shakeyo/MY-VAN/modules/09-shower-module/README.md

# 淋浴模块

帘式湿区 + 快拆防水盘，解决房车淋浴空间与日常活动的矛盾。固定式淋浴房占用面积过大（至少 0.6m²），对 V80 短轴车型不现实。帘式方案淋浴时拉开，平时收起，同一块地面既是过道又是淋浴区。

**核心思路**：用时展开、用完消失。防水帘沿顶部滑轨拉开围成湿区，防水盘快拆设计方便年审恢复。排水重力自流至灰水箱，无需电动排水泵。

## 子文档

| 文件 | 内容 | 状态 |
|---|---|---|
| [design.md](design.md) | 系统设计：帘轨、防水帘、防水盘、排水 | 设计中 |
| [bom.md](bom.md) | 材料清单 | 待补充 |

## 子系统

| 子系统 | 说明 | 状态 |
|---|---|---|
| 帘轨 | 顶部环形滑轨，固定于铝型材顶梁 | 待设计 |
| 防水帘 | 涤纶防水布 + 底部磁吸/配重，防飘水 | 待设计 |
| 防水盘 | 快拆式底盘，带地漏接口，可用折叠式或拼接式 | 待设计 |
| 排水快接 | 防水盘地漏 → 灰水箱，重力自流 | 待设计 |

## 车外淋浴

天气好时车外淋浴是主力场景（管路预留见 [05-water-system](../05-water-system/design.md#未来增项预留-车尾车外淋浴)）。车尾横向淋浴帐的完整设计单独成文：

- [车尾横向淋浴帐](../02-external/design-shower-tent.md) —— 车顶平台挂装、4 杆折叠框、卷袋收纳、接水盘、展开/收纳 SOP、BOM

## 跨模块依赖

- 帘轨锚固于 [01-vehicle-layout](../01-vehicle-layout/) 顶梁
- 排水接入 [05-water-system](../05-water-system/) 灰水箱
- 淋浴区地面与周边柜体（[07-cabinetry](../07-cabinetry/)）衔接

## BOM

统一材料清单见 [bom.md](bom.md)。

## 图片

<script setup>
const loaders = Object.values(import.meta.glob('./assets/*.{png,jpg,jpeg,PNG,JPG,JPEG,webp}', { eager: false }))
</script>

<AutoGallery :loaders="loaders" />
