shakeyo/MY-VAN/modules/06-hvac/README.md

# HVAC 系统

驻车空调、柴油暖风、换气扇的选型与安装。房车 HVAC 的特殊约束：驻车时不能用原车空调（需发动机运转），因此必须独立制冷/制热；车内空间小（~10m³），温度变化极快，设备功率需要匹配而非越大越好。

**核心思路**：制冷走顶、制热走地、换气走中。冷气下沉从顶棚出风，暖气上升从地板出风，换气扇在中部形成对流。能效优先——空调选变频、暖风用柴油（热值高且与车辆共用燃油）。

## 子文档

| 文件 | 内容 | 状态 |
|---|---|---|
| [design.md](design.md) | 系统设计：空调、暖风、换气扇选型与布局 | 设计中 |
| [bom.md](bom.md) | 材料清单 | 待补充 |

## 子系统

| 子系统 | 说明 | 状态 |
|---|---|---|
| 驻车空调 | 48V 变频顶置或分体空调，制冷量匹配车内面积 | 设计中 |
| 柴油暖风 | 驻车加热器，取油自原车油箱，暖风管走地板 | 设计中 |
| 换气扇 | 双向换气扇（排风+进风），中部安装形成对流 | 待设计 |
| 风道 | 出风口位置、管路走线、隔热包扎 | 待设计 |

## 跨模块依赖

- 空调外机安装位由 [01-vehicle-layout](../01-vehicle-layout/) 和 [02-external](../02-external/) 提供
- 供电由 [04-power-system](../04-power-system/) 48V 回路独立保险
- 柴油暖风取油需与底盘油路协同
- 换气扇开孔由 [00-chassis](../00-chassis/) 或侧壁开孔规范约束

## BOM

统一材料清单见 [bom.md](bom.md)。

## 图片

<script setup>
const loaders = Object.values(import.meta.glob('./assets/*.{png,jpg,jpeg,PNG,JPG,JPEG,webp}', { eager: false }))
</script>

<AutoGallery :loaders="loaders" />
