shakeyo/MY-VAN/modules/10-smart-control/media/README.md

# 监控与音响

视觉监控（DVR/Frigate）与全车音响（Alpine DSP）。

| 文件 | 内容 |
|---|---|
| [design.md](design.md) | 监控架构 + 音响架构 + 声场模式 |
| [bom.md](bom.md) | 材料清单 |

## 边界

- 额头柜喇叭物理安装位见 [07-cabinetry](../../07-cabinetry/)
- 娱乐场景（投影/显示器）音频输入切换见 [11-entertainment](../../11-entertainment/)
