shakeyo/MY-VAN/modules/04-power-system/design-distribution-box.md

# 中门智能配电箱

## 一、系统边界与物理布局

| 区域 | 归属 | 说明 |
|---|---|---|
| 额头柜配电箱 | 独立系统 | 48V 降压供点烟口、原车鼓风机、DSP、低音炮、MPPT 等，与本箱无关 |
| 中门配电箱 | 本方案范围 | 48V 进线 → 48V 水泵 + DCDC 降压 → 12V 灯/风扇/冰箱/控制 |
| 踏步 | 功率接原车电瓶 | 本箱仅出干接点控制信号 |
| 车内锁 | 12V 供电 | 由本箱 12V 回路经继电器控制 |

### 1.1 箱内物理布局

箱内布局正视图

```
┌─────────────────────────────────────────────────────┐
│  [降压器]          [48V保险盒]                       │
│  48V→12V           48V总分配+保护                    │
│                                                      │
│  [12V保险盒]        [负极端子排(桥接)]                    │
│  12V分配+保护       全系统负极汇流点                   │
│                                                      │
│  [8路485继电器模块] 右下，切所有负载                   │
│                                                      │
│  [端子排 功率区]    [端子排 控制区]                    │
│  底部               底部                              │
└─────────────────────────────────────────────────────┘
```

| 位置 | 设备 | 功能 |
|---|---|---|
| 左上 | 降压器 | 48V→12V 转换，40A |
| 右上 | 48V 保险盒 | 48V 总分配 + 保护 |
| 中左 | 12V 保险盒 | 12V 分配 + 保护 |
| 中部 | 负极端子排 | 黑端子 + 短接片桥接，暂代铜排；全系统负极汇流点 |
| 右下 | 8 路 485 继电器模块 | 逻辑控制 + 功率切换（详见 switch-assignment.md） |
| 底部 | 端子排 | 红色正极区 + 黑色负极区（桥接）+ 控制区（红/黑） |

### 1.2 架构图

> 本箱上游链路：电池 + → 源头熔断器 150A → 主断路器 125A（均在电池侧）→ 2×8AWG → 本箱总开关/总保险。整车全景见 [power-architecture.svg](./diagrams/power-architecture.svg)。

整车电力架构单线图

```
48V 电池组
    │
    ├──→ 2×8AWG ──→ [中门配电箱]
    │                   │
    │              [总开关 60A] ──→ [总保险 60A]
    │                   │
    │     ┌─────────────┼─────────────┐
    │     │             │             │
    │  48V保险盒      48V保险盒      DCDC 40A
    │  (动力回路)     (控制/备用)    降压模块
    │     │             │             │
    │  上水泵          接触器线圈    12V输出
    │  (经接触器)     48V供电       │
    │     │                         ▼
    │     │                    [12V保险盒]
    │     │                         │
    │     │         ┌───────────────┼───────────────┐
    │     │         │               │               │
    │  48V汇流排  12V控制系统    12V照明/通风    12V冰箱/锁/水阀
    │     │         │               │               │
    │     └─────────┴───────────────┴───────────────┘
    │                   │
    │              [8路485继电器模块]
    │                   │
    │         ┌─────────┴─────────┐
    │         │                   │
    │    中8/中4 DI → DI主管(14P)→中门柜汇总排    485总线
    │         │
    │    [输出端子排/插头]
    │
    └──→ 原车电瓶（踏步功率，独立）
              ▲
              │ 干接点信号
         [本箱继电器触点]
```

---

## 二、核心走线原则

1. **顺序不可改**: 电源 → 保险盒 → 继电器 COM → 继电器 NO → 端子排 → 负载
2. **正负成对出线**: 每负载的正负两根线成对捆扎同行，正 → 端子排正极区对应位，负 → 负极区（全桥接，任一位）；氛围灯/睡眠灯 4 路正极在 5-8 位并联，负极各自独立位（17/18）
3. **功率与信号分离**: 功率线（粗）与 485 通信线、按钮线（细）分槽走线
4. **非隔离系统共负**: 48V 与 12V 负极在电气上相通，统一回中部负极端子排（短接片桥接）
5. **继电器触点不得接在端子排之后**: 端子排 → 继电器 → 负载 会导致继电器到负载段无保险保护

---

## 三、48V 主配电方案

### 3.1 进线与总保护

| 项目 | 规格 | 接法 |
|---|---|---|
| 总进线 | 2×8AWG 硅胶线（并联） | 正极并联后压 OT8-8 铜鼻 → 总开关输入 |
| 总开关 | 48V DC 隔离开关，≥60A | 柜内最左上方，带明显断开点 |
| 总保险 | 60A 直流保险片/断路器 | 紧挨总开关，正极串联 |
| 总负极 | 2×8AWG 并联 → OT8-8 | 直接压 48V 负极汇流排 |

> 2×8AWG 并联载流约 80A，总保护 60A 留有余量。

### 3.2 48V 保险盒分配（建议 6 路）

| 保险位 | 设备 | 电流 | 线径 | 负极回哪 |
|---|---|---|---|---|
| F48-1 | DCDC 降压模块输入 | 20A | 6mm² | DCDC 48V- → 负极端子排（桥接） |
| F48-2 | 上水泵主回路 | 15A | 2.5mm² | 水泵负极 → 48V 汇流排 |
| F48-3 | 备用 48V 输出 | 5A | 1.0mm² | —（原接触器线圈位，已取消接触器） |
| F48-4 | 备用 48V 输出 | 10A | 1.5mm² | — |
| F48-5 | 备用 48V 输出 | 10A | 1.5mm² | — |
| F48-6 | 备用 48V 输出 | 10A | 1.5mm² | — |

**接线方式**：

- 保险盒总正极输入：6mm² 红线，OT6-6 压保险盒总螺丝
- 保险盒总负极：6mm² 黑线，OT6-6 压 48V 汇流排
- 各路输出：对应线径，OT 铜鼻直接压保险盒分路螺丝
- **大功率回路（F48-1/2）不走 UK 端子排**

---

## 四、12V 子系统方案

### 4.1 DCDC 降压模块

| 项目 | 参数 |
|---|---|
| 输入 | 48V（来自 F48-1） |
| 输出 | 12V / 40A |
| 安装位置 | 配电箱内左上角，周围 5cm 无线缆遮挡散热 |
| 接线 | 48V 输入：6mm² 红线 + 黑线，OT 铜鼻直连；12V 输出：≥10mm² 红线 → 12V 保险盒总正极，黑线 → 负极端子排（桥接） |

> **关键**：必须先确认模块是否隔离型（万用表通断档测 48V- 与 12V-）。非隔离型可在柜内单点连通两个汇流排；隔离型严禁连通。绝大多数 DCDC 为非隔离型。

### 4.2 12V 保险盒分配（12 路箱，现用 7 路，余 5 路预留）

| 保险位 | 设备 | 电流 | 线径 | 负极回哪 |
|---|---|---|---|---|
| F12-1 | 控制系统 + 485 + 电控水阀 + 车内锁 + 踏步 + **ESP32 + 16DO/面板LED**（控制组） | 10A | 1.5mm² | 负极端子排（桥接） |
| F12-2 | 主灯 + 氛围灯 + 睡眠灯 | 10A | 1.5mm² | 负极端子排（桥接） |
| F12-3 | 后窗排气扇（4 小风扇） | 5A | 0.75mm² | 负极端子排（桥接） |
| F12-4 | 冰箱 | 10A | 1.5mm² | 负极端子排（桥接） |
| F12-5 | 点烟器 1（二排座椅后） | 15A | 2.5mm² | 负极端子排（桥接） |
| F12-6 | 点烟器 2（中门柜） | 15A | 2.5mm² | 负极端子排（桥接） |
| **F12-7** | **N100 + 路由器（尾门台面 · 12V 直供）** | **5A** | **1.5~2.5mm²** | 负极端子排（桥接） |

> F12-2 出一根 1.5mm² → 到模块处分叉 → R1.COM + R2.COM。保险盒输出到继电器 COM 段极短（几 cm），安全。

> 氛围灯多路灯带合并为一路，共用一个保险丝 + 一个继电器，出线后在负载端用 WAGO 端子分接。

> **供电归属（三块地 · 控制组 vs 算力组）**：
> - **中门柜**：ESP32 网关 + 16DO 模块 + 两面板 LED 均就地取 12V，挂 **F12-1 控制组**（mA 级，可合一路）。16DO **不占用**点烟器 F12-6。
> - **中门配电柜**：中8/中4 模块供电仍在箱内控制区取，挂 F12-1 控制组。
> - **尾门台面**：N100（12V 直供）+ 路由器挂 **F12-7 独立 5A**，正负极对由中门沿「柜→尾门」路径拉线（与倒车灯同路径可共线槽，但电不共用——倒车灯挂中8.Y7 触点、随灯断电，N100/路由为常电，**绝不挂 Y7 触点后**）。

---

## 五、负极汇流方案（暂用端子排桥接，后期换铜排）

### 5.1 铜排选型

| 项目 | 规格 |
|---|---|
| 材质 | 紫铜镀镍 |
| 尺寸 | 2mm 厚 × 15mm 宽，5~7 孔位 |
| 螺丝 | M5 |
| 底座 | 绝缘底座，固定于箱体中部 |
| 载流量 | ≥60A |

> 所有线必须压接 OT/UT 铜鼻子，禁止裸线直接拧螺丝。

### 5.2 负极走线

```
电池总负 → 48V保险盒负极汇流
                │
                └──→ 6mm² 黑线（OT端子）→ 中部负极端子排（桥接）
                                                │
        ┌───────────────────────────────────────┼───────────────────────┐
        ↓                                       ↓                       ↓
  12V保险盒负极                          各负载负极                  485模块/水表负极
  （短跳线）                        （回负极端子排）     （控制电源负极）
```

> 因降压器为非隔离型，输入负极与输出负极内部导通。从 48V 保险盒负极引一根 6mm² 黑线到负极端子排即可，无需从电池总负再单独拉线。

### 5.3 48V 与 12V 汇流排关系

| DCDC 类型 | 处理方式 |
|---|---|
| 非隔离型（绝大多数） | 48V- 与 12V- 内部导通，共用一个负极端子排（桥接）即可 |
| 隔离型 | 严禁连通，需两个独立汇流排 |

---

## 六、控制架构方案

### 6.1 485 继电器模块（分职能架构）

> **架构决策（最终定稿，2026-10-30 更新）**：配电箱 DO 全留给负载（稀缺资源、藏墙不拆）。
> **LED 不再集中**：有负载的键 LED 直接并到该路继电器 NO（负载侧直连），只有场景键用空余 DO 做逻辑 LED
> （中8.Y8 离车驻车 / 中4.Y4 灯光模式）；**16DO 已退役备用**。详见
> [switch-assignment.md §决策更新](switch-assignment.md#决策更新2026-10-28--定稿2026-10-30--与下方旧章节冲突时以本节为准) 的 决1~决4。
> 下方 6.1 的表格是**旧口径历史记录**，冲突处以 switch-assignment.md 的「在役映射总表」为准。

**模块清单（分职能）**：

| 模块 | 来源 | 路数 | 位置 | 职能 |
|---|---|---|---|---|
| **中8** | 现有 | 8 DI + 8 DO（10A） | 配电箱 | 负载 7 路 + **Y8 离车驻车逻辑LED**；DI 只读入口 3 键 |
| **中4** | 现有 | 4 DI + 4 DO（**5A**） | 配电箱 | 3 路低功率负载 + **Y4 灯光模式逻辑LED**；4 路 DI 全空 |
| ~~**16DO**~~ | 已到货 | 16 DO（5A） | 中门柜 | **已退役备用**（决4），不上总线 |
| **驾驶室A/B** | 已有1台+待买1台 | 4DI+4DO ×2（5A） | 额头柜 | 驾驶室 6 键 + 功率负载（原「额头 8 路」**未购买**） |

**关键变化（相对旧方案）**：

1. **车尾不再单独设模块** —— 倒车灯负载并进中8 一路 DO，电源从中门[中8.Y7]拉一对线到车尾（切正极，负极回中门负排）。不再新购"车尾 4 路模块"。
2. **上水泵（48V，几十瓦）直接用中8 一路 Y 切**，不再用接触器 —— 几十瓦小功率，模块触点(10A)绰绰有余；但它是感性负载，必须**并续流二极管 1N5408**（见 §6.3）。
3. **额头柜用 8 路模块**，为后期扩展（更多灯/设备）预留通道。
4. **LED 全走 16DO（5A，一个485地址）**，ESPhome 配一个设备、12 个开关实体，最简洁。配电箱 DO 全留给负载。

**负载（中8，7 路占用 + 1 预留）**：

| Y | 负载 | 电压 | 备注 |
|---|---|---|---|
| Y1 | 主灯 | 12V | |
| Y2 | 氛围灯+睡眠灯 | 12V | 同一路，多灯并 |
| Y3 | 后窗排气扇 | 12V | 4 小风扇 |
| Y4 | 上水泵 | **48V** | 几十瓦感性，续流二极管 |
| Y5 | 电控水阀 | 12V | |
| Y6 | 冰箱 | 12V | |
| Y7 | 倒车灯 | 12V | 车尾并进，拉长线 |
| Y8 | 预留 | — | 未来扩展 |

**LED（全部走 16DO，12 现用 + 4 预留）**：

| LED | 16DO 的 Y | 跟踪 |
|-----|---|---|
| 入口键1 排水 | Y1 | 中8.Y5 |
| 入口键2 户外灯 | Y2 | 额头.R2 |
| 入口键3 上水泵 | Y3 | 中8.Y4 |
| 入口键4 离车/驻车（单色） | Y4 | 场景 |
| ~~主控键1-6~~ | ~~Y5-Y10~~ | **已取消**（决2）：主灯/氛围/排气扇/泵/冰箱 LED 改负载侧直连；灯光模式 LED = 中4.Y4 |
| 车尾扩展1 / 2 | Y11 / Y12 | 未来 |
| 预留 | Y13-16 | 未来按钮 |

**DI（按钮输入，中8 X + 中4 X + 额头）**：

> ⚠ 下表为**旧口径历史记录**。现行 DI 分配（决1/决2/决3，2026-10-30）：
> 中8 **X1 排水 / X2 上水泵 / X4 离车驻车**（X3 空、X5-X8 空）；**中4 四路全空**；
> 额头 **X1 射灯 / X2 倒车灯 / X3 DSP / X4 换气风扇 / X5 户外灯 / X6 灯光模式**。
> 中门主控面板 6 键已取消。

| 模块 | DI 分配（旧） |
|---|---|
| 中8 X1-X4 | 入口面板 4 键（排水/户外灯/上水泵/离车驻车） |
| 中8 X5-X8 | 主控面板键1-4（主灯/氛围/排气扇/上水泵） |
| ~~中4 X1-X2~~ | ~~主控键5-6~~ **已取消**（决2），4 路 DI 全空 |
| 中4 X3-X4 | 预留（未来分散独立按钮） |
| 额头 | 驾驶室面板 + 扩展 |

> **扩展策略**：未来增加的"分散独立按钮"，DI 接 中4 X3-X4、额头空闲 DI；LED 接 16DO.Y13-16（余4）；负载接 中8.Y8 + 中4.Y1-4（余5）。再不够就在 485 总线上再挂一个模块 —— 永远不动现有接线。详细通道分配见 [switch-assignment.md](switch-assignment.md)。DI/LED 已随汇总方案并进中门柜汇总排（中4.X3-4→汇总DI11/12、16DO.Y13-16 就地并），新按钮从中门柜汇总排出线。

### 6.2 继电器接线顺序

```
保险盒输出端（受保险保护）
        │
        ├──→ 负极线 → 直接到负极端子排（不受继电器控制）
        │
        └──→ 正极线 → 继电器 COM（公共端）
                        │
              继电器 NO（常开）──→ 端子排对应负载正极位
                                        │
                                    负载正极
```

- 继电器线圈电源：从控制区端子取 12V，线圈负极接模块输出
- **禁止**：继电器触点接在端子排之后（端子排 → 继电器 → 负载），否则继电器到负载段无保险保护

### 6.3 48V 水泵控制详图（几十瓦 · 直接 Y 切 + 续流二极管）

> **决策变更（2024 定稿）**：上水泵仅几十瓦（电流约 1~2A），**不再用接触器**，直接用中8 一路继电器 Y 切。但它是**感性负载**（线圈/电机），断电瞬间会产生反向尖峰高压，必须**并续流二极管**保护继电器触点。

```
12V/48V 电源回路（以 48V 为例）：
48V 保险盒 F48-2 ——→ 中8.Y4-COM（进电侧）
中8.Y4-NO（常开）——→ 上水泵正极+
上水泵负极- ————→ 48V 负极汇流排
```

**续流二极管（1N5408，耐压 1000V/3A）并联在负载线圈两端**：

```
  线圈+ ──┬──────────────
           │
           │ ← 二极管阴极（有环/白圈那端）接线圈正极 +
         [▷|]  1N5408
           │
           │ ← 二极管阳极接线圈负极 −
  线圈− ──┴──────────────
```

- **方向铁律**：有环的一端永远朝电源正极（阴极朝正），反向并联。
- 平时二极管反偏不导通；断电瞬间反电势让它正向导通，泄放尖峰，保护触点和 485 通讯。

> **✅ 隔离已实测确认（2024）**：万用表量「中8.Y 的 COM」与「模块 VCC+ / GND」**不通（无穷大）**，即继电器触点是隔离干接点。因此 48V 泵可与其他 12V 负载同一块中8（Y4 单独走 48V，其余 Y 走 12V），各自 COM 接各自电源、负极回各自汇流排，互不影响。**唯一铁律：48V+ 绝不搭到模块 12V/GND 上。**

### 6.4 踏步控制详图

> **2026-10-30 更新**：踏步（电动踏板）的**收回**改由「睡眠模式」自动触发，信号走 **中8.Y3**（中门配电箱，就近踏板），
> 三档物理接法（脉冲短接 / 保持短接 / 切门碰信号线）**待实测定档** —— 详见
> [switch-assignment.md §决7](switch-assignment.md#决7电动踏板睡眠模式自动收回2026-10-30-取代原入口键4-物理兜底)。
> 本节描述的是**原车踏步控制线**的接法（仍然有效），R5 的触点按决7 的档位并/串到这些线上。

本箱不供功率，只出干接点：

```
本箱 12V 侧：
F12-1(10A 控制回路，内含踏步) → 小型 12V 继电器线圈+（或用模块 R 通道直接驱动）
线圈- → 负极端子排（桥接）

该继电器触点 COM/NO → 引出到 UK 端子排 TB-STEP-A/B
→ 接原车踏步控制线（需确认原车是"高电平触发"还是"短接触发"）
```

- 若原车踏步是"短接即动作"：用模块干接点 COM/NO 直接短接原车控制线
- 若原车踏步是"12V 高电平触发"：用本箱 12V 继电器触点引出 12V 信号

### 6.5 面板连接（中门柜汇总方案）

按键/LED 分配、芯定义见 [switch-assignment.md](switch-assignment.md) §七。**中门柜（16DO 处）为信号汇接中心**：DI 从配电箱集中拉一根主线进中门柜汇总排，LED 阴就地并汇总排，面板各自一根复合线从中门柜汇总排直连。

- **DI 汇总主干**（14P，仅用 3 芯）：配电箱 **中8.X1/X2/X4** → 中门柜汇总排（原 12 芯已随主控面板/户外灯键取消而缩为 3 芯）
- **入口面板**（4 键）：入口复合线（14P）→ 中门柜汇总排（DI1-4 + Y1-Y4）
- ~~**主控面板**（6 键）：主控复合线（14P）~~ → **已取消（决2），这根线不再做**
- **16DO 阴极限**：Y1-10 就地并进中门柜汇总排
- **驾驶室面板** → 额头模块（另案，不在本箱/本汇总范围）
- **床头面板** → 自带 4DI+4DO 模块（**规划中，暂不实施**），见 [switch-assignment.md §三之二](switch-assignment.md)

> **年审拆装**：汇总排两侧（面板复合线 + DI 主干 + 16DO 阴极限）都在中门柜一侧，统一在中门柜侧拔，配电箱侧不动。
> **LED**（决4）：按键 LED 一律负载侧直连（并到该路 Y 的 NO），场景键用 中8.Y8 / 中4.Y4 逻辑 LED；16DO 已退役。

### 6.6 面板线缆选型（中门柜汇总方案）

信号线统一规格：

| 项 | 规格 |
|----|---|
| 线径 | 0.5mm² 多股软线 |
| DI 主干外皮 | 灰色 |
| 面板复合线外皮 | 蓝色 |
| 接头 | JST SM 或 XH，**全车面板线均为 14P**（主干 / 入口复合 / 主控复合），靠线皮颜色+标签防呆 |
| 屏蔽 | 靠近干扰源（DCDC/逆变器）段改 RVVP 屏蔽线，屏蔽层单端接 GND |

**全车统一色序（14 芯唯一标准）**：位1 黑=GND、位2 红=+12V、位3-8=DI 段（白/黄/灰/淡绿/深绿/棕）、位9-14=LED 段（蓝/黑白/粉/橙/红白/紫）。同一位置永远同一颜色，备线只需一种。芯定义与去向见 switch-assignment.md §七 统一色序表及各线表。

### 6.7 单个按键接线详图（继电器切正极 + 16DO LED 软件同步）

单个带灯按键的 3 个回路

每个带灯按键涉及三个回路：**开关检测**、**LED 指示灯**、**负载驱动**。DI 干接点和 LED 阴都先汇到**中门柜汇总排**，负载继电器仍在配电箱（中8/中4），由 ESPhome 软件同步：

```
按键开关（自复位）：
  COM ──── GND（复合线 #1 黑）
  NO  ──── DIx（复合线 DI 芯）

按键 LED（内置于开关）：
  灯+ ──── +12V（复合线 #2 红，共阳，从汇总排 +12V 取）
  灯- ──── 电阻 1-3.3kΩ ──── 16DO.Yx.COM（经汇总排 LED 区）
  16DO.Yx.NO ──── GND（汇总排 GND）  ← 吸地开关

负载（灯/风扇/锁等）功率回路：
  保险盒输出+ → 继电器 COM → 继电器 NO → 端子排 → 负载+
  负载- → 负极端子排（桥接，常通）
```

```
   面板侧                  复合线（→中门柜汇总排）        汇总排/模块
   ┌──────┐                ┌──────────────┐            ┌──────────┐
   │ 按键 │  NO ──────────→│   DI 芯       │ ──────────→│ DI(中8/中4经主干) │
   │      │  COM ─────────→│   GND(#1)     │ ──────────→│ GND      │
   │ LED+ │  +12V ────────→│   +12V(#2)    │ ←─────────│ +12V(控+)│
   │ LED- │  阴极 ────────→│   LED阴芯     │ ──────────→│ 16DO.Yx  │
   └──────┘                └──────────────┘            └──────────┘
                     (中门柜汇总排：DI + LED + GND + 12V 统一出口)
```

> **同步机制**：ESPhome 监听中8/中4 的 DI 状态（经 DI 主干到中门柜），触发对应 16DO 的 Yx 吸合 → Yx.NO 接 GND → LED 阴被拉低 → 亮。负载继电器由同一 DI 触发同时吸合。LED 只是指示灯（mA 级）。
>
> **上水泵**（决1/决4）：只剩**入口键2（中8.X2）**一个物理入口（主控键4 已取消），切 中4.Y1 线圈；按键 LED 并到 中4.Y1 输出侧。
>
> **两个 COM 不要混**：按键开关 COM 接 GND（DI 内部上拉，按下拉低触发）；继电器干接点 COM 接负载正极（切正极）；16DO Y.COM 接 LED 电阻（阴侧）、Y.NO 接 GND。
>
> **焊并点**：面板侧焊并（GND + 12V，详见 switch-assignment §七）+ 汇总排并线（16DO 阴极限、GND 合并），不在走线途中并线。
>
> **模块供电**：中8/中4 模块供电仍在配电箱内焊并接电源+控制区端子（挂 F12-1 控制组）；16DO 供电与 **ESP32 网关**均在中门柜就地取 12V（也挂 F12-1 控制组），不进配电箱。DI 主干只搬干接点 DI 信号，不搬模块供电。N100 + 路由器在尾门台面，单独挂 **F12-7（5A）**，正负极对随「柜→尾门」路径拉线，见 §4.2。

---

## 七、端子排分组规则

端子排位于箱体底部，分**功率区**和**控制区**，中间用隔板分隔。

### 7.1 功率区

按负载分组，正极各自独立（不桥接），负极全桥接。顺序按线长排列：

端子排布局（功率区 + 控制区）

**正极区（红色，独立）**：

| 位 | 负载 | 来自 | 线径 |
|----|---|---|---|
| 1 | 点烟器1+ | F12-5 直连（不经继电器） | 2.5mm² |
| 2 | 点烟器2+ | F12-6 直连（不经继电器） | 2.5mm² |
| 3 | 冰箱+ | 中8.R8.NO | 1.5mm² |
| 4 | 主灯+ | 中8.R1.NO | 0.75mm² |
| 5-8 | 氛围灯/睡眠灯+ | 中8.R2.NO，4 位并联供电 | 各路 0.75mm² |
| 9 | 后窗排气扇+ | 中8.R4.NO | 1.0mm² |
| 10 | 电控水阀+ | 中8.R7.NO | 0.75mm² |
| 11-12 | 预留 | — | — |

> 倒车灯已并进中门 8 路模块（中8.Y7 切，电源拉线到车尾），驾驶室键2 经 ESPhome 跨模块驱动 —— 本箱端子排不再有倒车灯位，与 [switch-assignment.md](switch-assignment.md) §四/§八 一致。

> 位 5-8 用短接片并联，各路独立出线。无需 WAGO，端子排本身做分配。

**负极区（黑色，短接片全桥接，替代铜排）**：

| 位 | 负载 | 备注 |
|----|---|---|
| 13 | 点烟器1- | |
| 14 | 点烟器2- | |
| 15 | 冰箱- | |
| 16 | 主灯- | |
| 17 | 氛围灯- | 与睡眠灯走线分开 |
| 18 | 睡眠灯- | 床头有独立物理开关 |
| 19 | 后窗排气扇- | |
| 20 | 电控水阀- | |
| 21-22 | 预留 | |

> 位 13-22 用 UK 短接片连成一体 → 引 6mm² 黑线到电池总负。后期买到负极铜排后迁移。

> 上水泵主回路（48V 大电流）不走端子排 —— 保险盒 OT 直连接触器 COM，接触器 NO 直连水泵。

### 7.2 控制区（独立隔板分隔）

| 端子位 | 接法 |
|---|---|
| 控+（蓝） | 12V 保险盒 F12-1 → 2A 保险 → 此处（并接 2-3 位） |
| 控-（灰） | → 负极端子排（桥接） |
| 控A | 中8 模块 12V+ |
| 控B | 中4 模块 12V+（跨接线引出到柜内） |
| 控C | 中8 模块 GND |
| 控D | 中4 模块 GND（跨接线引出） |
| 备用 | — |

### 7.3 信号线（独立走线槽，不过端子排）

| 信号类型 | 走向 | 要求 |
|---|---|---|
| 按钮开关 DI | 中8/中4 DI 口 → DI 主干(14P) → 中门柜汇总排 → 面板 | 干接点，经 DI 主干集中搬，不过配电箱端子排 |
| 水表脉冲 | 直接 → 485 模块输入 | 不过端子排 |
| 485 通信线（A/B/GND） | 485 模块 ↔ 上位机/ESP32 | 单独走线槽，双绞，远离功率线 |

---

## 八、线径与端子规格

| 线路 | 线径 | 端子/处理方式 |
|---|---|---|
| 48V 主进线 | ≥6mm²（8AWG×2 并联） | OT 裸铜鼻子，M5 螺丝 |
| 48V 分支 | 2.5~4mm² | OT/UT 端子 |
| 降压器 12V 输出 → 12V 保险盒 | ≥10mm² | OT 裸铜鼻子 |
| 12V 分支（水泵/灯/风扇） | 0.75~2.5mm² | UT/OT 端子 |
| 氛围灯合并总线 | 2.5mm² | UT/OT 端子 |
| 控制电源（485/水表） | 1.0~1.5mm² | 冷压端子或弹簧端子 |
| 信号线（DI/LED） | 0.5~0.75mm² | 冷压端子或焊锡 |
| 负极汇流干线 | 6mm² | OT 裸铜鼻子 |

---

## 九、线束与插头方案

| 线束 | 插头 | 芯数 | 备注 |
|---|---|---|---|
| DI 汇总主干（配电箱 → 中门柜汇总排） | JST SM 14P（或 XH 14P） | 14 | 灰皮 · 灰标签 |
| 入口复合线（中门柜汇总排 → 入口面板） | JST SM 14P | 14 | 蓝皮 · 蓝标签 |
| ~~主控复合线（中门柜汇总排 → 主控面板）~~ | JST SM 14P | 14 | **已取消（决2）** |
| 16DO 阴极限（16DO → 汇总排） | 就地并 | — | 同柜零长，不进插头 |
| **N100+路由器供电（配电柜 → 尾门台面）** | Deutsch DT04-2P | 2 | 12V 正负对 · 走柜→尾门路径 · 红标签（挂 F12-7） |
| 12V 灯/风扇（每路） | Deutsch DT04-2P | 2 | 黑色壳 + 黄标签 |
| 冰箱 | Deutsch DT04-2P 或 Superseal | 2 | 黑色壳 + 白标签 |
| 48V 水泵 | Anderson SB50 蓝色 | 2 | 蓝色壳 + 红标签 |
| 踏步控制（接原车） | Deutsch DT04-2P | 2 | 橙色壳（警示色） |
| 485 通讯 | Phoenix 3.5mm 端子 或 GX12-3 | 3 | 绿色标签 |

> **防呆铁律**：
> - 面板信号线全用 JST（小电流信号），负载功率线全用 Deutsch DT（大电流），系列不同无法互插；
> - DI 主干(14P) 与 入口复合线(14P) 同尺寸，靠**外皮颜色**（主干灰 / 复合线蓝）+ **线号标签**防呆；
> - 48V 插头与 12V 插头绝不能用同系列同色。48V 用 Anderson SB50 蓝色，12V 用 Deutsch DT，一眼区分。

---

## 十、施工步骤（按顺序执行）

**步骤 1 — 安装负极端子排（桥接）**
- 在配电箱中部空余位置固定绝缘底座，安装桥接端子排
- 从 48V 保险盒负极压接一根 6mm² 黑线（OT 端子）到铜排

**步骤 2 — 接负极回路**
- 12V 保险盒负极 → 短跳线 → 铜排
- 485 模块负极、水表负极 → 控制区端子负极位 → 铜排
- 所有负载负极预留回铜排路径

**步骤 3 — 接 48V 正极主干**
- 电池 48V+ → 总开关 → 总保险 → 48V 保险盒输入+
- 48V 保险盒输出+ → 各 48V 负载支路

**步骤 4 — 接降压器**
- 48V 保险盒 F48-1 → 降压器输入+
- 降压器输入- → 48V 保险盒负极
- 降压器输出+ → 12V 保险盒输入+
- 降压器输出- → 12V 保险盒输入-（经铜排连通）

**步骤 5 — 接 12V 正极分配**
- 12V 保险盒输出+ → 各 12V 支路（大功率负载经继电器）

**步骤 6 — 接继电器功率回路**
- 每路：保险盒输出+ → 继电器 COM → 继电器 NO → 端子排功率区正极位
- 继电器固定于导轨，与保险盒一一对应

**步骤 7 — 接控制电源**
- 12V 保险盒 → 2A 保险 → 控制区端子排 `[控制电源+]`（并接多位）
- 控制区 `[控制电源-]` → 铜排
- 485 模块电源、水表电源从控制区并接

**步骤 8 — 接信号线**
- 按钮线直接进 485 模块 DI 口（不过端子排）
- 水表信号线直接进 485 模块
- 485 A/B 通信线单独捆扎，沿边缘走线，远离功率线

**步骤 9 — 接负载出线**
- 端子排功率区 → 各负载正极
- 各负载负极 → 端子排负极位 → 铜排

**步骤 10 — 整理与标识**
- 功率线用扎带分层捆扎（48V、12V 分开）
- 每根线两端贴标签：`12V-主灯+`、`48V-水泵-` 等
- 保险盒每个位置贴标签
- 端子排每位贴标签
- 检查所有铜鼻子压接是否牢固，无裸露

---

## 十一、箱内走线整理（线束优化）

不改器件、不剪线、不焊线，只重新分束和贴边。目标是中间区域空出来，线都在四边和底板深处，像"框"而不是"网"。

### 1. 负载正极红线 → 分三束

中间出来的红线按去向分成三束，分别捆紧贴边：

| 去向 | 走法 | 贴哪里 |
|---|---|---|
| 去 12V 保险 / DC 降压（左上） | 向左上方走 | 贴箱体左边框竖上去 |
| 去 48V 保险（右上） | 向右上方走 | 贴箱体上边框横过去 |
| 去 485 / 控制区（右侧） | 向右下方走 | 贴底板深处平过去，别浮在表面 |

短线悬空打圈是乱的主要来源，捆成一束贴着边/底，交叉立刻少一半。

### 2. 负极线 → 全部贴底

所有回负极的黑线，从设备端子出来后直接下垂到箱体底部，贴着底板横走回左下角负极区。

- **不要**从设备端子斜飘到负极区
- **走成 ┐└ 形状**：先垂到底 → 再横着贴底走

### 3. 控制区正极 → 485 模块 → 拉直

两排离得近，线短就最短路径直着走：

- 长度刚好够水平 → 贴着底板排一条横线
- 短到只能斜着 → 保持斜直一条，单独捆一束，别和负载红线混

### 4. 粗线 → 走外围

48V 进线、DC 降压线的粗红黑线沿箱体最外圈走，像画框：

- 48V 进线从右上进 → 贴顶边走到 48V 保险
- DC 降压输入线贴左边上去
- DC 降压输出线贴左边下来到 12V 保险

粗线在外圈，细线在内圈，物理分层。

### 5. 信号线 → 走线槽

DI 汇总主干（14P）从配电箱 中8/中4 的 DI 口引出后，走线槽兜一圈，槽内剥皮散开，从不同槽口出线分别到 DI / GND / 控+：

```
DI主管(14P，用3芯) ──→ [走线槽] ──→ 槽口1 → 中8.X1/X2/X4（排水/泵/离车）
                          ──→ 槽口2 → GND
                          ──→ 槽口3 → 控+（+12V 备用）
```

> 主干另一头出配电箱拉到中门柜汇总排。LED 阴极限（16DO）不进配电箱，直接在中门柜侧并进汇总排；面板复合线从中门柜汇总排出，不进配电箱。

走线槽盖一扣，外面只看到进槽的粗线和出槽口到模块的短跳线。

### 操作顺序

1. **先搞负极线**：所有黑线从端子拔出，理顺后重新插，插一根就贴着底板扎一根
2. **再搞负载正极红线**：按三个方向分三拨，拨好一拨捆一拨，贴着边走
3. **最后粗线和信号线**：粗线走外圈，信号线入槽

搞完效果：中间空，线在四边和底板，视觉干净。线太短连贴边都不够的，保证独立一束不缠绕，斜直走也能接受。

---

## 十一A、线缆标签命名规范

> **目的**：接线和理线最简单、方便后续维护。每根线两端贴标签，格式统一 `模块-性质-去向`，一眼能看出线接哪、干什么。配合线色分层，谁接手都能维护。

**命名格式**：`模块-性质-去向`

- **模块**：中8 / 中4 / 16DO / 额头 / 电源 / 保险 / 485
- **性质**：负载+ / 负载- / LED阴 / DI / 供电+ / 供电- / A / B / GND / COM
- **去向**：接到哪个设备或端子

### 负载功率线（束4 · 红正黑负）

| 标签 | 含义 |
|---|---|
| `中8-负载+-主灯` | 中8.Y1.NO → 主灯正极（红） |
| `中8-负载+-氛围` | 中8.Y2.NO → 氛围灯正极（红） |
| `中8-负载+-排气扇` | 中8.Y3.NO → 排气扇正极（红） |
| `中8-负载+-上水泵` | 中8.Y4.NO → 泵正极（红·48V粗） |
| `中8-负载+-水阀` | 中8.Y5.NO → 水阀正极（红） |
| `中8-负载+-冰箱` | 中8.Y6.NO → 冰箱正极（红） |
| `中8-负载+-倒车灯` | 中8.Y7.NO → 倒车灯正极（红·拉线到车尾） |

> 负极黑线统一标 `-负载名`（如 `-主灯`、`-排气扇`），因负极全回同一负排，去向可简写。

### 保险进线（保险盒 → Y.COM）

| 标签 | 含义 |
|---|---|
| `保险F12-2-COM-Y1Y2` | F12-2 → 分叉 Y1/Y2 COM（主灯+氛围共用） |
| `保险F12-3-COM-Y3` | F12-3 → Y3.COM（排气扇） |
| `保险F48-2-COM-Y4` | F48-2 → Y4.COM（48V 泵） |
| `保险F12-1-COM-Y5` | F12-1 → Y5.COM（水阀） |
| `保险F12-4-COM-Y6` | F12-4 → Y6.COM（冰箱） |
| `保险F12-6-COM-Y7` | F12-6 → Y7.COM（倒车灯） |

### LED 指示线（16DO 阴极限就地并进中门柜汇总排）—— ⚠ 16DO 已退役（决4），下表为历史标签

> 现行 LED 走线：按键 LED 阳极 +12V、阴极经 1~3.3kΩ 并到该路负载继电器 Y 的 NO；
> 场景键 LED 接 中8.Y8（离车驻车）/ 中4.Y4（灯光模式）的 COM/NO。

| 标签 | 含义 |
|---|---|
| `16DO-LED阴-入口键1` | 16DO.Y1.COM → 汇总排 Y1 |
| `16DO-LED阴-入口键2` | 16DO.Y2.COM → 汇总排 Y2 |
| `16DO-LED阴-入口键3` | 16DO.Y3.COM → 汇总排 Y3 |
| `16DO-LED阴-入口键4` | 16DO.Y4.COM → 汇总排 Y4 |
| `16DO-LED阴-主控键1` | 16DO.Y5.COM → 汇总排 Y5 |
| `16DO-LED阴-主控键2` | 16DO.Y6.COM → 汇总排 Y6 |
| `16DO-LED阴-主控键3` | 16DO.Y7.COM → 汇总排 Y7 |
| `16DO-LED阴-主控键4` | 16DO.Y8.COM → 汇总排 Y8 |
| `16DO-LED阴-主控键5` | 16DO.Y9.COM → 汇总排 Y9 |
| `16DO-LED阴-主控键6` | 16DO.Y10.COM → 汇总排 Y10 |
| `16DO-LED阴-车尾1` | 16DO.Y11.COM → 汇总排 Y11 |
| `16DO-LED阴-车尾2` | 16DO.Y12.COM → 汇总排 Y12 |

> LED 阳极（共阳）统一标 `LED+共阳`（红），从中门柜汇总排 +12V 端子取（控+ 引出）。16DO 阴极限在中门柜内就地并进汇总排 LED 区，面板 LED 阴从汇总排对应 Y 端子取。

### DI 按钮输入线（DI 主干搬干接点进汇总排）

DI 主干（14P）从配电箱把 12 路 DI + GND + 12V 集中搬到中门柜汇总排，标签按「模块-DI-去向」：

| 标签 | 含义 |
|---|---|
| `中8-DI-入口键1` | 中8.DI1 → (主干位3) → 汇总排 DI1 |
| `中8-DI-入口键2` | 中8.DI2 → (主干位4) → 汇总排 DI2 |
| `中8-DI-入口键3` | 中8.DI3 → (主干位5) → 汇总排 DI3 |
| `中8-DI-入口键4` | 中8.DI4 → (主干位6) → 汇总排 DI4 |
| `中8-DI-主控键1` | 中8.DI5 → (主干位7) → 汇总排 DI5 |
| `中8-DI-主控键2` | 中8.DI6 → (主干位8) → 汇总排 DI6 |
| `中8-DI-主控键3` | 中8.DI7 → (主干位9) → 汇总排 DI7 |
| `中8-DI-主控键4` | 中8.DI8 → (主干位10) → 汇总排 DI8 |
| `中4-DI-主控键5` | 中4.DI1 → (主干位11) → 汇总排 DI9 |
| `中4-DI-主控键6` | 中4.DI2 → (主干位12) → 汇总排 DI10 |
| `中4-DI-预留` | 中4.DI3/DI4 → (主干位13/14) → 汇总排 DI11/DI12 |

### 通讯与供电（束1 + 束2）

| 标签 | 含义 |
|---|---|
| `485-A` | 485 A 线（白·对绞） |
| `485-B` | 485 B 线（黑·对绞） |
| `485-GND` | 485 信号地（独立） |
| `中8-供电+` | 中8 VCC+ 红 12V |
| `中8-供电-` | 中8 GND- 黑 |
| `中4-供电+` | 中4 12V 红（控B跨箱） |
| `中4-供电-` | 中4 GND- 黑（控D跨箱） |
| `16DO-供电+` | 16DO VCC+ 红 |
| `16DO-供电-` | 16DO GND- 黑 |

### 执行要点

1. **每根线两端各贴一张标签**（标签打印机或防水标签）。
2. **贴标签位置**：线端冷压端子之后 3~5cm 处，两头都贴。
3. **标签文字朝外**，便于顺着线读。
4. **同色线靠标签区分**：束4 里 7 根红线，全靠标签区分是哪路负载。
5. **标签与 SVG 图编号一一对应**：图中的 Y1/Y2…、X1/X8…、DI1/DI12、汇总排 Y1/Y12 位号，就是标签里的编号来源。

---

## 十二、安全检查清单

- [ ] 所有接线端子均已压接铜鼻子，无裸铜外露
- [ ] 保险盒 → 继电器 → 端子排顺序正确，无跳接
- [ ] 48V 与 12V 线束未平行捆扎（交叉处垂直）
- [ ] 485 通信线与功率线分槽/分离
- [ ] 降压器周围 5cm 内无线缆遮挡散热
- [ ] 负极端子排（桥接）绝缘底座安装牢固，未触碰金属箱体
- [ ] 每路保险丝额定值 = 负载电流 × 1.25~1.5 倍
- [ ] 控制电源单独 2A 保险，未与大功率负载共保险
- [ ] 所有 OT 铜鼻液压钳压接，包热缩管，螺丝打扭矩
- [ ] 逐路通电验证：48V 总进线 → 测 DCDC 输出 → 12V 控制模块 → 灯 → 风扇 → 水泵（最后）
- [ ] 水泵试车前确认接触器线圈电压、续流二极管方向、主回路相序

---

## 十三、箱体安装支架（铝型材）

| 型材 | 规格 | 数量 | 用途 |
|---|---|---|---|
| 2040 | 135mm | 2 根 | 箱体主支撑横梁 |
| 2040 | 90mm | 1 根 | 底部加强撑 |
| 2020 | 90mm | 1 根 | 辅助固定 |

> 型材下料时长度预留 10mm 余量，用 T 型螺母 + 角码连接后可微调胀紧，避免箱体晃动。
