shakeyo/MY-VAN/modules/07-cabinetry/design-overhead.md

# 额头柜面板

目标尺寸 **1440 × 270 mm**，浅木纹面板 + 黑色网罩。面板包含两侧喇叭开孔和中间上翻柜门。

> 音响系统的功放、布线、音源见 [11-entertainment](../11-entertainment/design-audio.md)。本模块仅负责面板木工及喇叭物理安装位。

## 喇叭开孔（木工）

- **数量**: 2 个
- **开孔直径**：φ146 mm
- **网罩外径**：φ170 mm（黑色亚光）
- **喇叭中心高度（Y）**：120 mm
- **左喇叭中心**：(205, 120)
- **右喇叭中心**：(1235, 120)

## 柜门参数

- **尺寸**：590 × 150 mm
- **左上角**：(425, 45)
- **右下角**：(1015, 195)
- **门缝**：3 mm

## 横向分配（从左到右）

| 区域 | 宽度 |
|---|---|
| 左边距 | 120 mm |
| 左喇叭区 | 170 mm |
| 左过渡区 | 135 mm |
| 中间柜门 | 590 mm |
| 右过渡区 | 135 mm |
| 右喇叭区 | 170 mm |
| 右边距 | 120 mm |

## 高度分配

- 总高：270
- 喇叭中心高：120
- 柜门上边距：45
- 柜门高：150
- 柜门下边距：75

## 边角处理

- 面板外角：**R10~R15**
- 柜门角：**R6~R10**

## 柜门结构

- 上沿铰链
- 下沿暗扣手槽
- 磁吸或房车按压锁

## 外观材质

- 面板：浅橡木/白蜡木纹
- 柜门：同色木纹
- 喇叭罩：黑色亚光

## 柜底下沿：平板支架安装位（2026-09 新增）

**额头柜底下沿挂一块横屏平板**（小米平板4，200.2×120.3mm），3D 打印斜角支架，见
[10-smart-control/n100-ha/tablet-mount.md](../10-smart-control/n100-ha/tablet-mount.md)。

> ⚠ **为什么是"柜底下沿"而不是"装在面板上"**：本面板总高仅 **270mm**，
> 平板高 120.3mm（横屏）看似能放，但横向 200mm 的唯一空间就是**中间 590mm 的上翻柜门**
> ——装了平板**柜门就打不开**。两侧喇叭区（170mm）与过渡区（135mm）都不足 200mm。
> 所以只能挂在**柜底垂直向下**。

**木工需配合**：

| 项 | 要求 |
|----|---|
| 柜底板厚 | **≥15mm**（4 颗 M4 螺丝从下往上固定支架）；薄板需内侧加木条背衬 |
| 柜底板平整 | 支架顶面贴合柜底，不平会晃/异响 |
| 净空 | **柜底到仪表台/挡风玻璃 ≥140mm**（支架外廓高，实测确认） |
| 走线孔 | 柜底开 φ8mm 进线孔（USB 电源），边角倒圆防割线 |
| 结构加强 | 柜底承重仅平板 350g + 支架，**常规板即可**；但螺丝孔位避开喇叭腔体 |

> **视角提示**：额头处是**坐姿**观看，眼位比水槽前更低，**倾角需重新算**，
> 不能照搬水槽前的 20-22°。建议先做纸样比划。
