shakeyo/MY-VAN/modules/02-external/design-rear-storage.md

# 车尾储物箱与自行车架

## 方案概述

通过拖车杠方口（2" receiver）统一接口挂载，年审时可整体取下。拖车杠安装见 [00-chassis](../00-chassis/)。

## 安装接口

- 拖车杠方口规格：2"（约 50×50 mm）标准 receiver
- 方口中心高度：按 V80 大梁预埋孔位，待实测
- 承重上限：方口本身额定约 150 kg 垂向载荷，储物箱 + 自行车架总重控制在此范围内

## 车尾储物箱

- 材质：铝合金 / 钢板喷涂，防水密封
- 安装方式：方口插杆 + 紧固销，底部可加辅助支撑腿分担垂向弯矩
- 尺寸：待按实车后门开度和车牌位确定
- 注意：不影响后门开启（尾门为对开式，需留出门扇摆动空间）

## 自行车架

- 类型：挂式自行车架（方口安装），可载 2 辆
- 安装方式：插杆插入自行车架底座，紧固销锁定
- 与储物箱可共用方口（上下错位），或使用方口扩展 Y 型分叉件
- 折叠机制：空载时可向上翻折贴近尾门，减少车长

## 年审处理

- 方口插销取出，整体卸下，不影响原车外观
- 拖车杠本体留在大梁上（隐蔽，不影响年审）

## 跨模块依赖

- 拖车杠安装见 [00-chassis](../00-chassis/build-rear-mount.md)
- 如需尾灯/牌照灯移位或增补，电力接入 [04-power-system](../04-power-system/)
