shakeyo/MY-VAN/modules/00-chassis/design.md

# 设计决策：底盘

## 方案概述

底盘预处理是房车改装的第一步，所有后续工程的基础。

## 施工内容

详见 [build-chassis.md](build-chassis.md)。

## 关键决策

| 项 | 方案 | 原因 |
|----|---|---|
| 防锈处理 | 全车底盘装甲喷涂 | 预防锈蚀，延长车体寿命 |
| 开孔原则 | 先定位后开孔，即时密封 | 防止进水锈蚀 |
| 挂载加固 | 开孔位加钢板/加强筋 | 水箱、备胎等重载挂点 |

## 跨模块参考

- 底盘开孔位置由 [01-vehicle-layout](../01-vehicle-layout/) 总体布局决定
- 水路/电线底盘穿孔与 [04-power-system](../04-power-system/) [05-water-system](../05-water-system/) 配合
