shakeyo/MY-VAN/modules/02-external/design-platform.md

# 铝型材框架平台

## 方案概述

3060 欧标铝型材相框式平台，采用下沉式设计，兼顾美观与低风阻。

## 结构模型 (3060/3030 Hybrid)

- **外框**: 3060 欧标铝型材（竖立安装，高 60mm，宽 30mm），四周 45 度角切合，形成封闭"相框"。
- **内梁**: 3030 欧标铝型材（高 30mm），安装在 3060 外框底部槽口。
- **承重**: 3060 竖立安装提供高纵向支撑力。

## 优势

- 45 度拼接避免裸露切面，美观
- 下沉式安装减少风噪与高速空气阻力

## 铝型材规格 (黑色氧化)

- **纵梁**: 3060 欧标 (2 根)，2500mm (45 度外长内短)
- **前后横梁**: 3060 欧标 (2 根)，1600mm (45 度外长内短)
- **承重内梁**: 3030 欧标 (4-6 根)，1540mm (直切)

## 连接件与辅料

- **角部连接**: L 型平连接板 (上下双层夹持)
- **内梁固定**: 强力角码 + T 型螺母
- **车身锚固**: L 型固定角码 (固定至原车立筋)
- **降噪密封**: 欧标 30 系列黑色槽盖条 (20 米)
- **结构胶**: 西卡 252 或 221 (黑色)

## 施工流程

### 1. 地面组装
- 拼装 45 度角外框，使用双层平连接板加固
- 安装 3030 内梁，调整间距以适配太阳能板
- 填充槽盖条以消除潜在风噪

### 2. 车顶锚固
- 上车定位，避开天窗位置
- 侧向钻孔固定至原车立筋，钻孔处喷漆 + 铁锈转化剂
- 螺丝孔位与接触面填充西卡结构胶

### 3. 系统集成
- 安装太阳能板压块，锁死至内梁
- 布线接入 MPPT 充电控制器

## 安全规范

- 所有连接件螺栓点上蓝色螺纹胶 (如乐泰 243)
- 定期检查角部连接件是否松动或变形
- 车顶立筋钻孔处定期检查密封胶状态，防雨水渗入夹层
