shakeyo/MY-VAN/modules/02-external/design-solar.md

# 太阳能板（物理安装）

## 安装方式

- 太阳能板放置在 3030 内梁上，安装后与外框上边缘基本齐平
- 使用太阳能板压块锁死至内梁

## 尺寸适配

- 内梁间距按太阳能板实际尺寸调整
- 预留走线孔位接入 MPPT 充电控制器

## 跨模块引用

- 电气接入、MPPT 配置、电池充电策略见 [04-power-system](../04-power-system/)
