shakeyo/MY-VAN/modules/07-cabinetry/design-bed-cabinet.md

# 右侧床段柜

近尾门，白天储物，夜间作为后横床的右半张。

## 基本参数

- **柜顶高度**：= 床基座高度（需与 [08-bed-and-seat](../08-bed-and-seat/) 床基座齐平，待实测确认）
- **深度**：视床宽而定
- **位置**：台面段后方，尾门前方

## 功能

- **白天**：储物柜体
- **夜间**：床垫从基座抽拉至此柜顶，连成整张后横床

## 关键约束

- 柜顶必须与床基座**完全齐平**，否则拼不成整张床
- 柜顶需能承载人体重量（通过床垫分散）
