shakeyo/MY-VAN/modules/08-bed-and-seat/design-dinette.md

# 折叠卡座

## 方案概述

通过铝型材框架实现轻量化、模块化，通过折叠扩展机制平衡日常活动空间与乘坐舒适度。

## 尺寸与人体工程学

- **坐高**: 框架 ~380mm，加 50mm 床垫后总坐高 ~430mm
- **宽度**: 800mm（1 大 1 小或两人并排）
- **深度**:
  - 折叠状态：~350mm，释放过道空间
  - 展开状态：上翻板扩展至 500–550mm

## 靠背设计

- 多级调节：100°–115° 倾斜
- 复用后横床的拼接床垫，通过魔术贴固定

## 铝型材框架

- **主框架**: 2020/2040 欧标铝型材（黑色氧化）
- **连接件**: 强力角码 + 活页合页 + 胶头手拧螺栓
- **折叠扩展**: 外侧钢琴合页连接翻板，下方滑出支架托举
- **深度补偿**: 翻板展开后，靠背垫平铺至翻板上

## 冰箱集成

- 框架下方预留 ~400×550×450mm 空间
- 53 宽重型滑轨适配 35L 抽拉式车载冰箱
- 散热：箱体侧面开百叶窗孔位 + 12V 散热风扇
- 若上翻冰箱，卡座顶板需设计为分段开启式

## 侧边储物

- 框架余量空间侧开门，存放零食、餐具
- 侧边框预留 USB + 220V 插座孔位

## 安全与年审

- **防撞止推**: 框架前端（靠车头方向）横向铝材封顶，防急刹穿刺
- **快拆**: 底部 4 颗手拧螺栓锁在座椅滑轨或预埋木方上
- **年审**: 翻板收回、拿掉床垫 → 视觉上为工具储物箱
