shakeyo/MY-VAN/modules/10-smart-control/gateway/design.md

# ESP32 485 网关

> 全系统位置见 [smart-architecture.svg](../diagrams/smart-architecture.svg)（三级架构总图）；总线物理拓扑见 [04-power-system/485-bus.svg](../../04-power-system/diagrams/485-bus.svg)。

## 架构

ESP32 运行 ESPHome 固件，作为 Home Assistant 的无线节点和 485 总线网关，**不是 HA 主机**。负责将 HA 指令转换为 485 总线信号，并采集总线设备状态回传 HA。

```
HA (N100) ← WiFi → ESP32 (ESPHome) ← UART → MAX3485 ← RS485 → 总线设备
```

## 485 总线规范

- **拓扑**: 手拉手串联，**严禁星型或分支**
- **终端电阻**: 总线首尾 A/B 之间并联 120Ω 0.5W（末端当前在**中4**端——16DO 已退役；接床头模块后移至床头端）
- **屏蔽层**: 单端接地（仅 ESP32/主控端接地，末端悬空）
- **波特率**: **全车终局 9600 8N1（整车统一定稿）** —— MPPT（易科 Fcu）最高只支持 9600，故全车统一降速（规划源 [energy/mppt-protocol.md §二](../energy/mppt-protocol.md)）
  - ⚠ **当前固件仍为 38400**（模块出厂默认，桌面联调阶段）：MPPT 上车前必须改为 9600（FC06 写 0033H=1，操作步骤见 [build-guide.md 阶段 4.7](build-guide.md)），改模块的同时把固件 4 处 `baud_rate` 一起改掉
  - ⚠ 波特率代码各家不同：**MPPT 的 9600 = 代码 4**，**继电器模块的 9600 = 代码 1**，设置时勿混
- **地址（2026-10-30 定稿，只针对继电器模块）**：`0x01 留空（中门预留）` · `0x02~0x03 中门配电箱（中8/中4，沿用原有地址不改）` · `0x04 分界线` · `0x05~0x0F 额头柜（驾驶室A/驾驶室B/8DO + 8 个预留）`。能源设备不参与：0x10(MPPT)、0x20+(传感器)。库仑计 TF03K 不在本总线（19200 独立 UART）
- **总线末端**: 当前最末端为**中4**（中门配电箱内，16DO 退役后）；接入床头模块后末端移到床头端，120Ω 随之移动
- **强弱电分离**: 485 信号线与 12V 负载供电线间距 ≥15cm，禁止同管走线

## 模块清单

> **站号顺序 = 物理布置顺序**（2026-10-30 定稿）：中门配电箱的 中8/中4 沿用出厂地址 **0x02/0x03 不改**，
> 额头柜三台新模块顺延排到 **0x05/0x06/0x07**；**0x04 为分界线，不分配**。

| 地址 | 模块 | 位置 | 通道 | 职责 |
|---|---|---|---|---|
| 0x01 | （留空） | 中门箱 | — | 中门预留位 |
| **0x02** | 中门 8 路 | 配电箱内 | 8DI + 8DO（10A） | 主灯 / 氛围灯带 / **后横床顶灯** / 车尾灯（Y4·Y5·Y6·Y8 预留） |
| **0x03** | 中门 4 路 | 配电箱内 | 4DI + 4DO（5A） | 泵线圈 / 水阀 / 后窗扇（**Y4 = 踏板收回信号**） |
| **0x04** | — | — | — | **分界线（不分配）** |
| **0x05** | 驾驶室 A | 额头柜 | 4DI + 4DO（5A） | 射灯/DSP 大继电器线圈 + 户外灯 + 副驾扇 + 4 键 |
| **0x06** | 驾驶室 B | 额头柜 | 4DI + 4DO（5A） | 场景键 2（灯光模式 / 离车驻车） |
| **0x07** | 8DO | 额头柜 | 8DO（5A） | 场景键双色 LED ×2 + 倒车灯 LED |
| 0x08~0x0F | （预留） | 额头柜 | — | 额头柜扩展 |
| ~~0x05~~ | ~~中门 16DO~~ | 中门柜内 | 16DO（无 DI） | **已退役备用**（决4），不再挂总线 |

> **LED 分工（2026-10-31 终局）**：有负载的键 → **负载侧直连**（LED 并到该路 Y 的 NO，状态=真实得电、不经固件）；
> 无负载可并的两个场景键 → **8DO（0x07）** 驱动 **双色** LED：
> 灯光模式 = Y1/Y2 红/绿（`led_scene_sync`）、离车驻车 = Y3/Y4 红/绿（`led_camp_sync`）、车尾灯 = Y5（跟随 中8.Y7）。
> ⚠ 早期「中8.Y8 = 离车驻车 LED、中4.Y4 = 灯光模式 LED」的逻辑 LED 方案**已作废**：
> 中4.Y4 改作**踏板收回信号**（决7），中8.Y4~Y8 全部回归预留。16DO 退役备用。

## ESP32-S3 ↔ MAX3485 接线

MAX3485 是 3.3V 收发器，与 S3 电平完全匹配，RO/DI 直连无需分压。

| ESP32-S3 | MAX3485 | 说明 |
|---|---|---|
| 3V3 | VCC | 3.3V 供电，严禁接 5V |
| GND | GND | 共地（必须单点共地） |
| GPIO15 (TX) | DI | 发送 |
| GPIO16 (RX) | RO | 接收 |
| GPIO17 | DE + RE（并接） | 高=发送、低=接收（**由固件 rs485.yaml 手动切换**，未用 modbus flow_control_pin） |

## 固件架构

单 ESP32-S3 集中编译，packages 组装（详表见 [esphome/README.md](esphome/README.md)）。

- **写帧公共件 `rs485.yaml`**：`rs485_write` 参数化脚本统一处理
  `DE置1 → 1ms → uart.write → flush → DE置0 → 10ms`；通道动作只写一条帧，不再复制时序代码
- **按键 = 模块主动上传驱动**：上电写 FC06 `0031H=1` 开启，模块输入变化即发
  `<地址> 04 <字节数N> <N字节位图> <CRC>`；固件 100ms 读缓冲解析，**零轮询**
  - 位图字节数按模块自适应（中8=2、中4 可能=1），按帧内 `N` 算帧长 `3+N+2` 后验 CRC
- **LED = 直连为主**：负载侧直连（硬件完成，无固件参与）+ 两个场景键双色 LED 由 **8DO（0x07）** 驱动（`led_scene_sync` / `led_camp_sync`）
- **自动化全在本地**：按键→继电器联动（场景/双控/离车）不依赖网络或 HA

## 供电

- S3 扩展底板：内置 12V（6~24V）→ 5V/3.3V 降压，直接吃车载 12V，S3 插板载母排
- MAX3485 从 S3 的 3V3 取电（3.3V 收发器，与 S3 电平完全匹配，RO/DI 直连无需分压）
- 12V 进线侧并联 1000μF 电解电容，抑制车载电压尖峰（可选）

## 焊接要求

- 焊点饱满，无虚焊、无连锡
- 所有地线统一共地，单点汇聚接地，杜绝多点接地环流
- 信号线套热缩管绝缘
