shakeyo/MY-VAN/modules/10-smart-control/esp32-485/design.md

# ESP32 485 网关

## 架构

ESP32 运行 ESPHome 固件，作为 Home Assistant 的无线节点和 485 总线网关，**不是 HA 主机**。负责将 HA 指令转换为 485 总线信号，并采集总线设备状态回传 HA。

```
HA (N100) ← WiFi → ESP32 (ESPHome) ← UART → MAX485 ← RS485 → 总线设备
```

## 485 总线规范

- **拓扑**: 手拉手串联，**严禁星型或分支**
- **终端电阻**: 总线首尾 A/B 之间并联 120Ω 0.5W
- **屏蔽层**: 单端接地（仅 ESP32/主控端接地，末端悬空）
- **波特率**: 9600（稳定性优先）
- **强弱电分离**: 485 信号线与 12V 负载供电线间距 ≥15cm，禁止同管走线

## ESP32 ↔ MAX485 接线

| ESP32 | MAX485 | 说明 |
|---|---|---|
| 5V | VCC | MAX485 需 5V 供电 |
| GND | GND | 共地（必须单点共地） |
| GPIO16 (RX) | TX | ESP32 接收 ← MAX485 发送 |
| GPIO17 (TX) | RX | ESP32 发送 → MAX485 接收 |
| GPIO18 | DE/RE | 自动收发控制 |

## 供电

- 车载稳压模块：12V/24V 转 5V 3A
- 输入端并联 1000μF 电解电容 + 0.1μF 瓷片电容，抑制车载电压波动

## 焊接要求

- 焊点饱满，无虚焊、无连锡
- 所有地线统一共地，单点汇聚接地，杜绝多点接地环流
- 信号线套热缩管绝缘
