shakeyo/MY-VAN/site/index.md

---
layout: home

hero:
  name: "MY-VAN"
  text: "AI 驱动的全栈开源房车"
  tagline: 模块化 · 智能化 · 轻量化 · AI 驱动 — 一套可拆检、可恢复、可迭代的开源房车改装方案
  actions:
    - theme: brand
      text: 查看全部模块
      link: /modules/
    - theme: alt
      text: 从底盘开始
      link: /modules/00-chassis/
    - theme: alt
      text: GitHub
      link: https://github.com/shakeyo/MY-VAN

features:
  - icon: 🧩
    title: 模块化架构
    details: |
      11 个功能模块，每个独立设计、独立施工、独立拆卸。
      三体块箱体 + 铝型材骨架 + 快接水路 — 年审时恢复空车不费力。
  - icon: 🧠
    title: 三级智能控制
    details: |
      N100 Home Assistant 中枢 → ESP32 485 总线网关 → 分布式继电器终端。
      计算中心化、控制去中心化、冗余机械化。
  - icon: ⚡
    title: 48V 星型配电
    details: |
      48V 磷酸铁锂 + 多源充电（行车/太阳能/市电）。
      星型拓扑、源头熔断、模块化隔离、硬件急停。
  - icon: 🪶
    title: 铝型材轻量化
    details: |
      2020/2040/3060 欧标铝型材框架体系，角码 + T 型螺母连接。
      比传统木方减重 40%+，强度更高，可反复拆装不松脱。
  - icon: 🛡️
    title: 安全冗余设计
    details: |
      所有功率回路独立保险、接触器隔离 48V 动力回路。
      续流二极管保护、碰撞拦阻结构、强弱电物理隔板。
  - icon: 🔓
    title: AI 驱动 · 开源
    details: |
      全部设计、施工、BOM 由 AI 驱动完成，GitHub 完全开源。
      不藏私、可复现、可 Fork 适配你自己的车型。

---
## 12 个模块 · 按施工顺序

| 阶段 | 编号 | 模块 |
|---|---|---|
| 基础 | **00** | 底盘 — 装甲喷涂、防锈、开孔加固 |
| 总纲 | **01** | 整车布局 — 三体块方案、保温、框架、遮阳帘 |
| 外观 | **02** | 车顶系统 — 铝型材平台、太阳能、灯光、储物 |
| | **03** | 外观装饰 — 三段式拉花、贴纸、轮毂黑化 |
| 管线 | **04** | 电力系统 — 48V 电池、配电箱、充电、布线 |
| | **05** | 用水系统 — 水箱、水泵、快接管路、排水 |
| | **06** | HVAC — 驻车空调、柴油暖风、换气扇 |
| 内饰 | **07** | 柜体与台面 — 额头柜、台面段、床段柜 |
| | **08** | 床铺与座椅 — 后横床抽拉、折叠卡座 |
| | **09** | 淋浴模块 — 帘式湿区、快拆防水盘 |
| 集成 | **10** | 智能控制 — N100/HA、ESP32/485、传感器、监控 |
| | **11** | 影音娱乐 — 投影、显示器、全车音响 |

## 核心理念

### 可拆检 · 年审友好

全部体块通过角码 + 螺栓压紧地台预埋点。进出水快接、电路插头化、模块独立拆卸。年审时松螺栓、断快接，恢复空车。

### 先外后内 · 先结构后装饰

施工严格按序：底盘 → 车顶 → 外观 → 管线预埋 → 木工 → 软装 → 淋浴 → 智控 → 影音。每阶段不反复、不返工。

### 文档即施工标准

每个模块含设计决策 (design.md)、施工指南 (build-guide.md)、材料清单 (bom.md)。图文对照、参数明确、可直接按文档施工。
