shakeyo/MY-VAN/site/modules/index.md

# 模块索引

本项目按功能域组织，编号反映施工顺序。

## 基础

| 编号 | 模块 | 内容 |
|---|---|---|
| 00 | [底盘](00-chassis/) | 底盘装甲、防锈、开孔加固、底盘挂载 |

## 总纲

| 编号 | 模块 | 内容 |
|---|---|---|
| 01 | [整车布局与结构](01-vehicle-layout/) | 总体设计、地板、保温、框架、遮阳帘 |

## 外观 / 外部

| 编号 | 模块 | 内容 |
|---|---|---|
| 02 | [外部扩展](02-external/) | 车顶平台、太阳能、灯光、储物箱、扰流板、车尾储物箱、自行车架 |
| 03 | [外观装饰](03-exterior-appearance/) | 车身拉花、贴纸、装饰件 |

## 管线系统

| 编号 | 模块 | 内容 |
|---|---|---|
| 04 | [电力系统](04-power-system/) | 电池、逆变器、充放电、全车布线 |
| 05 | [用水系统](05-water-system/) | 水箱、水泵、管路、排水 |
| 06 | [HVAC 系统](06-hvac/) | 空调、暖风、换气 |

## 内饰

| 编号 | 模块 | 内容 |
|---|---|---|
| 07 | [柜体与台面](07-cabinetry/) | 额头柜 + 右侧柜排（台面段 & 床段） |
| 08 | [床铺与座椅](08-bed-and-seat/) | 后横床 + 折叠卡座 |
| 09 | [淋浴模块](09-shower-module/) | 帘式湿区、防水盘、排水快接 |

## 集成

| 编号 | 模块 | 内容 |
|---|---|---|
| 10 | [智能控制](10-smart-control/) | N100/HA、ESP32/485、继电器、传感器、监控 |
| 11 | [影音娱乐](11-entertainment/) | 投影幕布、投影仪、显示器、键鼠收纳、全车音响 |

## 施工顺序

```
底盘 → 车顶 → 外观 → 管线预埋 → 木工柜体 → 软装家具 → 淋浴 → 智控 → 影音
 00     02     03     04-05-06      07         08        09      10      11
```
