shakeyo/MY-VAN/modules/10-smart-control/n100-ha/tablet-mount.md

# 平板支架（水槽前 + 额头柜下 + 吊顶，3D 打印）

> 状态：**方案定稿**（脚本 + STL + STEP 已生成并校验，待现场确认安装高度与净空）。
> **三处安装**：
> ① 水槽下方柜体正面（主位，壁挂，固定倾角）
> ② 额头柜下沿（副位，壁挂，固定倾角）
> ③ **吊顶悬吊（副位，坐姿仰视，必须可调角，可旋下收纳）**
>
> **不做抽拉**，用 **3D 打印支架**；**参数化脚本见 [tablet-mount.scad](tablet-mount.scad)**
> （改数值即出 STL，两处用途共用一个脚本）。

## 一、平板实测尺寸（小米平板4 8"）

| 项 | 值 |
|----|-----|
| 外形 | **200.2 × 120.3 × 7.9 mm** |
| 横屏 | 200.2 宽 × 120.3 高 |
| 竖屏 | 120.3 宽 × 200.2 高 |
| 重量 | ≈ 350 g |

> **三处都用横屏**（200 宽 × 120 高）——仪表 Dashboard 横屏更自然，
> 且横屏"顶部撑出"只有竖屏的一半（见 §三）。

## 二、为什么选这两块位置

**① 水槽下方柜体正面**：水槽盆体占深，这块面板后面放不了东西——天然"废位"。
在操作动线上，走线近，不占储物。

**② 额头柜下沿**：额头柜面板（1440×270mm）本身是喇叭箱体 + 上翻柜门，
**柜门区域不能占**（要能翻开）。**挂在柜底下沿**（贴柜底垂直向下），
不干涉柜门与喇叭。

> ⚠ **额头柜面板本身放不下平板**：面板高仅 270mm，平板 200mm 高，
> 且中间 590mm 是上翻柜门、两侧是 φ170mm 喇叭。
> 横向唯一 ≥200mm 的空间就是柜门本身——**占了就打不开柜门**。
> 所以只能是"**柜底下沿**"，不是"装在面板上"。

## 三、几何计算（横屏）

支架内腔 = 平板 + 每侧 1mm 取放间隙：

| 项 | 值 |
|----|-----|
| 内腔 | **202.2 × 122.3 mm** |
| 外廓（含托边、压边悬垂、壁厚） | **208.2 × 136.3 × 15.9 mm** |
| 腔深 | 7.9（平板）+ 5（托边）+ 3（背板）= **15.9 mm** |

**顶部撑出 D = 支架外廓高 × sin(θ)**：

| 倾角 θ | 顶部撑出 D |
|---|---|
| 15° | 35.3 mm |
| **20°** | **46.6 mm** |
| **22°** | **51.1 mm** |
| 25° | 57.6 mm |

> **水槽前推荐 θ = 20-22°，撑出约 47-51mm。**
> 横屏比竖屏撑出小得多（竖屏要 69-85mm），凸出感明显更好——**这也是选横屏的原因之一**。

## 四、倾角方向：⚠ 别装反

面板位置低（底部 40-50cm）、眼睛高（站立 155cm）→ **眼睛是俯视它的**。
要让**屏幕面朝上后方**（顶沿向人倾出）：

| 面板姿态 | 屏幕法线偏离视线 |
|---|---|
| 垂直（0°） | 20.2° |
| **顶沿倾出 20°** | **2.7°** ✅ |
| 顶沿倾出 30° | 6.3° |
| 顶沿**收进** 20° | 37.3° ❌ |

> **顶沿向人倾出，不是向内收。** 装反了偏离 37°，比不倾斜还差。

## 四之二、⚠ 吊顶位置：方向反转，且**必须可调角**

吊顶（顶棚）是**上下颠倒**的场景，倾角逻辑完全不同：

| | 水槽前（壁挂） | **吊顶（悬吊）** |
|---|---|---|
| 面板位置 | 低（40-70cm） | **高（顶棚 ~200cm）** |
| 眼睛位置 | 高（站立 155cm） | **低（坐姿 ~120cm）** |
| 视线方向 | 俯视 ↓ | **仰视 ↑** |
| 屏幕面朝 | 上后方 | **下前方**（像飞机座椅屏） |
| 倾角方向 | 顶沿**向人倾出** | **底沿向人倾出**（顶沿贴顶） |
| 倾角需求 | **固定 20-22°** 够用 | **14-48°，跨度 35° → 必须可调** |

**为什么吊顶必须可调**（坐姿眼高 120cm、吊顶 200cm，落差 80cm）：

| 人距屏幕下方 | 视线仰角 | 屏幕需向下倾 |
|---|---|---|
| 20 cm | 76.0° | 14.0° |
| 30 cm | 69.4° | 20.6° |
| 50 cm | 58.0° | 32.0° |
| 70 cm | 48.8° | 41.2° |
| 90 cm | 41.6° | 48.4° |

> **坐得越远，屏幕要越水平**。从 20cm 到 90cm，所需倾角从 14° 变到 48°
> ——**固定角度做不到**。这正是你说的 **1/4 螺纹 + 球头**的用武之地 ✅

### 吊顶受力（比壁挂严峻）

| 项 | 值 |
|----|-----|
| 平板 + 支架 | ≈ 350 g → **拉力 3.4 N（350 gf）** |
| 重心偏心 8cm → **弯矩 0.27 N·m（2.8 kgf·cm）** |
| 颠簸 2-3g → 等效拉力 **700-1050 gf** | 

> ⚠ **球头是摩擦锁紧**：水平悬吊 + 恒定力矩 → **会缓慢下垂**，比壁挂更明显。
> **必须选带锁紧旋钮的球头**，或用**齿盘式俯仰关节**（咬合自锁，不怕颠簸）。

### 你的 1/4 螺纹预埋：强度要点

| 预埋基体 | 做法 |
|---|---|
| **木板（顶棚）** | **必须用金属 T 型螺母 / 预埋螺母**；直接对木板攻丝会滑牙，350g 悬吊 + 颠簸会拔脱 |
| **打印件** | 用**热熔铜螺母**（烙铁压入），座体加厚 ≥9mm + 加强筋；不要靠打印螺纹受力 |

> 1/4" = **6.35mm**。相机螺孔标准件便宜好买，球头/云台/延长杆全兼容。

## 五、旋转结构：两种方案对比

> **结论先行**：**水槽前 + 额头柜下用固定楔形（不旋转）**；
> **吊顶必须可调**（1/4 球头带锁紧，或齿盘关节）。

### 方案 A：单轴铰链 + 齿盘锁（**推荐**）

```
        ┌────────────┐
        │   平板壳    │
        └─────┬──────┘
              │ ← 水平轴
        ╔═════╧═════╗
        ║  齿盘咬合   ║  ← 齿盘自锁，调档位
        ╚═════╤═════╝
              │
        ┌─────┴──────┐
        │  墙面底座   │
        └────────────┘
```

| 优点 | 缺点 |
|---|---|
| **齿盘咬合自锁**，颠簸不下垂 | 角度是**档位式**（如每 10°），非无级 |
| 结构简单、强度高、全靠打印件 | 需自己设计齿盘（但很成熟） |
| 绕水平轴 = 调**俯仰**，正对视线 | 换位置要整套一起搬 |
| 无金属件依赖（可用打印销轴） | — |

### 方案 B：壳内置 1/4 螺母 + 球头（你的提议）

| 优点 | 缺点 |
|---|---|
| **任意角度**、无级调节 | 球头靠摩擦锁紧，**颠簸会缓慢下垂** |
| **可整体取下**（拧下球头即拿走） | 1/4 螺母预埋需**加强结构**（否则连根拔出） |
| 球头是成熟商品，几元~几十元 | 多了金属件与装配公差 |
| 两处位置可共用同一个壳 | 球头云台进深较大 |

**承重校核**：平板 350g，力臂按 100mm → 静态力矩约 **0.34 N·m（3.5 kgf·cm）**。
常见 1/4 球头云台额定 1-3kg，**静态足够**；但**颠簸冲击可达 3-5 倍**，
所以必须选**带锁紧旋钮**的球头，或加辅助支撑。

### 方案 C：双轴（俯仰 + 水平旋转）

- 俯仰调角度 + 水平转方向，可竖横屏切换
- 结构复杂、零件多、强度下降
- **只在"两处都用、且要转方向"时才值得**

### 推荐

**水槽前用方案 A**（固定安装、齿盘调角、最稳）；**若你想两个位置共享一个壳、能取下来**，
则用方案 B（1/4 螺母 + 带锁紧球头），代价是颠簸需复查下垂。

> 建议先做**方案 A 的固定楔形版**（连齿盘都不要，直接 20° 一体成型）试用——
> 结构最简单、最稳。**实测确认角度合适后**，再决定要不要上可调结构。
> 换句话说：**先不要旋转，先验证角度与位置**；旋转是"锦上添花"，不是第一版必需。

## 六、平板固定：托边 + 压边（不用磁吸）

磁吸在这个场景不成立：面板倾 20° → **重力沿斜面下滑**，磁吸只有法向力，
抗滑靠摩擦；加上车在跑，会滑落。改纯机械：

```
        压边（顶部，L 形：前唇压住上沿 2mm + 横梁防脱出）
      ┌──────────────────────────┐
      │                          │
      │         平板              │  200.2 × 120.3
      │                          │
      └──────────────────────────┘
       ↑ 托边（底部，承重 + 定位，深 5mm / 高 8mm）
```

| 部位 | 做法 |
|---|---|
| **底部托边** | 深 5mm、高 8mm，承全部重量 + 定位 |
| **顶部压边** | **L 形**：前唇压住上沿 2mm + 横梁防脱出；取放 = 底部先斜插托边、上沿压入前唇下方 |
| **左右限位** | 侧壁 3mm 厚（内腔两侧各留 1mm 取放间隙） |
| **散热** | 背板 φ4 阵列孔（4×8）+ **两侧通风槽**（壁挂时背板被底座挡住，靠侧槽对流） |

> ⚠ **材料必须 PETG**（或 ASA/ABS）。车内暴晒 60-70°C，**纯 PLA 会软化**，支架塌了砸平板。

## 七、两处安装要点

### 7.1 水槽下方柜体正面

| 项 | 做法 |
|----|---|
| 位置 | 柜体正面中下部，支架宽 208mm（柜面宽 600-700mm，**占不到 1/3** ✅） |
| 固定 | 4× M4 木螺丝 → 面板厚 **≥15mm**；薄板**内侧加木条背衬** |
| 找平 | 支架底部贴泡棉条（面板不平会晃/异响） |
| 走线 | USB 从支架底部 φ8 圆角孔进，**固定在支架上**（不动，无疲劳） |
| 供电 | 12V→5V 3A 降压模块放柜内，**高于盆底排水口**、防溅 |
| 按钮 | 支架**下方留 2-4 颗物理按钮**（排水/水泵/主灯/排气扇） |

> ⚠ **安装高度待确认**：你说面板底沿离地 **40-50cm**，但支架外廓高 136mm
> （若上沿贴台面下沿 850mm，底沿应约 710mm）。**两个数字对不上**，
> 需现场确认支架装在柜面什么高度——这直接决定倾角与视角。

### 7.2 额头柜下沿

| 项 | 做法 |
|----|---|
| 位置 | **贴额头柜底下沿，垂直向下延伸**（支架高 136mm） |
| 净空 | 需确认**柜底到仪表台/挡风玻璃的净空 ≥136mm**，否则平板顶到仪表台 |
| 固定 | 支架顶面用 4× M4 螺丝**从下往上**固定在柜底 |
| 走线 | 沿柜内走线到 N100/12V，柜底开 φ8 进线孔 |
| 视角 | 此处**眼位更低**（坐姿），倾角需**重新算**，不能照搬水槽前的 20° |

> ⚠ 额头顶的安装高度与坐姿视角有关，**建议做一个纸样先比划**再打印。

### 7.3 吊顶（顶棚）悬吊

| 项 | 做法 |
|----|---|
| 位置 | 吊顶（顶棚）板下方，平板**向下悬吊**，坐姿仰视 |
| 接口 | **利用已预埋的 1/4" 螺纹**（相机螺孔）——直接拧球头/关节 |
| 角度 | **必须可调**（14-48°，见 §四之二）→ 球头带锁紧，或齿盘关节 |
| 支架壳 | [tablet-mount.scad](tablet-mount.scad)：托盘 `stow="hook"`（含 1/4" 热熔螺母座 + 收纳挂槽）+ 球头底座 `mod="ceiling"` |
| 螺纹座 | ⚠ 若预埋的是**木板直接攻丝**，悬吊 350g + 颠簸会**滑牙拔脱**——**须换金属 T 型螺母/预埋螺母** |
| 走线 | 顶棚内走线到 N100/12V；电源线**从支架上方进**（悬吊时自然下垂） |
| 净空 | 平板底沿离地需 **高于坐姿头顶**（约 125cm + 余量），避免起身撞头 |
| 收放 | 建议**可上翻收纳贴顶**或**可整体拧下**，不用时收起 |

> ⚠ **两个关键风险**：① 球头摩擦锁紧 → 颠簸下垂，必须带锁紧或齿盘；
> ② 1/4 螺母若只是木板攻丝 → 悬吊受力与壁挂不同（拉力+恒定弯矩），**必须金属预埋件**。

### 7.4 吊顶收纳（定稿：**可整体取下 + 挂墙钩**）

**决定**：做成**可整体旋下**，不用时挂到顶棚旁的钩上。

```
工作态                                收纳态
   顶棚 ────────┐                    顶棚 ────┬──────┬────┐
                │ 底座(1/4母)                │底座   │钩  │钩  │
              ╔═╧═╗                        (球头留)  └┬───┘
              ║球头║                                  │
              ╚═╤═╝                              ┌───┴───┐
            ┌───┴───┐                            │ 平板壳 │ ← 挂起贴顶
            │ 平板壳 │                             └───────┘
            └───────┘
            屏幕朝下前（可调 14-48°）
```

**为什么选"旋下 + 挂"而不是"上翻铰链"**：

| 方案 | 角度自由度 | 结构 | 适合 |
|---|---|---|---|
| 上翻铰链 + 卡扣 | 铰链本身不给倾角，**还要再加第二个关节** | 承重铰链 + 抗颠簸卡扣，复杂 | 每天翻来翻去的高频场景 |
| **旋下 + 挂墙钩** ✅ | **保留 1/4 球头全部自由度（14-48°）** | **一个挂槽 + 两个 L 型钩** | **驻车才用、平时收着**（本场景） |

> 关键洞察：**既然已经有球头可调角，"收纳"就不必再做一个铰链**——
> 直接整体取下挂旁边即可。结构更简单，且**不牺牲角度自由度**。

**收纳态几何**：平板上翻贴顶后从顶棚凸出约 **26mm（2.6cm）**（支架厚 16 + 底座/钩 10），
几乎齐平，不影响头部空间。

**两种挂法（推荐 A）**：

| | A. 挂槽 + L 型钩（**推荐**） | B. 磁吸位 |
|---|---|---|
| 做法 | 壳背面上方做燕尾挂槽（脚本 `stow="hook"`），顶棚打 2 个 L 型钩 | 顶棚贴铁片座，壳背面贴磁铁 |
| 优点 | **机械咬合，颠簸不脱** | 一贴就好，最简 |
| 缺点 | 要对准钩子 | 车内颠簸可能移位 |
| 备注 | 脚本 `stow="hook"` 已生成挂槽凸台 + 1/4 螺母座（`tray_hook_slot()` / `quarter_seat()`）；L 型钩买成品不锈钢钩 | — |

> ⚠ **挂槽位置**：中心偏上 **38mm**（避开 1/4 螺母座，实测不干涉）。
> **注意**：磁吸在**工作态**不可靠（前面论证过），但**收纳态是静态贴顶，磁吸反而合适**
> ——两种状态的可靠性要求不同。

**额外好处**：平板壳能单独取下，**契合"夏天带走"的想法**（整台拧下即可）。

## 八、STL 文件（已生成，可直接打印）

目录 [`stl/`](stl/)，已用 OpenSCAD 渲染验证（均为 manifold / NoError）。

| 文件 | 尺寸 (X×Y×Z) | 面数 | 用途 |
|---|---|---|---|
| `tray-tablet-8in.stl` | 208.2 × 136.3 × 15.9 | 8564 | **托盘**（壁挂款：无挂槽、无 1/4 座）——① ② 两处用 |
| `tray-tablet-8in-hook.stl` | 208.2 × 136.3 × 25.9 | 9336 | **托盘**（吊顶款：含收纳挂槽 + 1/4" 热熔螺母座） |
| `base-wedge-22deg.stl` | 208.2 × 55.1 × 132.3 | 3140 | **楔形底座 22°**（水槽前推荐；顶部截平 4mm） |
| `base-wedge-20deg.stl` | 208.2 × 49.6 × 132.3 | 2520 | 楔形底座 20°（角度偏保守可选） |
| `base-ball-quarter.stl` | 70 × 70 × 15 | 1376 | **球头底座**（吊顶用，含 1/4" 热熔嵌件座） |
| `dummy-tablet-hollow.stl` | 200.2 × 120.3 × 7.9 | 1204 | **平板假体（空心，推荐）**——试装用，省料 43% |
| `dummy-tablet-solid.stl` | 200.2 × 120.3 × 7.9 | 536 | 平板假体（实心）——想模拟真机重量时用 |
| `dummy-gauge-thickness.stl` | 128 × 30 × 8.9 | 96 | **厚度卡规**：7.9 / 8.4 / 8.9 三档，插托盘试松紧 |

**楔形底座结构**：等距掏空（5mm 均匀壁厚）+ 3 道竖向筋 + 顶部截平 4mm（去刀口）；
所有孔都沿**斜面法向**钻（托盘导孔 φ2.6×8，墙面沉头孔钻穿贴墙面）。

**装配**：
- 托盘 ↔ 底座：托盘背面 4×M3 沉头孔（φ3.2，沉头与内腔面齐平）↔ 底座斜面 φ2.6 导孔，
  **4×M3×10 沉头自攻螺丝**（从托盘内腔侧拧入，装平板前上紧）
- 底座上墙：4×M4 沉头木螺丝，**上排 M4×25 / 下排 M4×50**（楔形上薄下厚：11.6mm / 35.2mm 穿透厚），
  沉头埋入斜面，与托盘背面齐平不干涉

> ### 🖨 建议打印顺序（省时省料）
>
> **先打假体试装，再打真件**——避免打完发现尺寸不对：
>
> 1. **`dummy-gauge-thickness.stl`**（5KB，几分钟）→ 插进托盘试松紧，确认取放不卡不晃
> 2. **`dummy-tablet-hollow.stl`**（59KB，约 1 小时）→ 装进托盘 + 比划安装位置/角度/视角
> 3. 角度位置都满意了 → **再打托盘和底座**
>
> 假体也用于**试收纳挂槽**好不好挂。
> 尺寸与真机完全一致（200.2×120.3×7.9，已校验）。
**打印方向**：托盘与底座都是**背面朝下平放**（层纹⊥受力，免支撑）。

**重新生成/改参数**：改 [tablet-mount.scad](tablet-mount.scad) /
[tablet-dummy.scad](tablet-dummy.scad) 顶部 PARAMS，然后

```bash
# 托盘：壁挂款（stow="none"）与吊顶款（stow="hook"）
openscad -o stl/tray-tablet-8in.stl       -D 'PART="tray"' -D 'stow="none"' tablet-mount.scad
openscad -o stl/tray-tablet-8in-hook.stl  -D 'PART="tray"' -D 'stow="hook"' tablet-mount.scad
openscad -o stl/base-wedge-22deg.stl      -D 'PART="base"' -D 'mod="wall"' -D 'tilt=22' tablet-mount.scad
openscad -o stl/base-wedge-20deg.stl      -D 'PART="base"' -D 'mod="wall"' -D 'tilt=20' tablet-mount.scad
openscad -o stl/base-ball-quarter.stl     -D 'PART="base"' -D 'mod="ceiling"' tablet-mount.scad

# 平板假体（试装用）
openscad -o stl/dummy.stl -D 'PART="tablet"' -D 'hollow=true' tablet-dummy.scad
openscad -o stl/gauge.stl -D 'PART="gauge"' tablet-dummy.scad

# 装配预览（两者拼一起看，不打印）：PART="both"
```

> 想要其他倾角：改 `-D 'tilt=25'` 即可，底座进深会自动 = 136.3×tan(θ)。

## 八之二、STEP 文件（**Shapr3D 可编辑**）

目录 [`step/`](step/)。**STL 是三角网格，Shapr3D 里改不动尺寸**（只能整体缩放，
会同时改变内腔和壁厚）；STEP 是 BREP 实体，每个面/边都可编辑。

| 文件 | 尺寸 X×Y×Z (mm) | 用途 | 配哪个底座 |
|---|---|---|---|
| `dummy-tablet-solid.step` | 200.2 × 120.3 × 7.9 | 平板假体（实心） | —（试装用） |
| `dummy-tablet-hollow.step` | 200.2 × 120.3 × 7.9 | 平板假体（空心，省料） | —（试装用） |
| `tray-tablet-8in.step` | 208.2 × 136.3 × 15.9 | **托盘（壁挂款：无挂槽）** | 楔形底座 |
| `tray-tablet-8in-hook.step` | 208.2 × 136.3 × 25.9 | **托盘（吊顶款：挂槽 + 1/4" 座）** | 球头底座（吊顶） |
| `base-wedge-22deg.step` | 208.2 × 55.1 × 132.3 | 楔形底座 22°（顶部截平 4mm） | 托盘 |
| `base-wedge-20deg.step` | 208.2 × 49.6 × 132.3 | 楔形底座 20° | 托盘 |
| `base-ball-quarter.step` | 70 × 70 × 15 | 球头底座（含 1/4" 座） | 带挂槽托盘 |

### 怎么组装（三种用法）

| 用在哪 | 打哪几个件 | 怎么连 |
|---|---|---|
| **① 水槽前**（壁挂，22°） | `tray-tablet-8in` + `base-wedge-22deg` | 底座 4×M4 沉头木螺丝上柜板（上排 M4×25/下排 M4×50）；托盘背面 4×M3×10 沉头自攻 ↔ 斜面导孔 |
| **② 额头柜下**（壁挂，角度待定） | `tray-tablet-8in` + `base-wedge-20deg`（或另算角度） | 同上，底座贴额头柜底 |
| **③ 吊顶**（悬吊，可调角） | `tray-tablet-8in-hook` + `base-ball-quarter` | 底座拧顶棚（**1/4" 金属 T 型螺母**）；1/4" 热熔嵌件压入托盘背面座体与球头底座座体；球头调角；收纳时旋下托盘、挂到顶棚旁 L 型钩 |
| 试装（打印前） | `dummy-tablet-*` | 塞进托盘试松紧 + 比划角度 |

> **托盘的 4 个孔**：M3 沉头从**内腔侧**钻，沉头与背板内面齐平——平板放进去后看不到孔、也不硌屏幕。
> **楔形底座的斜面**就是托盘的贴合面；**贴墙面是平面**（Y=0），所以能平贴柜板。

**坐标约定**（便于在 Shapr3D 里对齐）：
- **X = 宽，Y = 进深，Z = 高**（楔形底座：贴墙面是 X-Z 平面 Y=0，斜面朝 +Y）
- 托盘：Z=0 是背板外表面，开口朝 +Z

**R 角**（已建进模型，可直接改）：

| 部位 | R | 说明 |
|---|---|---|
| 平板假体四角 | **8** | 真机估值（实际 R6-R10） |
| **托盘内腔四角** | **3** | ⚠ **上限 ≈4**：真机 R8 + 1mm 间隙 → 内腔 R >4 会与平板四角干涉装不进（旧版 R10 实测干涉约 6mm，已修正） |
| 托盘外角 | 10 | |
| 托边根部 | 2 | 减应力集中 |
| 球头底座外角 | 4 | |

**重新生成**：

```bash
python3 gen_step.py     # 需 CadQuery；输出到 ./step/
```

> CadQuery 已装在 `/tmp/cqvenv`（Python 3.12）。若环境重建：
> `python3.12 -m venv /tmp/cqvenv && /tmp/cqvenv/bin/pip install cadquery`

## 九、打印参数

| 项 | 值 |
|----|-----|
| 材料 | **PETG**（耐温优先）；ASA 更好但难打 |
| 层高 | 0.2mm |
| 壳/壁厚 | 3mm（8 圈 @0.4 喷嘴） |
| 填充 | **30-40%**（承力件） |
| 加强筋 | 2-3 道，厚 2.5mm |
| 打印方向 | **贴墙面/贴顶面朝下**（层纹⊥受力，强度最高） |
| 支撑 | 斜面朝上打印可免支撑 |
| 螺母座 | 吊顶款加 1/4" 座时：座体 **≥9mm 厚** + 热熔铜螺母，**不要靠打印螺纹** |

## 十、待实测确认

- [ ] **水槽前支架的实际安装高度**（§7.1 的矛盾数据）
- [ ] 该处视角实测（站着操作时，倾角是否合适）
- [ ] 柜体正面板厚度（决定螺丝长度 / 是否需背衬）
- [ ] **额头柜底下沿净空 ≥136mm ？**
- [ ] 额头处**坐姿**视角（倾角可能不同）
- [ ] **吊顶 1/4 螺纹的预埋形式**（木板攻丝 → 必须换金属 T 型螺母）
- [ ] **吊顶处坐姿实测**：人常坐的位置距屏幕下方多远（决定倾角范围）
- [ ] 吊顶平板底沿离地高度（坐姿起身是否撞头）
- [ ] **收纳位选哪边**（顶棚旁哪块区域挂，不碰头/不碰其他设备）
- [ ] 平板**是否带保护壳**（改变内腔尺寸——含壳要重算）
- [ ] 夏季车内温度（决定是否强制做直供电）

## 十一、采购清单（草案）

| 名称 | 规格 | 数量 | 备注 |
|---|---|---|---|
| PETG 耗材 | 1.75mm | 1 卷 | **别用纯 PLA** |
| 5V 降压模块 | 12V→5V，3A+ | 1-2 | 水槽柜内 + 额头顶 |
| USB 线 | **直角弯头**（省空间） | 2 | 固定在支架上 |
| **M3×10 沉头自攻螺丝** | 托盘 ↔ 楔形底座 | 4 | 拧入斜面 φ2.6 导孔 |
| M4 沉头木螺丝 | **上排 M4×25 / 下排 M4×50** | 8 | 两处壁挂各 4（楔形上薄下厚，穿透 11.6/35.2mm） |
| **1/4" 热熔铜螺母嵌件** | 外径 8.4mm（孔 φ8.2×8） | 2 | 托盘背面座 + 球头底座座各 1，烙铁压入 |
| 薄泡棉条 | 3mm | 1 | 防异响 |
| **1/4 球头 + 带锁紧云台** | 吊顶用 | 1 | **必须带锁紧**（防颠簸下垂），或齿盘式 |
| **1/4 金属 T 型螺母/预埋螺母** | 吊顶顶棚预埋 | 1 | ⚠ 木板直接攻丝会滑牙拔脱 |
| **L 型挂钩** | 收纳用，买成品不锈钢钩 | 2 | 挂槽在托盘背面（`stow="hook"`） |
| （可选）磁吸收纳座 | 替代挂钩 | 1 | 收纳态静态贴顶，磁吸可用 |

## 十二、与现有方案的关系

| 位置 | 角色 | 倾角 | 状态 |
|---|---|---|---|
| **水槽前壁挂** | **主位**：日常控制 + Dashboard 常驻 | **固定 20-22°** | 本文 |
| **额头柜下沿** | 副位：驾驶区查看/操作 | 固定，待实测 | 本文 |
| **吊顶悬吊** | 副位：坐姿仰视（后床/卡座） | **可调 14-48°**（1/4 球头） | 本文；**收纳=旋下挂墙钩**（§7.4） |
| 副驾驶位（[tablet.md](tablet.md)） | 移动位 / 监控 | 保留，优先级降低 |

> **固定方式因场景而异**：两处都是**常驻固定**（车在跑 + 面板倾斜）→ 机械托边；
> 副驾移动位是**"取下来"**场景 → **磁吸在那里反而合适**。

## 十三、关于现成的 .f3d 模型

**结论：能用，但要走中转格式。**

| 格式 | Shapr3D 能直接打开？ | 说明 |
|---|---|---|
| `.f3d`（Fusion 360 原生） | ❌ **不能** | Autodesk 私有格式，只有 Fusion 360 能原生读写 |
| `.step` / `.stp` | ✅ **能** | **首选中转格式**，带完整实体几何（可编辑） |
| `.iges` / `.igs` | ✅ 能 | 老格式，曲面易碎，次选 |
| `.stl` / `.3mf` | ✅ 能 | 只有网格，**不能参数化编辑**，只能整体缩放/布尔 |
| `.x_t` (Parasolid) | ✅ 能 | 也可 |

### 推荐做法

1. 找原作者要 **`.step` 版本**（很多模型站同时提供 STEP；Shapr3D 官方也建议用 STEP 互通）
2. 若只有 `.f3d`：
   - 装免费版 **Fusion 360 for Personal Use** → 打开 `.f3d` → **导出 STEP** → Shapr3D 导入
   - 或让分享者导出一次
3. 拿到 STEP 后在 Shapr3D 里**直接改尺寸**（STEP 是实体，可编辑）

> ⚠ **不建议用 STL 导入改**：STL 是三角网格，Shapr3D 里改不动尺寸，
> 只能整体缩放——而缩放会同时改变**平板内腔**和**壁厚/托边**，尺寸就全错了。

### 与本文方案的关系

**本仓库已按你平板的实测尺寸（200.2×120.3×7.9）生成两种格式**：
[`step/`](step/) 里的 STEP（**Shapr3D 可编辑**）、[`stl/`](stl/) 里的 STL（直接打印）。 那个 f3d 模型适合当**参考/灵感**（比如看别人的卡扣怎么做的），
但要改尺寸还是自己的参数化脚本更快——改 `tab_w`/`tab_h`/`tilt` 一行就出新的。

下方示意图：Shapr3D 官方明确支持与 Fusion 360 通过 **STEP** 互通
（见 [Working with Fusion 360 and Shapr3D](https://support.shapr3d.com/hc/en-us/articles/15441903753116-Working-with-Fusion-360-and-Shapr3D)、
[Supported file types](https://support.shapr3d.com/hc/en-us/articles/7874523890076-Supported-file-types)）。
