shakeyo/MY-VAN/modules/10-smart-control/sensors/ble-sensors.md

# BLE 温湿度传感器接入（纽扣电池类）

> **结论**：温湿度这类"看个数、画曲线、联动风扇"的环境传感器，**不挤 485 总线**，
> 走 **BLE + ESP32 蓝牙代理**。安全关键的温度（低温禁充）用 MPPT 自带的
> `SolarBatTemp`（走 485、硬线供电），**两者职责分离**。

## 一、为什么不走 485

市面便宜的纽扣电池温湿度计（小米/青萍等）**只有 BLE 广播，没有 485 口**。
硬要接 485 就得换工业 Modbus 温湿度——代价是**要走线、要 12V 供电、体积大、不好看**，
正好抵消了选纽扣电池的初衷。

而 485 总线的价值在**安全关键 + 执行器**（继电器、MPPT），**没必要为了"统一"把传感器都塞进去**。
本模块架构本来就分了多条接入路径（485 / DI 干接点 / MQTT），**BLE 是第 4 条**，完全自洽
（[n100-ha/design.md](../n100-ha/design.md) 已把 HA 职责写明"多源汇聚（BLE 传感器、Frigate、车机）"）。

## 二、架构

```
纽扣电池温湿度计 ──BLE 广播──→ ESP32（蓝牙代理，常电）──WiFi──→ HA（N100）
```

- **ESP32 网关加 `bluetooth_proxy`**：ESP32 已在车上且常电，把 BLE 广播转给 HA
- 好处：**不依赖 N100 常开就能收数据**（ESP32 是常电的）；覆盖跟着 ESP32 走
- HA 侧用 **Xiaomi BLE** 或 **Passive BLE monitor** 集成解析广播

> **实测结论（2026-09）**：BLE 协议栈本身约需 **1.2MB Flash**。
> 主网关加 BLE 后 Flash 从 53% → **75%**（偏紧）；**独立一台 ESP32 专跑代理**（Flash 68%）
> 可让主网关保持 53% 的干净状态。**推荐独立方案，理由是故障隔离**——
> BLE 崩了不牵连承担安全关键自动化的主网关。完整对比见 §七。

## 三、哪些传感器走哪条路（定稿）

| 传感器 | 走哪条 | 理由 |
|---|---|---|
| 车内/储物仓温湿度 ×2 | **BLE + ESP32 代理** | 现成好看便宜，不占 DI、不占 485 |
| **低温禁充的温度** | **MPPT `SolarBatTemp`（已有）** | **安全关键，走 485，硬线供电** |
| 水位 ×2 | 485 或 DI | 要可靠，且装在水箱旁本来就该有线 |
| 门磁 ×2 / 漏水 ×2 | **DI 干接点** | 本来就是干接点，零成本（中4 还有 DI3-4 空着） |

> ⚠ **安全关键自动化绝不放 BLE**：纽扣电池没电是**静默失效**，不像 485 断线会立刻报错。
> 低温禁充、待机断电这类逻辑一律走 485 硬线设备。

## 四、ESP32 侧配置

```yaml
# 加到 prod.yaml（或单独 ble.yaml 作 package）
esp32_ble_tracker:
  scan_parameters:
    interval: 1100ms      # 与 window 配合控制占空比，降低功耗/CPU
    window: 1100ms
    active: false         # 被动扫描即可，省电

bluetooth_proxy:
  active: true            # 允许 HA 主动连接（active）与被动收广播
```

> `active: true` 时 HA 可以主动连 BLE 设备；只收广播的话被动模式更省。
> 若资源紧张，先只开 `bluetooth_proxy: active: false` 试。

## 五、HA 侧配置

1. 装集成：**Xiaomi BLE**（小米系）或 **Passive BLE monitor**（通用、支持品牌多）
2. 传感器上电 → HA 自动发现 → 添加实体（温度/湿度/电量）
3. **重命名实体**，加区域（车内/储物仓），便于 Dashboard 与自动化引用

## 六、失联检测（⚠ 必须做，否则是静默失效）

纽扣电池耗尽后，**实体停留最后一个数值不动，看起来一切正常**。
必须自己检测：

```yaml
# HA 自动化：任一 BLE 温湿度超过 N 小时无更新 → 告警
automation:
  - alias: "BLE 温湿度失联告警"
    trigger:
      - platform: template
        value_template: >-
          {{ (now() - states.sensor.car_temp.last_changed).total_seconds() > 6 * 3600 }}
        for: "00:10:00"
    action:
      - service: notify.mobile_app_phone
        data:
          title: "温湿度传感器失联"
          message: "车内温湿度已 6 小时无更新，可能电池耗尽"
```

> 阈值按传感器上报间隔定：多数 BLE 温湿度 5-10 分钟一报，
> 取"正常间隔 × 20 倍"左右（如 6 小时）较稳妥，避免误报。

## 七、待实测确认

### 7.1 已实测：三种方案的资源占用（2026-09）

| 方案 | RAM | Flash | 说明 |
|---|-----|---|---|
| A. 主网关，**不加** BLE | 33.1%（113KB） | 53.3%（978KB） | 现状 |
| B. 主网关，**加** BLE 代理 | 42.9%（146KB） | **75.0%（1376KB）** | 一体化，但 Flash 偏紧 |
| C. **独立 ESP32 专跑代理** | 39.0%（133KB） | 68.4%（1256KB） | 主网关保持 A 的干净状态 |

**关键发现（与直觉相反）**：**BLE 协议栈本身就要约 1.2MB Flash**（C 方案 1256KB 几乎全是 BLE），
所以"拆两台"并不是为了省主网关的空间——主网关确实干净了（回到 53%），
但**总量上多花了一颗芯片**。

**因此真正的取舍是**：

| 选 | 好处 | 代价 |
|----|---|---|
| **B. 一体化** | 省一颗芯片、省一路供电、少一个 WiFi 节点 | 主网关 Flash 75%（OTA 余量紧）；BLE 故障牵连主网关重启 |
| **C. 独立**（推荐） | **故障隔离**——BLE 崩了不影响全车控制；主网关 Flash 保持 53% 有扩展余量 | 多一颗几十元的 ESP32 + 一路 12V |

**推荐 C 的理由**是**故障隔离**，不是省空间：主网关承担安全关键自动化
（按键联动/离车模式），不该因为一个环境传感器的蓝牙栈出问题而被牵连。
这与项目"安全关键放边缘、非关键放中枢"的分层原则一致。

### 7.2 拆机方案（推荐）

| 项 | 做法 |
|----|---|
| 硬件 | 任意 ESP32（几十元，S3/C3 均可），12V→5V 供电（车内常电） |
| 固件 | 只含 `esp32_ble_tracker` + `bluetooth_proxy`，无 485、无 MPPT |
| 位置 | 车体**居中**位置（BLE 金属衰减大），可试点后再定 |
| 接入 | WiFi 连车内路由，HA 自动发现 |
| 好处 | 主网关保持干净；BLE 崩了不影响全车控制（安全边界清晰） |

### 7.3 其余待实测

| 项 | 为什么 | 怎么做 |
|----|---|---|
| BLE 在金属车体内的覆盖 | 房车金属壳衰减比室内严重 | 装好后在储物仓/车尾实测 RSSI，不足则加第二个代理 |
| 传感器电池寿命 | 广播频率与寿命强相关 | 选可调广播间隔的型号；记录换电池日期 |
| 传感器是否加密/需密钥 | 部分小米设备需要 bind key | 选**无需密钥**的型号，或用 Xiaomi BLE 集成取 key |

## 八、采购要点

- 优先选**广播间隔可调**、**无需绑定密钥**的型号
- 显示款 vs 无屏款：无屏更省电、更便宜；有屏方便现场看
- 确认 HA 集成支持该型号（Passive BLE monitor 支持列表最广）
