shakeyo/MY-VAN/modules/03-exterior-appearance/README.md

# 外观装饰

车身外观是房车成品的"第一眼"。V80 原厂素车外观偏商用，通过三段式拉花、轮毂黑化和装饰件，让整车呈现统一风格，同时兼顾年审时部分装饰可快速复原。

**核心思路**：低成本、可逆。拉花用户外级车贴，不喷漆（保留原厂漆面），轮毂用可撕喷膜而非烤漆。年审时关键件可移除。

## 子文档

| 文件 | 内容 | 状态 |
|---|---|---|
| [design.md](design.md) | 拉花方案、配色、装饰件选型 | 设计中 |

## 子系统

| 子系统 | 说明 | 状态 |
|---|---|---|
| 三段式拉花 | 车身侧面三色拉花贴纸 | 待设计 |
| 轮毂黑化 | 可撕喷膜或替换轮毂罩 | 待设计 |
| 装饰件 | 晴雨挡、轮眉、前脸装饰等 | 待设计 |

## 跨模块依赖

- 拉花配色与 [02-external](../02-external/) 车顶件颜色协调
- 施工顺序在车顶、底盘之后，内饰之前

## 图片

<script setup>
const loaders = Object.values(import.meta.glob('./assets/*.{png,jpg,jpeg,PNG,JPG,JPEG,webp}', { eager: false }))
</script>

<AutoGallery :loaders="loaders" />
