shakeyo/MY-VAN/docs/overview.md

房车改造计划

**🧭 1. 阶段一：规划与准备 (Blueprint Phase)**

- 布局设计
  - 需求定义
    - 旅居模式 (长/短期)
    - 使用人数 (单人/双人/家庭)
    - 功能优先级 (床/厨/卫)
  - 草图绘制 (手绘或软件)
  - 关键尺寸测量 (长/宽/高/轮包)
- 预算规划
  - 设定改装总预算
  - 各模块分配 (水电/板材/家电)
  - 预留应急备用金 (10-15%)
- 车辆基础处理
  - 拆除：清空车厢内饰、非必需座椅
  - 清洁：彻底打扫车厢
  - 防锈：检查并处理所有锈点 ( **!!至关重要!!** )

**🛠️ 2. 阶段二：基础设施建设 (Foundation Phase)**

- 开孔与通风 (!!高风险操作!!)
  - 规划位置：空调、换气扇、窗户、水电口、柴暖口
  - 施工要点：**必须做好防锈与防水密封！**
- 保温与隔音
  - 材料选择：XPS挤塑板 / 橡塑海绵板 / 止震板
  - 施工范围：车顶、墙壁、地板，减少冷热桥效应
- 水电预埋 (血管与神经)
  - 电路系统 (12V)
    - 规划位置：副电瓶、逆变器、保险盒、开关面板
    - 布线施工：务必穿管，按功率选线径 ( **!!安全第一!!** )
  - 水路系统
    - 规划位置：净水箱、灰水箱、水泵
    - 布管施工：使用食品级水管，做好接口密封与冬季防冻

**🛋️ 3. 阶段三：内部结构与家具 (Structure & Furniture Phase)**

- 地板铺设
  - 铺设防水底板
  - 铺设地板革或复合地板
- 墙板与顶板安装
  - 覆盖保温层，形成内部墙面
  - 材料选择：轻质板材 (OSB/生态板/桑拿板)
- 家具制作
  - 核心原则： **模块化、可拆卸、轻量化、固定牢固**
  - 关键项目：床架 (横床/纵床)、沙发卡座、橱柜、吊柜

**🔌 4. 阶段四：设备安装与收尾 (Finishing Phase)**

- 家电安装
  - 安装冰箱、驻车空调、柴油暖风、水泵等
  - 接入预留的水电接口
- 卫浴系统 (如规划)
  - 安装便携式马桶、淋浴系统
  - **重点：卫浴间必须做整体防水处理**
- 软装与测试
  - 安装窗帘、床垫、灯光等
  - **最终测试**：全面检查水电安全，路试检查异响

🎓 **5. 必备技能储备 (Skills Phase)**

- **电工知识 (DC 12V)** ：★★★★★ (最重要)
- **木工技能**：★★★★☆ (工作量最大)
- **密封防水技能**：★★★★☆ (杜绝后患)
- **规划设计能力**：★★★★☆ (决定成败)
- **基础动手能力**：★★★☆☆ (耐心与细心)
