shakeyo/MY-VAN/modules/05-water-system/design-tank-portability.md

# 设计决策：车尾可移动副水箱 + 双加水口 + 自由切换

> 本文是 [design.md](design.md) 的**增补方案**，**不替换**任何已装内容。
>
> **现状前提（已装/已定，一律不动）**：
> ① **车底主箱**（固定，60~100 L）——**已装**；
> ② **车身左侧外置注水口**——主箱的原生加水口，保留不动；
> ③ 泵组（48V 隔膜泵 + 粗滤 + 止回阀）、冷暖母管、热水子系统、各用水点——**全部不动**。
>
> **本文只做两件事（不新增泵、不做箱间补给）**：
> ① **车尾右侧柜下**加一个 **20~25 L 可移动副箱**（能整箱拉出去到水龙头装水），**快拆**接入；
> ② **中门 + 尾门两个加水口**——都能灌，且可切换灌**主箱**还是**副箱**。
>
> **两箱之间不互相输送水。**加水和用水各有一把切换，两把各自独立、互不影响。
>
> **🆕 全局总图见 [diagrams/water-overview-2.svg](diagrams/water-overview-2.svg)**——本文的 W1/W2/A/B 切换 + 双加水口，已画进全车总图（含冷水主干、热水支路、尾门洗澡恒温阀、尾门/中门洗车口）。本文的拓扑只聚焦"加水/取水切换"这一段。
>
> ⚠️ **本期不设"车内备用水桶"**——原 [design.md §车内取水桶](design.md#车内取水桶（备用水源的实现）) 作为历史记录保留，**不实施**。原双水源阀组的 **B 路**改接副箱（见 §5）。

---

## 1. 需求翻译成设计约束

| # | 需求原话 | 隐含约束 |
|---|---|---|
| R1 | 车尾柜下**额外加**一个可移动水箱 | 车底主箱照旧；不能因为加它去改已装好的管 |
| R2 | 水箱**能动能拉** | 水 + 箱 + 轮子全在单人可拉范围内（≤15 kg） |
| R3 | 拉出去**直接加水** | 箱体本身有**给水口**，不靠车上管路灌 |
| R4 | 装在**车尾右侧柜下面** | 柜下是存放位；取放不拆柜、不上工具 |
| R5 | 要**快拆** | 单手 / 免工具 / ≤5 秒，**断开不漏** |
| R6 | **直接装个加水口加到水箱** | 车外软管能一路灌进车内箱，**不经过泵、不依赖电** |
| R7 | 中门也有加水口 | 两处加水口都得能用 |
| R8 | **加水和用水可以自由切换** | **加水**：选灌主箱还是副箱；**用水**：选从主箱抽还是从副箱抽。**两套切换相互独立** |
| R9 | ~~主箱→副箱补给~~ | **明确不做**（已确认）：两箱之间不互相输水 |

> **本方案的全部内容就是 R8 的"两把切换"**：一把在加水侧、一把在吸水侧，中间共用一个泵。

---

## 2. 配件盘点与缺口

> 照片里的件为 4 分（1/4" 管，管外径 6.35 mm）DM / 净水器快接件。
> **沿用全车 DM 4 分体系，不引入第二种管径。**

| 件 | 照片位置 | 本方案用途 | 结论 |
|----|---|---|---|
| **4 分快接球阀**（白底、灰柄） | 左中 | **W1/W2**（加水切换）+ **A/B**（取水切换） | ✅ 直接可用（共 4 个） |
| **4 分快接三通**（T 型） | 正中 | 加水汇流 **J**、取水汇流 **Y** | ✅ 直接可用（共 2 个） |
| **4 分快接公头**（黑塑料，带 O 圈） | 中部靠右 | **快拆 K1**（固定在可移副箱上） | ✅ 直接可用 |
| **4 分穿板直通 + 锁紧螺母**（下端带白管） | 下部 | **快拆 K2 母头**穿板固定在柜板，正是这个形态 | ✅ 直接可用 |
| **黑色螺旋花洒 + 手柄花洒头** | 右上 | 尾门花洒 | ✅ 直接可用 |
| **绿色螺纹端盖** | 左上 | 注水口防尘盖（需核实螺纹） | ⚠️ 待核 |
| 白色快接母头 ×N | 公头旁 | — | ⚠️ 需补件 |

**结论：已有件正好够这套拓扑，只缺三样**（清单见 [bom.md §十](bom.md#十、车尾可移副箱与双加水口（本方案新增）)）：

1. 🔴 **快拆自封（dry-break / 止水）连接器**——普通 4 分快接**拔开不止水**；副箱要能拔走，必须自封型。
2. 🔴 **RV 自动回吸切断阀的加水口 ×2**（中门、尾门各一）。
3. 🔴 **可移动副箱本体**（带轮、给水口、溢流、通气）。

---

## 3. 两个箱体的职责

| 容器 | 位置 | 职责 | 本期动作 |
|---|---|---|---|
| **车底主箱** | 车底（已装） | 主水源。可单独供全车，也可被灌 | **不动**。只多接：① 加水口可灌它；② 吸水 B 路可抽它 |
| **车尾副箱** | 车尾右侧柜下（新增） | 第二水源 / 移动箱。可单独供全车，也能拉出去装水 | **新增** |

> **两箱平权**：谁在供、谁在被灌，全靠两把阀决定。**它们之间没有连接管**——不做补给、不做均衡、不做串联。
>
> **代价要认**：车底主箱的水用不出去到副箱，副箱的水也不会自己流进主箱。需要换箱时**手动切 A/B 阀**即可，这正是 R8 要的自由切换。

---

## 4. 系统拓扑（两把切换，共用一个泵）

```
═══ 加水侧：两个口都能灌，W1/W2 选灌哪个箱 ═════════════════════════

 [中门加水口 RV+回吸阀] ─┐
                          ├─ [三通 J] ─┬─[W1 加主箱]─→ 车底主箱
 [尾门加水口 RV+回吸阀] ─┘             └─[W2 加副箱]─→ 副箱给水口

   ★ W1/W2 择一开，就是"加水自由切换"
   ★ 两个口都带回吸切断阀：不插软管自动封闭，满水行车不倒挂、不互溢

═══ 用水侧：泵前汇流，A/B 选抽哪个箱 ═════════════════════════════

 车底主箱 ─[A 取主箱]─┐
                       ├─ [三通 Y] ─→ 粗滤 ─→ 48V泵 ─→ 止回阀 ─→ 冷/热母管 → 各用水点
 车尾副箱 ─[快拆K1/K2]─[B 取副箱]─┘

   ★ A/B 择一开，就是"用水自由切换"
   ★ 两路在泵前汇流，泵之后的管路、用水点、热水全部共用（design.md 原逻辑不变）

═══ 两套切换互不相干 ═══════════════════════════════════════════

   W1/W2 只管"水从哪里进来"；A/B 只管"水从哪里被抽走"。
   灌主箱的同时抽副箱，完全合法。
```

**一句话**：**加水两阀选箱，取水两阀选箱，中间一台泵。**

> **与 design.md 的关系**：design.md 原设「球阀 A = 车底箱 / 球阀 B = 车内水桶」，**拓扑完全一样**，只是把"车内水桶"换成"车尾副箱"。**泵组与下游一个字都不用改。**

### 阀门与编号

| 编号 | 件 | 位置 | 作用 |
|---|----|---|---|
| **W1** | 4 分球阀 | 加水侧 | **灌主箱**：开它、关 W2 |
| **W2** | 4 分球阀 | 加水侧 | **灌副箱**：开它、关 W1 |
| **J** | 4 分三通 | 加水侧 | 两注水口汇流 |
| **A** | 4 分球阀 | 泵前 | **抽主箱**：开它、关 B（design.md 原有） |
| **B** | 4 分球阀 | 泵前 | **抽副箱**：开它、关 A（design.md 原有 B 路） |
| **Y** | 4 分三通 | 泵前 | 两路汇流（design.md 原有三通①） |
| **K1/K2** | 快拆自封 公/母头 | 柜下 | 副箱快拆 |
| **底阀** | 3/4" 螺纹底阀 0.8~1.2 bar | 副箱底部内壁 | 常闭，拔 K1 时把水锁在箱里 |

**新增件只有 W1、W2、J 三个**；A、B、Y 都是 design.md 已经定好的。**这意味着本方案对泵组零改动。**

---

## 5. 副箱怎么接进吸水侧（接管要点）

```
副箱 ─ 底阀(常闭) ─ 箱内粗滤 ─ 柔性管 → [K1 快拆自封公头]
                                          │ ⇕ 一按一拔
 [K2 快拆自封母头·穿板固定在柜板] ◄────────┘
        │
 [B 阀] ─→ 三通 Y ─→ 粗滤 ─→ 泵
```

| 要点 | 做法 | 为什么 |
|---|---|---|
| **B 路原用途** | design.md 的 B 路本接"车内水桶"，**改接副箱快拆母头 K2** | 拓扑不变，只换末端 |
| **吸水口径** | 与主箱同一路 → 同一个粗滤 → 同一个泵 | 不必为副箱加第二套 |
| **倒灌** | **不需要额外单向阀** | 泵前是负压侧，A/B 两路都是"被吸"而非"被压"；止回阀仍在泵出口（design.md 原样） |
| **副箱被吸扁** | 给水盖开 **φ3~5 通气孔 + 防尘滤芯** | 密封箱被泵抽会变形 |
| **吸不到底** | 箱内楔形垫 + U 形低位管，吸口离底 5~10 mm | 减少残留 |
| **拔箱时的水** | 先关 **B** → 拔 K1 → 关底阀 | 三道保险，断开不漏 |

> **A/B 与 W1/W2 是两组完全独立的阀，别混**：A/B 在**泵前**（吸），W1/W2 在**加水路**（灌）。**混接 = 水从加水口直接进泵，就是原方案明令禁止的那条红线。**

---

## 6. 快拆：两种实现 + 本期选哪个

| | **甲·碰接式（目标态）** | **乙·软管跨接（本期）** |
|---|---|---|
| 形态 | 副箱底快拆公头**垂直朝下**，柜下底板母头**朝上**，放下即对接 | 副箱快拆公头经 30 cm 波纹软管接柜内母头，手动插拔 |
| 操作 | 免手操作 | 每次弯腰插拔 |
| 漏水风险 | 低（自封 + 底阀） | 中（忘关 B 会湿） |
| 门槛 | ±2 mm 对位要求高 | 无 |
| 结论 | 用可微调浮动板（4 mm 腰孔 + 橡胶垫）验证成功再上 | ✅ **直接施工** |

**本期承诺（不依赖甲成败）**：

1. **免工具**——不拧任何螺纹；
2. **单手可脱**——关 B → 按释放环 → 拔出 → 关底阀，< 5 s；
3. **断开不漏**——拔出后两端均不滴。

### 6.1 车尾右侧柜下的格位改造（不切钣金）

| 步骤 | 做法 | 验收点 |
|---|---|---|
| 1 | 柜下净空实测：高/宽/深，**箱体推进去还留出提手空间** | 箱子进出自如 |
| 2 | 底座：铝型材槽 + 3 mm EPDM，**只固定在柜板上** | 手推不晃 |
| 3 | **限位：只能向外取出**，行车不可滑动 | 猛推三次位移 <5 mm |
| 4 | 箱下留 ≥20 mm 通风 + 浅接水盘 | 漏一点也不积在柜底 |
| 5 | **K2 母头穿板固定在柜板**（用照片里那个穿板件），走管沿柜背 | 锁母拧紧、无死弯 |
| 6 | K2 → B 阀 → 三通 Y（并入原吸水三通） | 与 A 路汇流点一致 |
| 7 | 标签：「A = 抽主箱」「B = 抽副箱」「拔箱前先关 B」+ 拔箱 SOP 卡 | 暗处可辨 |

### 6.2 快拆件选型（干断/自封）

| 指标 | 要求 | 为什么 |
|---|---|---|
| **自封** | 插/拔两端均止回，拔开不滴 | "带阀普通快接"靠手动关阀，不是自封 |
| 口径 | **4 分（管外径 6.35 mm）** | 与全车同体系 |
| 形态 | **bulkhead 穿板型**（两侧锁母） | 才能固定，不吊在管上 |
| 材质 | 食品级 PP / POM | 涉水管路 |

---

## 7. 加水口：为什么必须装「自动回吸切断阀」

普通"进水口 + 单向阀"不够，这是本方案唯一必须花钱买对的部件：

| 不装的后果 | 机理 |
|---|---|
| **满水行车时水从注口倒挂溢出** | 颠簸/急刹的压力脉动把水沿"高箱→低注口"顶出去 |
| **一个箱灌满，水从另一个注口冒出来** | 两个注口经三通 J 汇流，只装一个切断阀时另一口插着软管就互串。**必须两个都装** |
| **外部脏水倒灌** | 营地水管停水时的虹吸回流 |

**决策：中门、尾门两个注口，各装一个自动回吸切断阀（RV 静水注口）。**

- 选 3/4" 或 1-1/4" 螺纹口，后接 3/4" 外牙或 4 分快接；
- 带防尘盖（照片里的绿色端盖用在这里，**须核实螺纹**）；
- **注口必须高于它所服务的箱体最高水面**。

> **与 design.md"只保留一个止回阀"原则的关系**：那条针对**带压母管**（冷热同压、无倒灌驱动）。本方案的**两个回吸切断阀**属于**重力/加水路**——没有泵提供压力，只有水位差，倒灌真实存在。**不冲突，是另一种工况。**
>
> 注意：**"用水自由切换"不需要新增单向阀**——A/B 都在泵的负压侧。

---

## 8. 场景表（打印贴柜内）

| 场景 | 中门注口 | 尾门注口 | W1 灌主箱 | W2 灌副箱 | A 抽主箱 | B 抽副箱 | 泵 |
|---|---|---|---|---|---|---|-----|
| **① 水龙头在车侧 → 灌主箱** | **接** | 关盖 | **开** | 关 | 开 | 关 | 可开 |
| **② 水龙头在车尾 → 灌主箱** | 关盖 | **接** | **开** | 关 | 开 | 关 | 可开 |
| **③ 灌副箱** | 接 | 关盖 | 关 | **开** | 开 | 关 | 可开 |
| **④ 副箱拉出去装水** | — | — | — | — | **关** | **关** | 关 |
| **⑤ 用主箱的水** | 关盖 | 关盖 | 关 | 关 | **开** | **关** | 开 |
| **⑥ 用副箱的水** | 关盖 | 关盖 | 关 | 关 | **关** | **开** | 开 |
| **⑦ 边灌主箱边用副箱** ★ | 接 | 关盖 | **开** | 关 | **关** | **开** | 开 |
| **⑧ 两箱都要灌（换着灌）** | 接 | 关盖 | 开→关 | 关→开 | 保持 | 保持 | 可开 |

> ★ **场景⑦ 是这套设计的价值所在**：一边从营地龙头补主箱，一边用副箱的水，互不干扰——因为**加水侧和吸水侧是两条完全独立的路**。

### 铁律

1. **W1 与 W2 不同时开**——同时开会把主箱和副箱连通，水位互相拉平，且容易溢；
2. **A 与 B 不同时开**——design.md 原规则：两路同开会引入空气、压力紊乱；
3. **拔副箱前先关 B**——自封与底阀是备份，不是替代品；
4. **加满立即关注口**；
5. **注口高于箱体水面**——否则回吸切断阀失效。

> **可以同时开的一组**：W 系列（加水）与 A/B 系列（取水）互不相干，任意组合都合法。**唯一不许的是同一组里两个都开。**

---

## 9. 高差与残留

| 项 | 关注什么 | 对策 |
|----|---|---|
| **副箱吸水高度** | 柜下箱面到泵（中门柜）的高差 | 自吸泵能拉上来；**实际高度按实车量**，写进 §12 |
| **副箱抽不干净** | 箱底残留 3~5 cm ≈ 1~1.5 L | 箱内楔形垫 + U 形低位管；箱底做漏斗倾向吸口 |
| **两箱水位谁高** | **不需要管**——本方案不做连通，两箱水位互不影响 | 各看各的液位 |

**量化验收**：副箱灌 10 L，用副箱供水（场景⑥）抽到空转停机，下箱量残水，**目标 ≤0.5 L**。

---

## 10. 防溢与通气

| 坑 | 现象 | 解法 |
|----|---|---|
| 副箱无溢流口 | 灌满从给水盖边缘溢出，柜底积水 | 箱侧上部开 φ8 溢流口 → φ6 软管 + 防水透气帽，引到接水盘 |
| 密封盖被吸扁 | 泵抽水时箱内负压 | 给水盖开 φ3~5 **通气孔 + 防尘滤芯**；盖子只当加水盖，不作承压密封 |
| 主箱满溢 | 看不见，靠猜 | 主箱原有液位传感器（[10-smart-control](../10-smart-control/sensors/)）或溢流口出水 |

---

## 11. 冬季与保养

- 副箱是最抗冻的部件：入冬整箱提进屋；
- **箱外那段柔性管**要能排空：关底阀 → 从 K2 处脱开倒空；
- **两个注水口内的回吸切断阀**低温先结晶，入冬前开盖检查阀芯回弹；
- 快拆 O 圈每 6 个月涂硅脂、检查压扁/发白——本方案唯一的"活动密封"故障面。

---

## 12. 红线（新增，追加到 build-guide）

1. **加水路并进取水路** — 水从注口直接进泵，泵被迫吸外部水压；出门忘关即虹吸
2. **加水口只装普通单向阀、不装回吸切断阀** — 满水行车 / 两注口互串必溢
3. **两个注口中只装一个切断阀** — 一箱灌满，水从另一个口冒出来
4. **W1 与 W2 同时开** — 主副箱连通，水位互拉、易溢
5. **A 与 B 同时开** — 两路同吸，引空气、压力紊乱
6. **拔副箱前不关 B** — 自封与底阀是备份，不是替代品
7. **副箱限位全靠摩擦力** — 不做"只能向外取出"的限位，行车会滑出
8. **注口低于箱体水面** — 回吸切断阀失效、重力倒灌
9. **把 W 系列（加水）与 A/B 系列（取水）当同一组阀操作** — 两组用途完全不同，混用即接错
10. **中门注口与车外洗车口共用同一管口** — 两个方向互相污染

---

## 13. 待确定（量完再定稿）

- [ ] **车尾右侧柜下净空**（高/宽/深）+ 柜板结构与可固定位置
- [ ] **副箱箱底 ↔ 泵（中门柜）的高差** → 确认自吸能拉上来
- [ ] **快拆自封连接器具体型号**（4 分、bulkhead、干断）——需实物验证"拔开不滴"
- [ ] **RV 自动回吸切断阀螺纹规格**（3/4" / 1-1/4"）→ 决定中门、尾门开孔
- [ ] **副箱顶面给水盖内径**与绿色端盖螺纹是否匹配
- [ ] **中门/尾门注口开孔位置**（须高于所服务箱体水面）
- [ ] 副箱水位检测——**不能走固定接线**（箱子要能走），优先 BLE/电池型（[10-smart-control/sensors/ble-sensors.md](../10-smart-control/sensors/ble-sensors.md)）
