shakeyo/MY-VAN/modules/02-external/design-lighting.md

# 车顶灯光

待设计。

## 规划内容

- 工作灯（倒车/侧向照明）
- 场景灯（营地氛围）
- 示廓灯（法规要求）
- 供电与走线方案
- 控制方式（接入 10-smart-control 或独立开关）
