shakeyo/MY-VAN/modules/02-external/design-spoiler.md

# 扰流板

待设计。

## 规划内容

- 安装位置（平台前缘）
- 材质（铝板 / PC 板）
- 固定方式（铝型材槽口螺栓锁定）
- 降噪效果
