shakeyo/MY-VAN/modules/02-external/design-storage.md

# 车顶储物箱

待设计。

## 规划内容

- 防水密封方案
- 固定方式（铝型材槽口螺栓锁定）
- 容积与尺寸
- 材质（铝板焊接 / 工程塑料）
