shakeyo/MY-VAN/modules/09-shower-module/design.md

# 设计决策：淋浴模块

## 📋 方案概述

本方案规定了房车隐藏式淋浴模块的设计、防水逻辑、安装及年审对策。核心思路为**"模块化、软隔离、多功能"**。

## 🛠️ 核心结构

### 1. 物理组件
- **底部**: 不锈钢接水盆 (定制，带冲压下沉式下水口)。
- **外部**: 模块化木质框架 (基于 2020/3030 铝型材骨架)。
- **顶部**: 淋浴帐篷/浴帘。
- **排骨架**: 盆内放置 2-3cm 厚防腐木/柚木垫板。

### 2. 防水逻辑 (软隔离)
- **核心对策**: 严禁板材与接水盆硬连接打胶。
- **浴帘入盆法**: 淋浴帐篷/浴帘下摆必须自然垂入不锈钢接水盆内部。
- **收益**: 水只会顺着帐篷流进盆内，外围木板及框架不接触水源，彻底杜绝开裂漏水。

### 3. 年审对策 (Annual Inspection)
- **模块化**: 不固定成死卫浴间，采用快拆结构。
- **伪装术**: 年审时摘掉帐篷，盖上盖板，将其解释为"随车储物箱"。不锈钢盆解释为"防泥水托盘"。
- **可拆卸**: 整个模块通过手拧螺丝固定，可单人 2 分钟拆卸下车。

## ⚙️ 安装细节

- **接水盆固定**:
  - 底部预埋拉铆螺母 (Rivets) 或结构胶粘木方。
  - 盆体焊 L 型固定耳，通过内六角螺栓锁在底板。
- **骨架搭建**:
  - 采用 2020/3030 铝型材，兼顾轻量化与承重。
  - 使用手拧螺栓 (胶头螺母) 实现快拆。
- **下水口处理**:
  - 盆底采用冲压下沉工艺。
  - 车底打孔后涂抹防锈漆及聚氨酯密封胶。
  - 下水管设 U 型存水弯，防臭防反味。

## 🚿 户外淋浴与扩展

- **外翻操作台**: 靠近车门的面板采用钢琴合页底部连接，配折叠支撑架。外翻 90 度形成户外操作台。
- **抽拉花洒**: 选用 2.5-3.5 米长淋浴软管，可从侧窗/侧滑门引出实现户外淋浴。
