shakeyo/MY-VAN/docs/design/01_inspirations/参考图片/820_ChxkPWbawx6AIEI9ACea90J7a40391.jpg

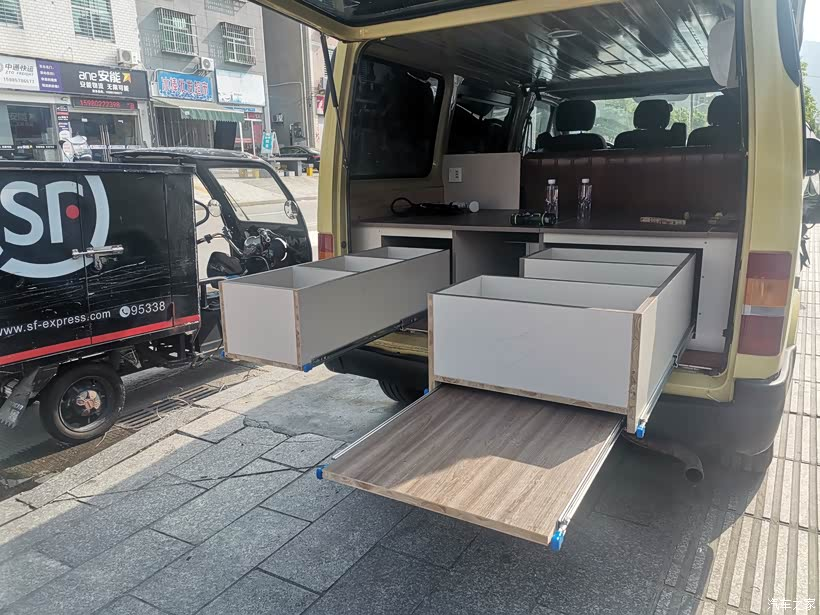
docs/design/01_inspirations/参考图片/820_ChxkPWbawx6AIEI9ACea90J7a40391.jpg
