shakeyo/MY-VAN/docs/design/01_inspirations/参考图片/175506815700785.jpeg

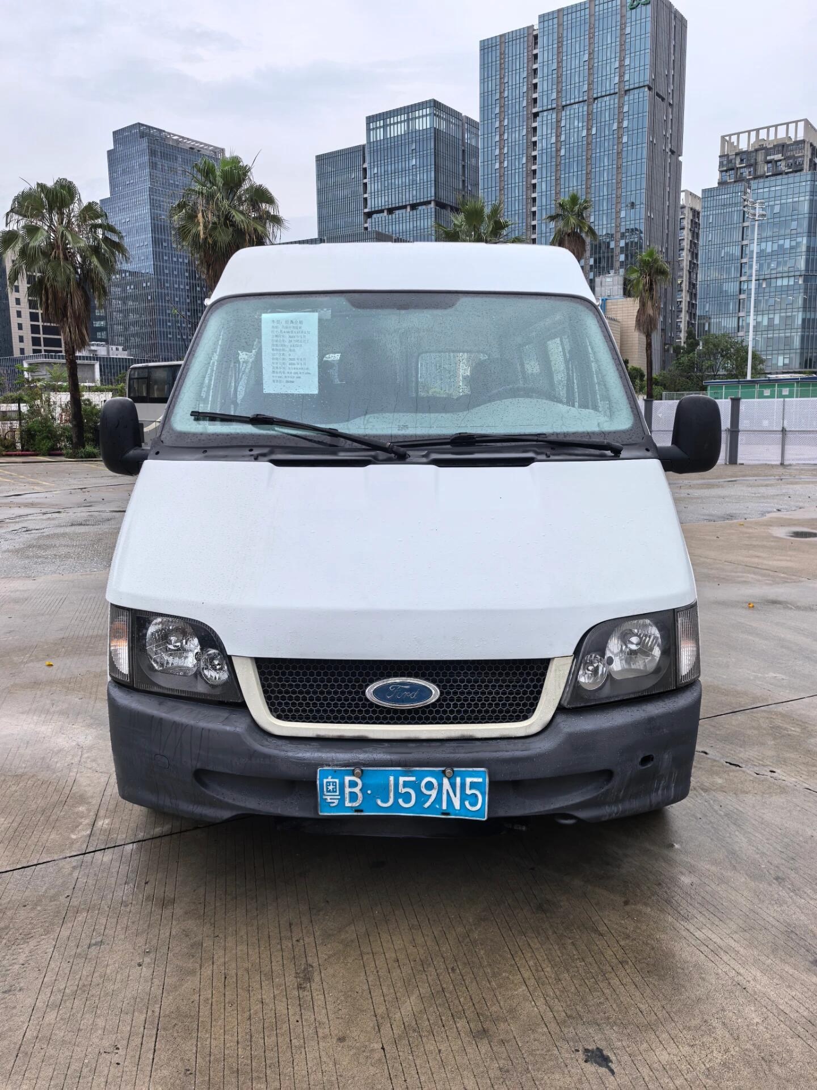
docs/design/01_inspirations/参考图片/175506815700785.jpeg
