shakeyo/MY-VAN/docs/design/01_inspirations/参考图片/IMG_0141.jpeg

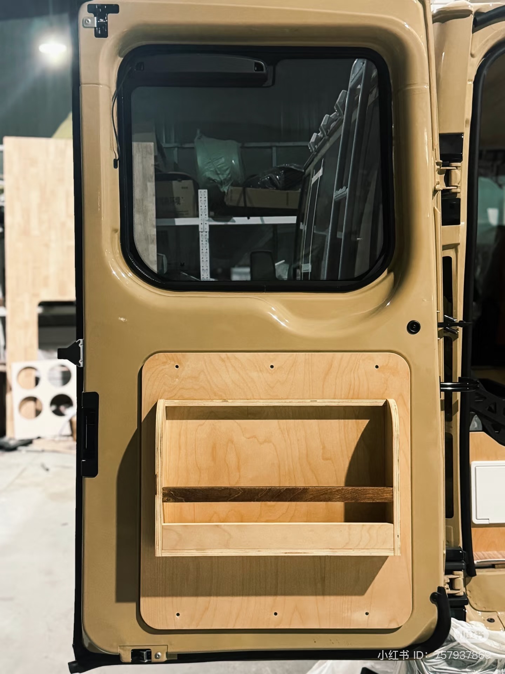
docs/design/01_inspirations/参考图片/IMG_0141.jpeg
