shakeyo/MY-VAN/docs/design/01_inspirations/参考图片/IMG_0166.jpeg

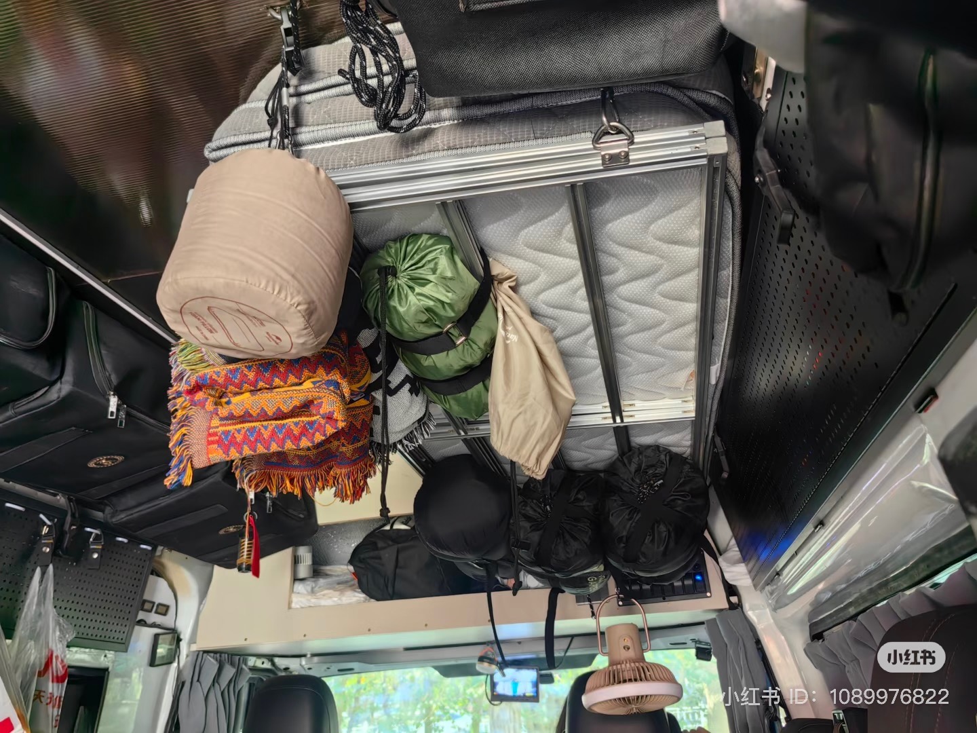
docs/design/01_inspirations/参考图片/IMG_0166.jpeg
