shakeyo/MY-VAN/modules/03-exterior-appearance/assets/exterior/2ba7d2374bb40826d73d4fc44b624c.jpeg

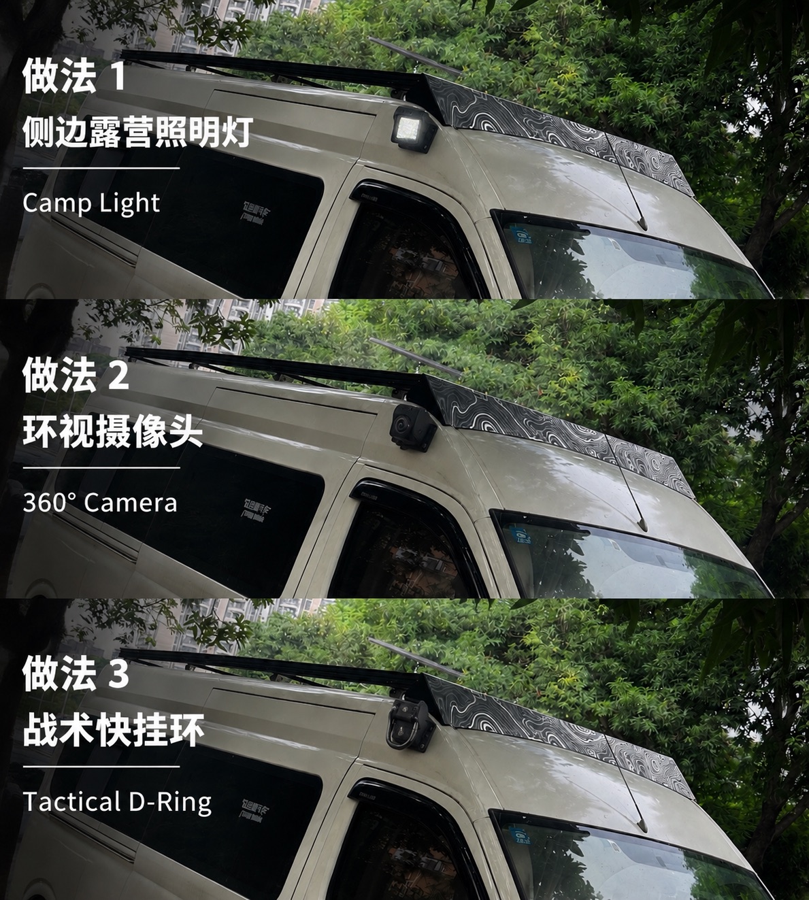
modules/03-exterior-appearance/assets/exterior/2ba7d2374bb40826d73d4fc44b624c.jpeg
