shakeyo/MY-VAN/modules/03-exterior-appearance/assets/exterior/35FD2887-D148-4438-8627-8B3761E656D3.png

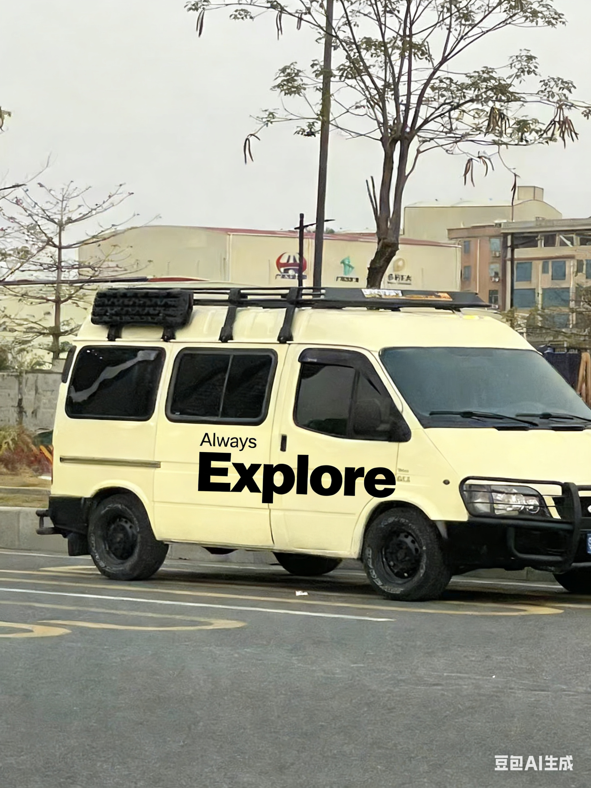
modules/03-exterior-appearance/assets/exterior/35FD2887-D148-4438-8627-8B3761E656D3.png
