shakeyo/MY-VAN/modules/03-exterior-appearance/assets/exterior/48a68dbb77f10e2940346e52593e5a.png

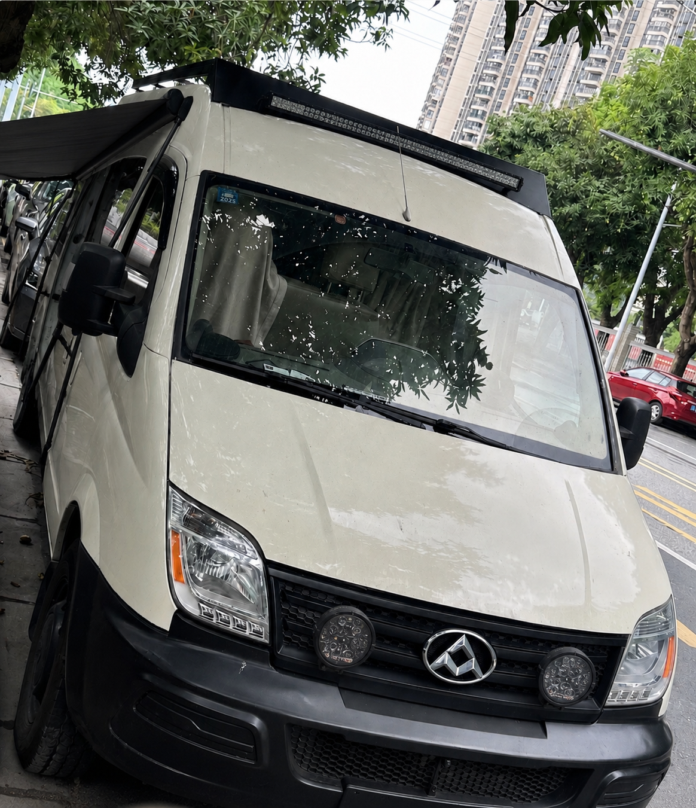
modules/03-exterior-appearance/assets/exterior/48a68dbb77f10e2940346e52593e5a.png
