shakeyo/MY-VAN/modules/03-exterior-appearance/assets/exterior/55c07436318f0edada82a8bbb2ce26.png

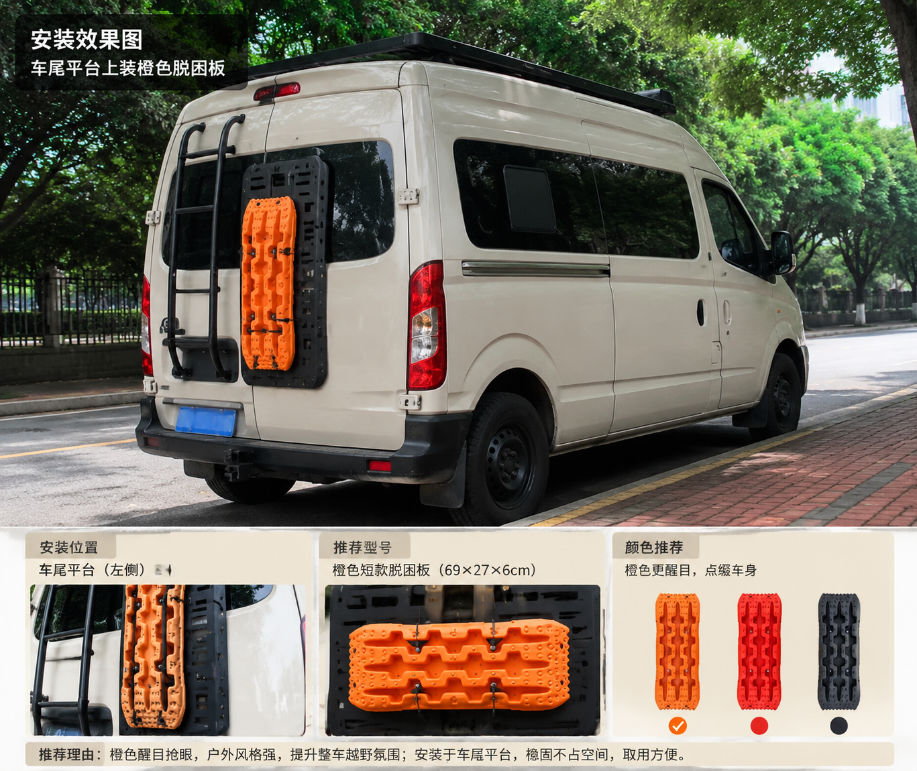
modules/03-exterior-appearance/assets/exterior/55c07436318f0edada82a8bbb2ce26.png
