shakeyo/MY-VAN/modules/03-exterior-appearance/assets/exterior/134e505d1dfa582915305c471552d9.png

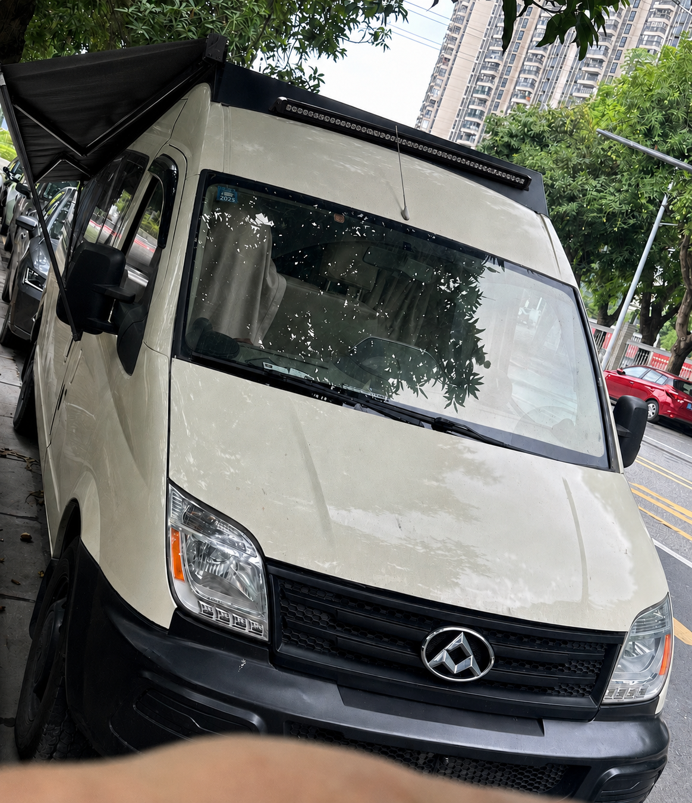
modules/03-exterior-appearance/assets/exterior/134e505d1dfa582915305c471552d9.png
