shakeyo/MY-VAN/modules/03-exterior-appearance/assets/exterior/484E77D5-5640-471F-BEDD-40938C08A848.png

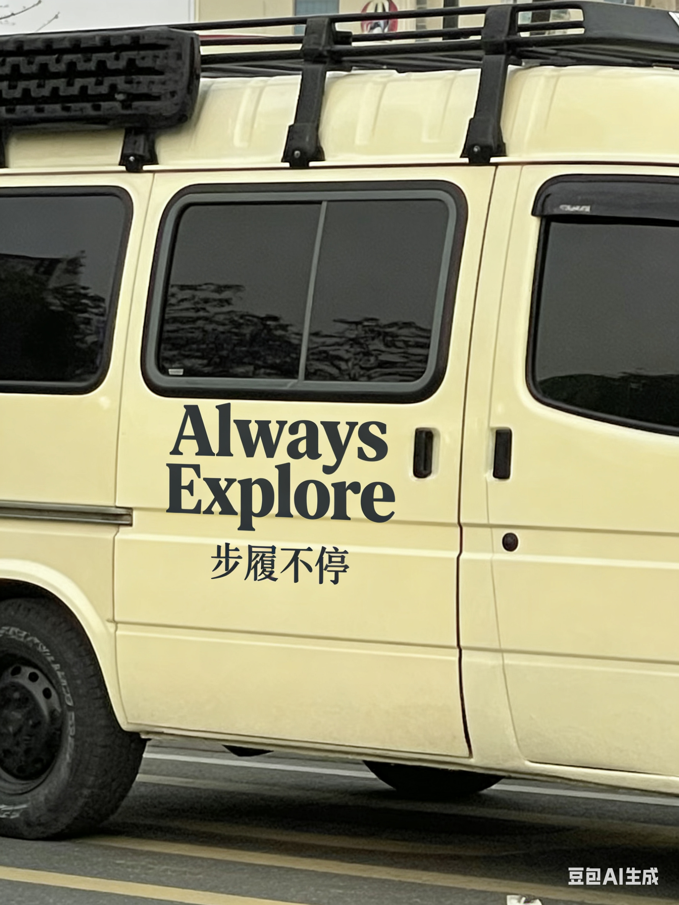
modules/03-exterior-appearance/assets/exterior/484E77D5-5640-471F-BEDD-40938C08A848.png
