shakeyo/MY-VAN/modules/03-exterior-appearance/assets/exterior/ebaf3de88ddad66b7687d559206f1d.png

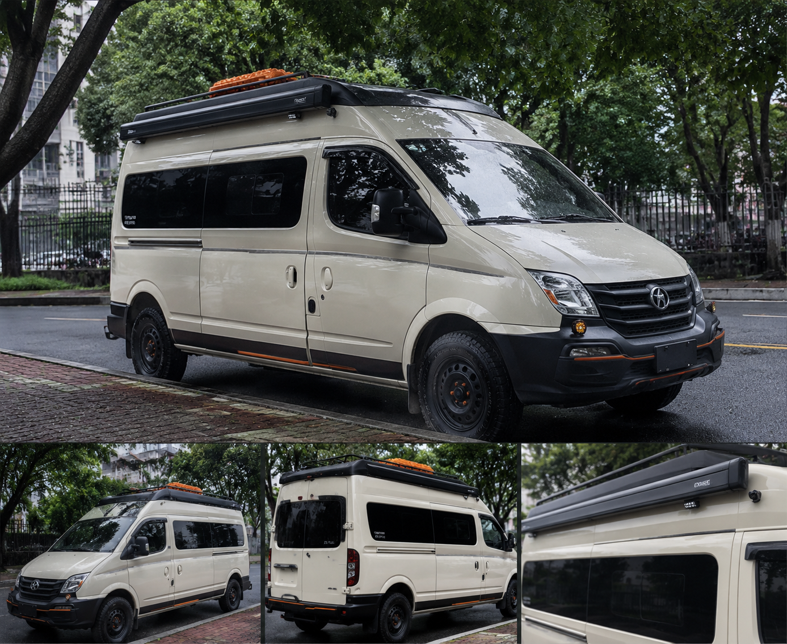
modules/03-exterior-appearance/assets/exterior/ebaf3de88ddad66b7687d559206f1d.png
