shakeyo/MY-VAN/modules/03-exterior-appearance/assets/exterior/ed500fdb25338cbd37c66ebef56639.png

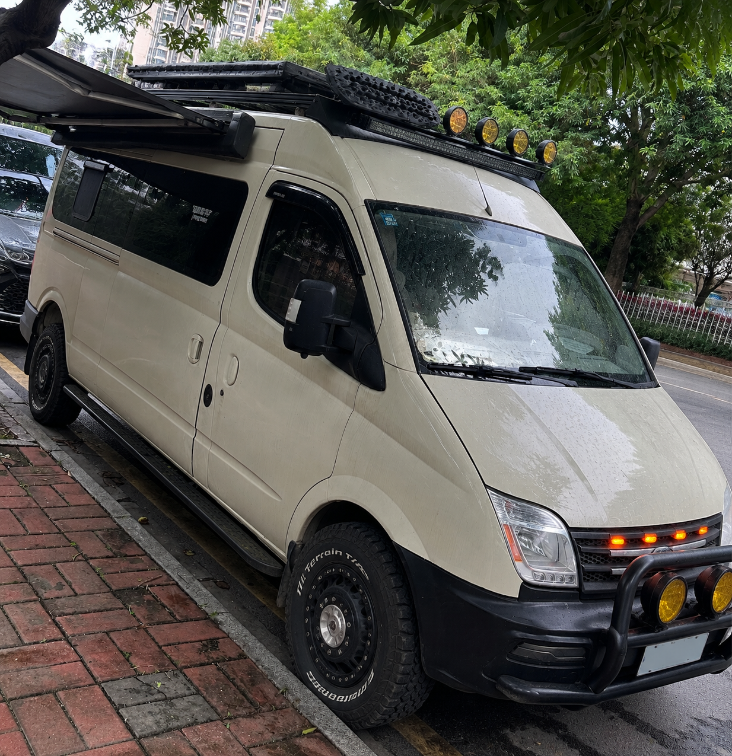
modules/03-exterior-appearance/assets/exterior/ed500fdb25338cbd37c66ebef56639.png
