shakeyo/MY-VAN/modules/03-exterior-appearance/assets/exterior/Xnip2026-07-24_13-35-47.jpg

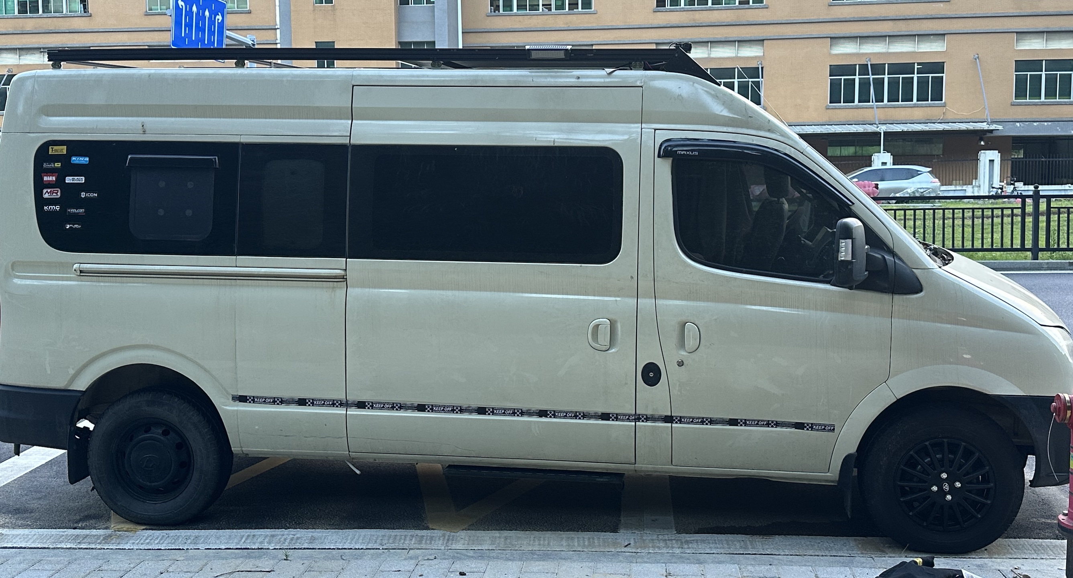
modules/03-exterior-appearance/assets/exterior/Xnip2026-07-24_13-35-47.jpg
