shakeyo/MY-VAN/modules/03-exterior-appearance/assets/exterior/下载 (2).jpeg

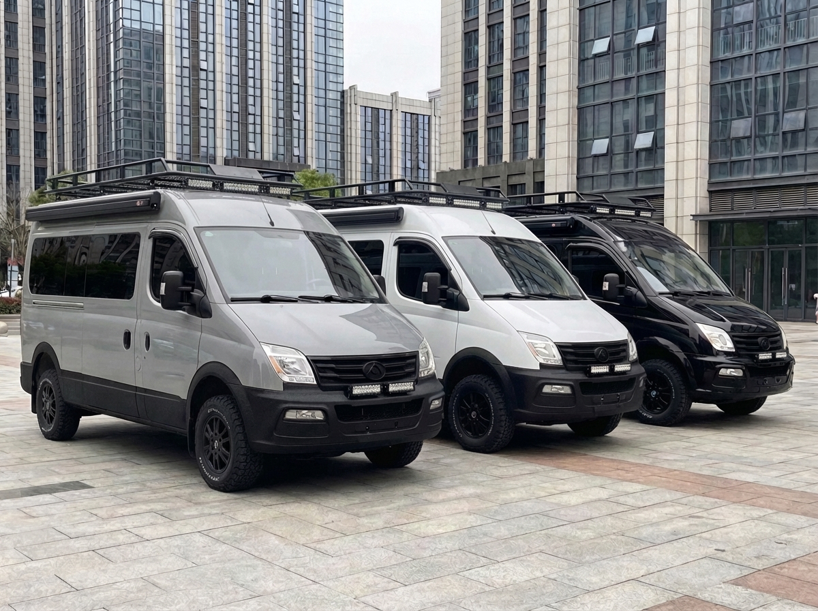
modules/03-exterior-appearance/assets/exterior/下载 (2).jpeg
