shakeyo/MY-VAN/modules/03-exterior-appearance/assets/exterior/下载 (4).jpeg

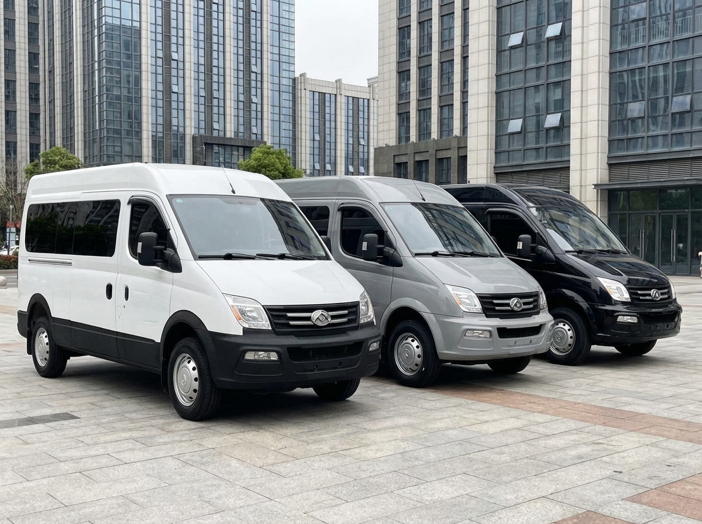
modules/03-exterior-appearance/assets/exterior/下载 (4).jpeg
