shakeyo/MY-VAN/modules/03-exterior-appearance/assets/exterior/图片编辑需求.png

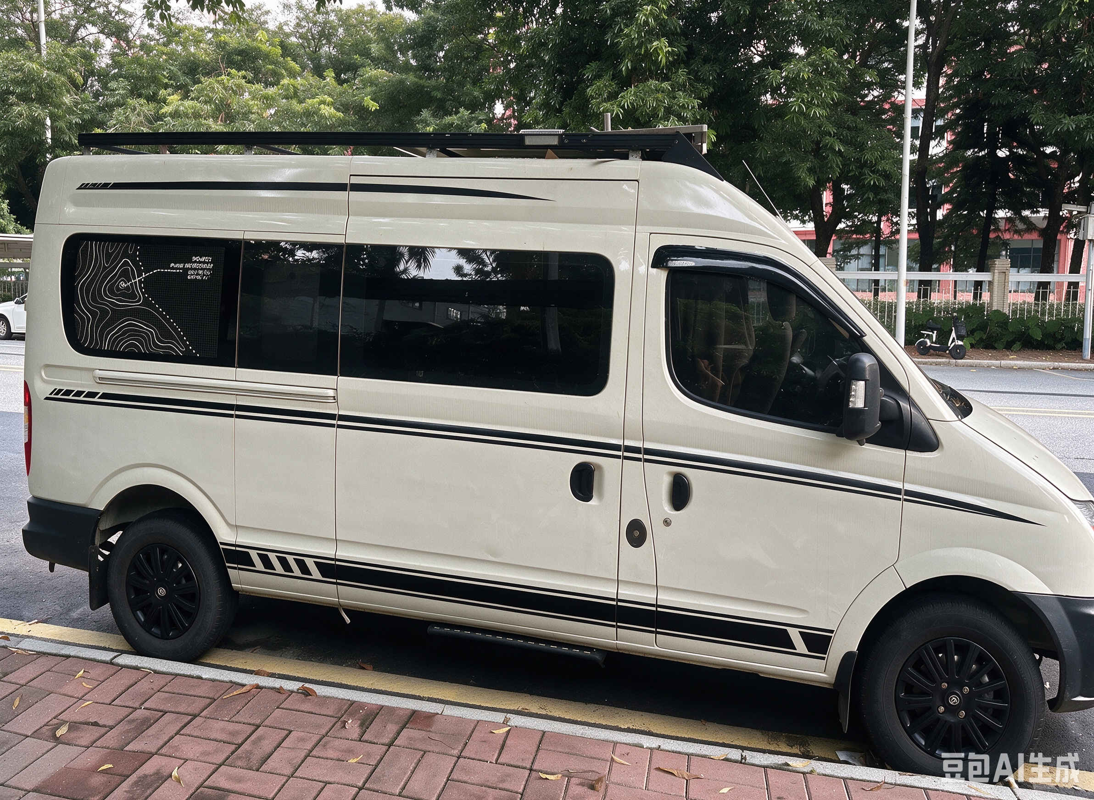
modules/03-exterior-appearance/assets/exterior/图片编辑需求.png
