shakeyo/MY-VAN/modules/03-exterior-appearance/assets/exterior/拉花贴车.png

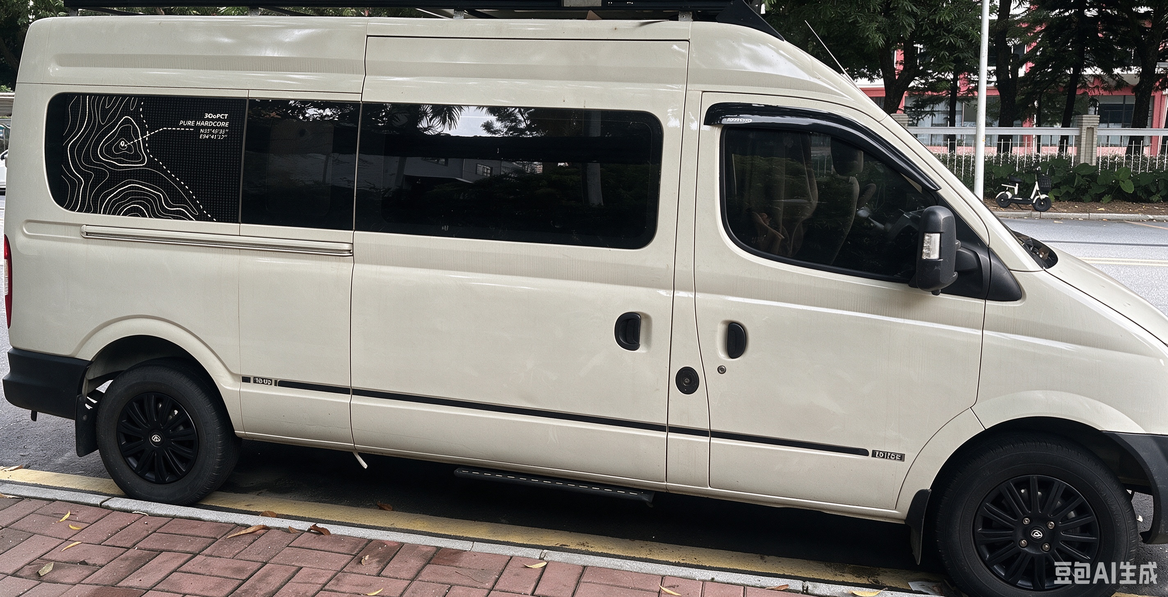
modules/03-exterior-appearance/assets/exterior/拉花贴车.png
