shakeyo/MY-VAN/modules/03-exterior-appearance/assets/exterior/更换后窗贴纸.jpeg

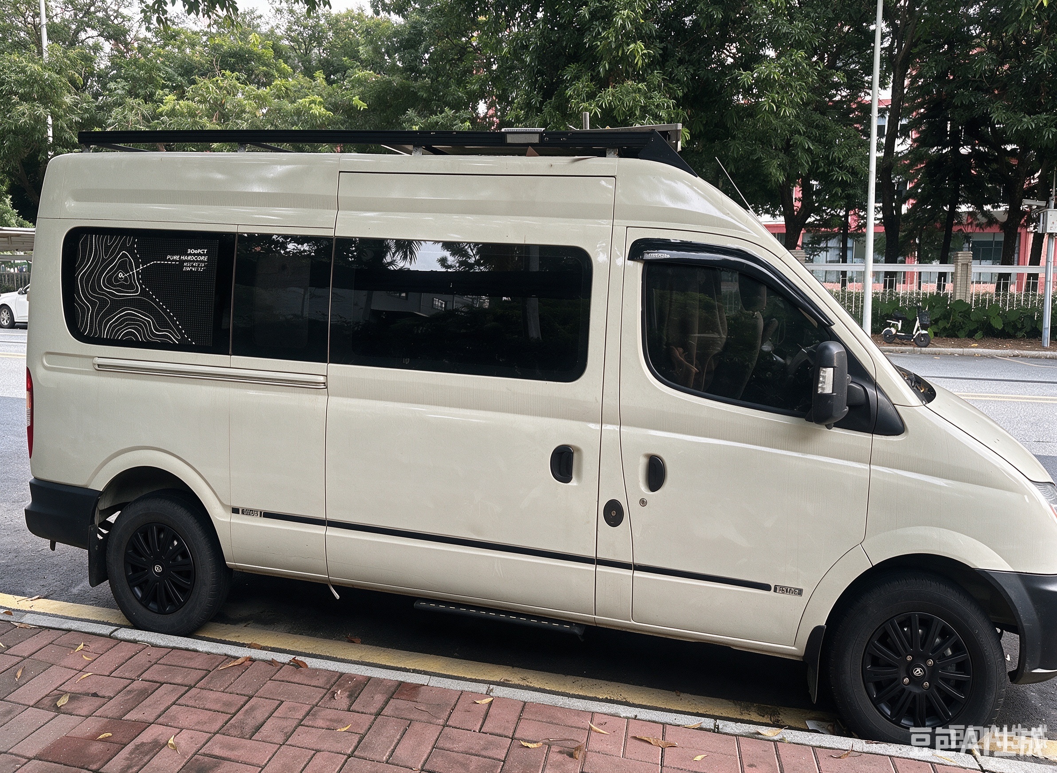
modules/03-exterior-appearance/assets/exterior/更换后窗贴纸.jpeg
