shakeyo/MY-VAN/modules/03-exterior-appearance/assets/exterior/汽车外观优化建议 (1).jpeg

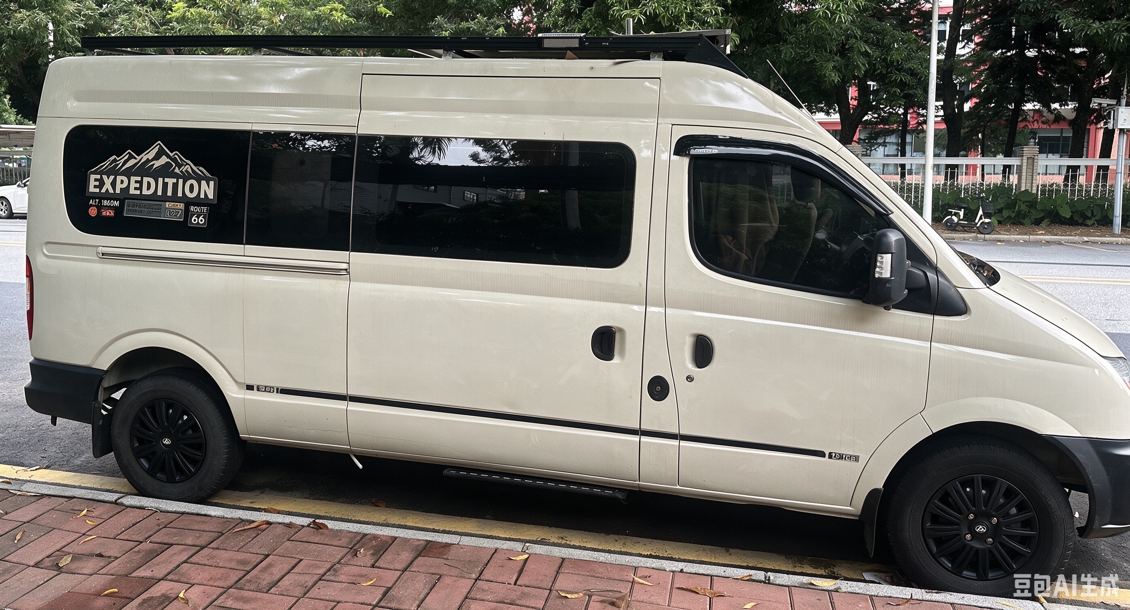
modules/03-exterior-appearance/assets/exterior/汽车外观优化建议 (1).jpeg
