shakeyo/MY-VAN/modules/03-exterior-appearance/assets/exterior/汽车外观设计细节调整 (1).png

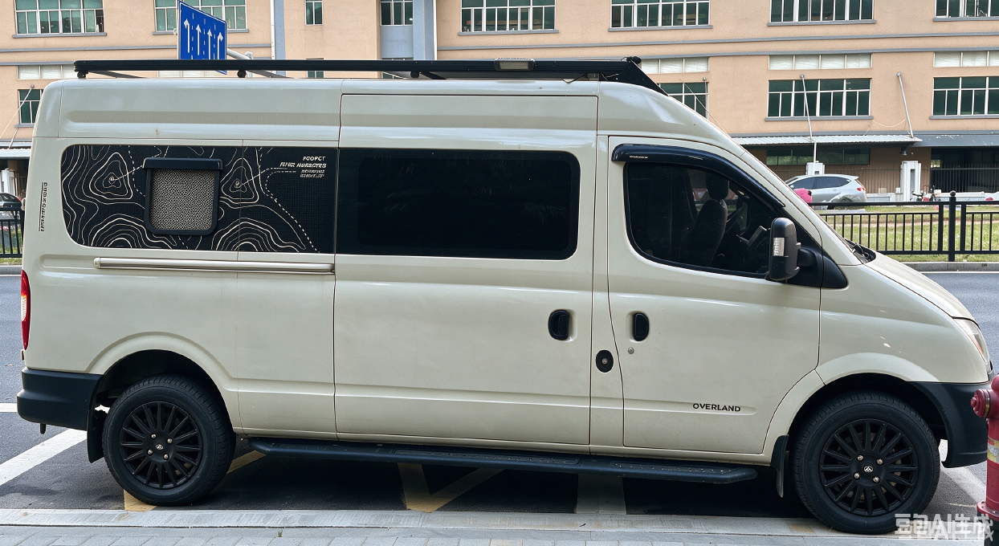
modules/03-exterior-appearance/assets/exterior/汽车外观设计细节调整 (1).png
