shakeyo/MY-VAN/modules/03-exterior-appearance/assets/exterior/车辆外观改装方案.png

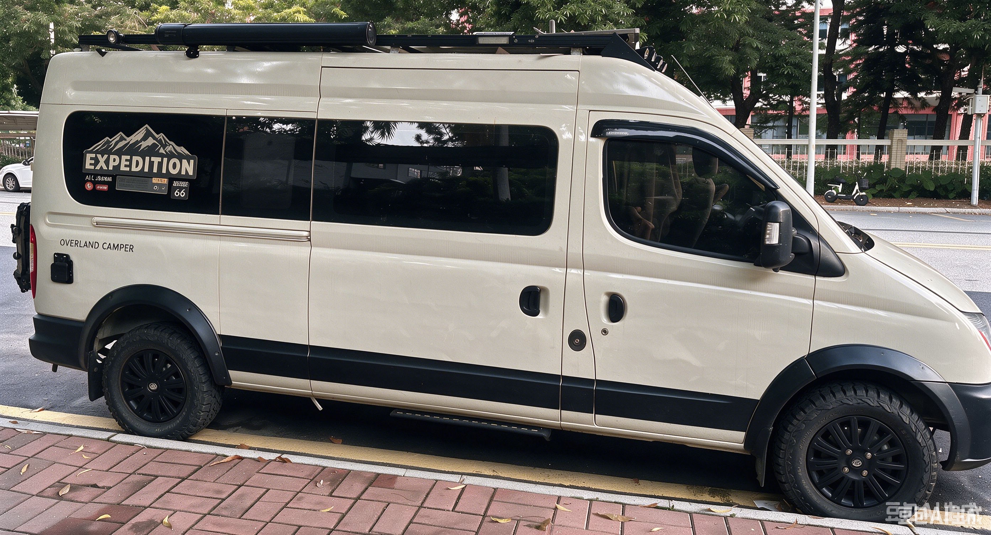
modules/03-exterior-appearance/assets/exterior/车辆外观改装方案.png
