shakeyo/MY-VAN/modules/03-exterior-appearance/assets/exterior/车辆装饰建议 (1).png

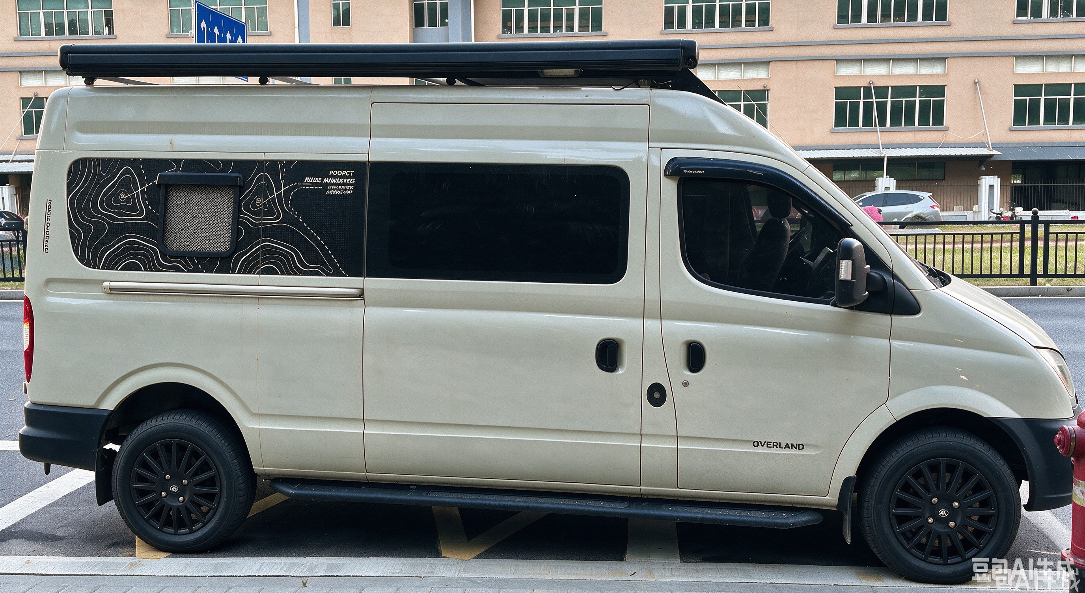
modules/03-exterior-appearance/assets/exterior/车辆装饰建议 (1).png
