shakeyo/MY-VAN/modules/03-exterior-appearance/assets/exterior/车辆装饰建议 (4).jpeg

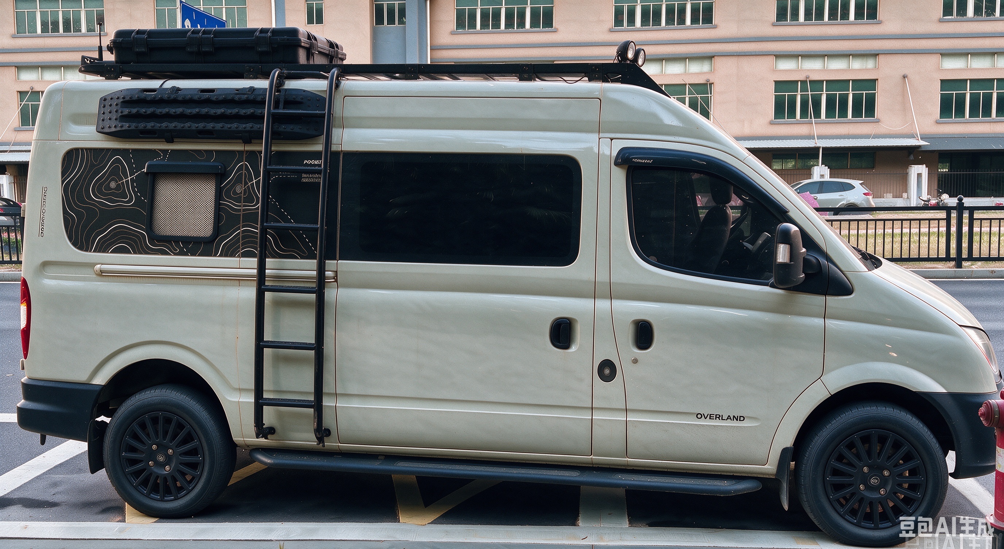
modules/03-exterior-appearance/assets/exterior/车辆装饰建议 (4).jpeg
