shakeyo/MY-VAN/modules/03-exterior-appearance/assets/exterior/轮毂盖适配与外观改进 (1).png

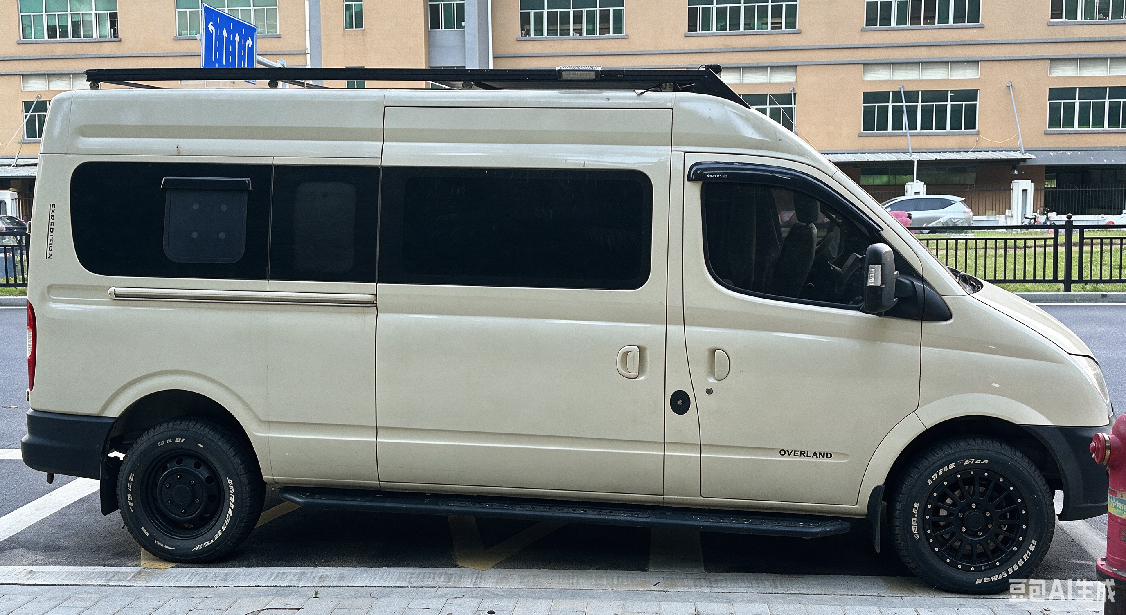
modules/03-exterior-appearance/assets/exterior/轮毂盖适配与外观改进 (1).png
