shakeyo/MY-VAN/modules/04-power-system/3dmodels/relay-box/renders/2_inside.png

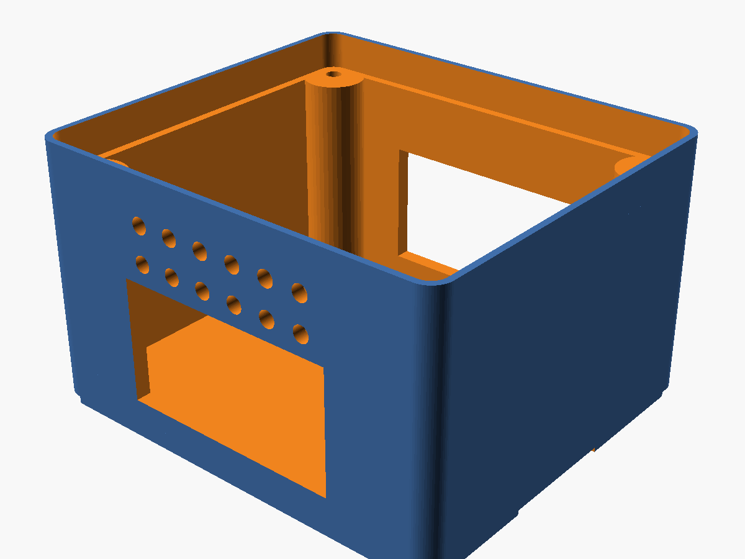
modules/04-power-system/3dmodels/relay-box/renders/2_inside.png
