shakeyo/MY-VAN/modules/04-power-system/3dmodels/relay-box/renders/3_on_rail.png

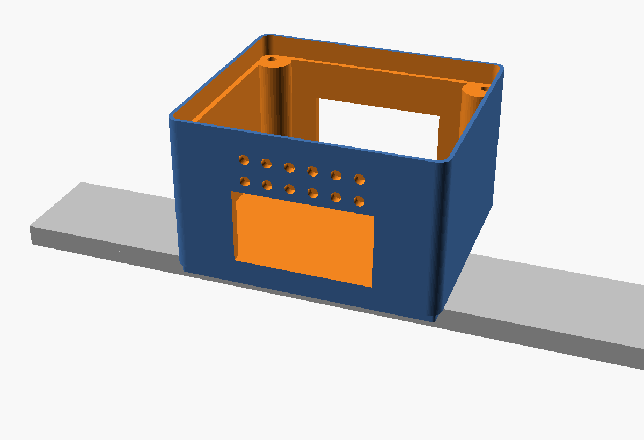
modules/04-power-system/3dmodels/relay-box/renders/3_on_rail.png
