shakeyo/MY-VAN/modules/04-power-system/3dmodels/relay-box/renders/4_underside.png

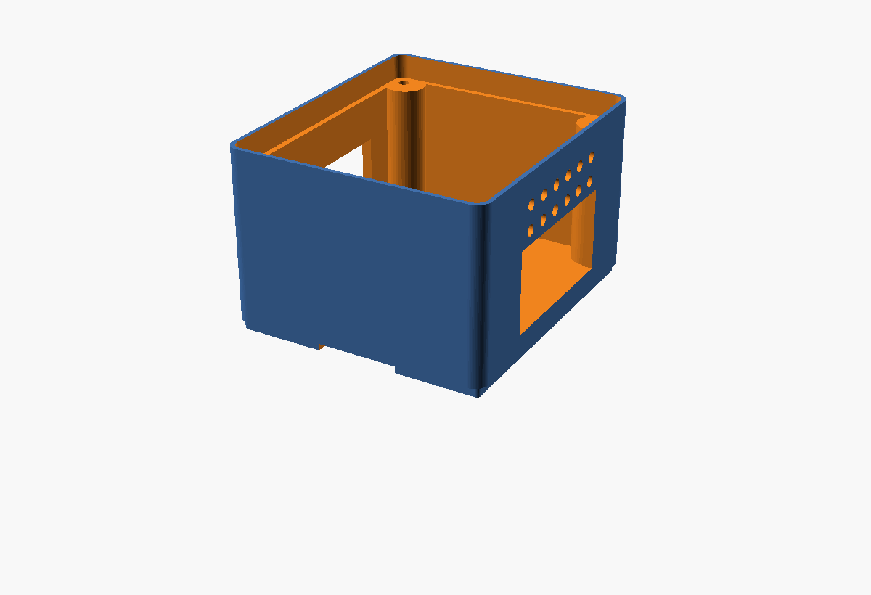
modules/04-power-system/3dmodels/relay-box/renders/4_underside.png
