shakeyo/MY-VAN/modules/07-cabinetry/assets/photos/6f1b460a-c174-48f0-b260-dbb0346b4d32.jpeg

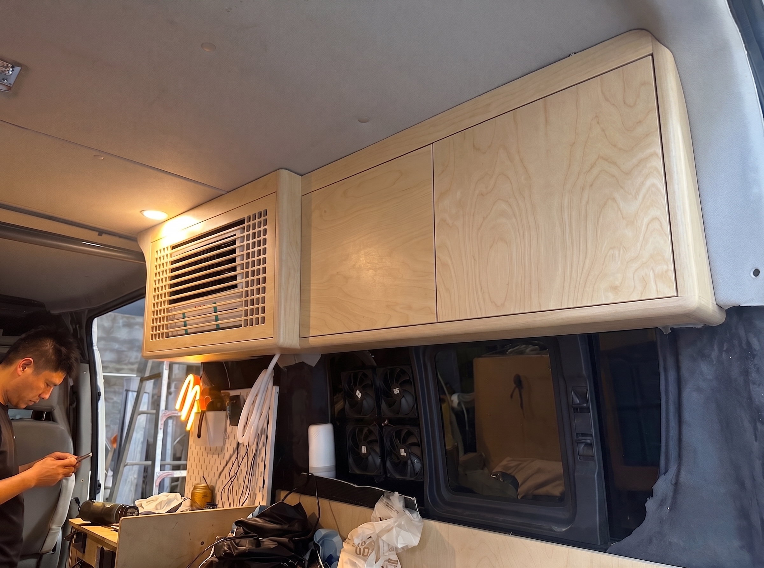
modules/07-cabinetry/assets/photos/6f1b460a-c174-48f0-b260-dbb0346b4d32.jpeg
