shakeyo/MY-VAN/modules/07-cabinetry/assets/photos/8a11ee2ffc8d29e75352731b4d4f16.png

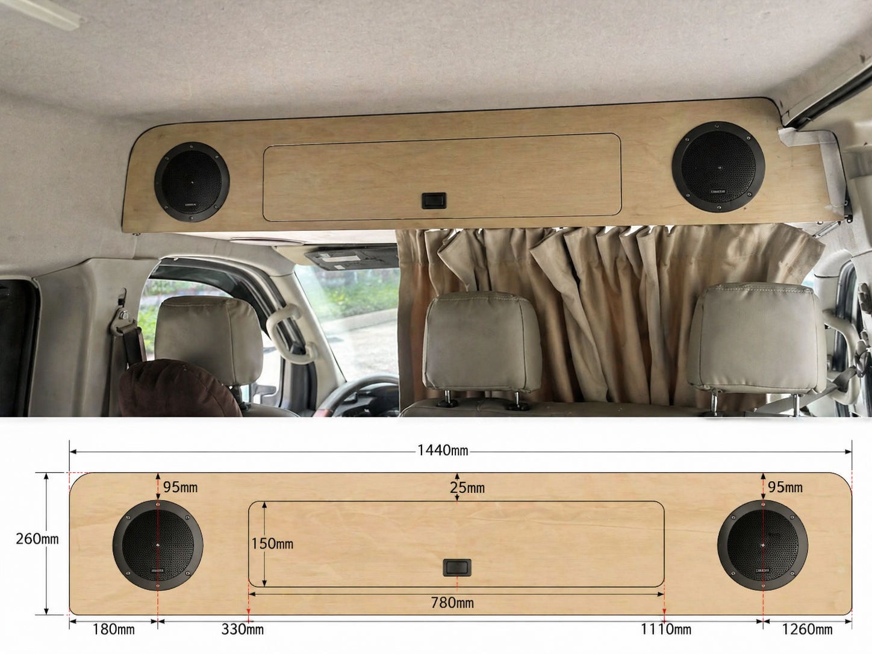
modules/07-cabinetry/assets/photos/8a11ee2ffc8d29e75352731b4d4f16.png
