shakeyo/MY-VAN/modules/07-cabinetry/assets/photos/506c67610cc63c72e7f66cf3d7124e.png

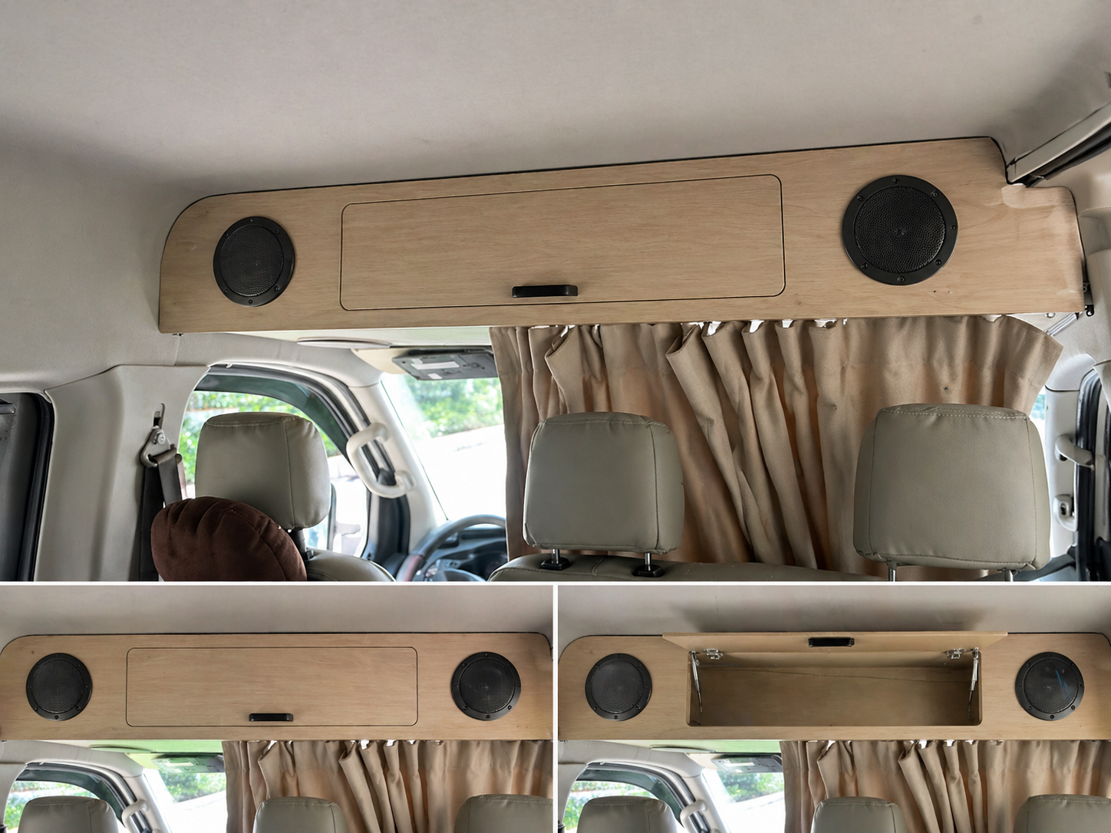
modules/07-cabinetry/assets/photos/506c67610cc63c72e7f66cf3d7124e.png
