shakeyo/MY-VAN/modules/07-cabinetry/assets/photos/b04899805896a2d4edf723745e1eed.png

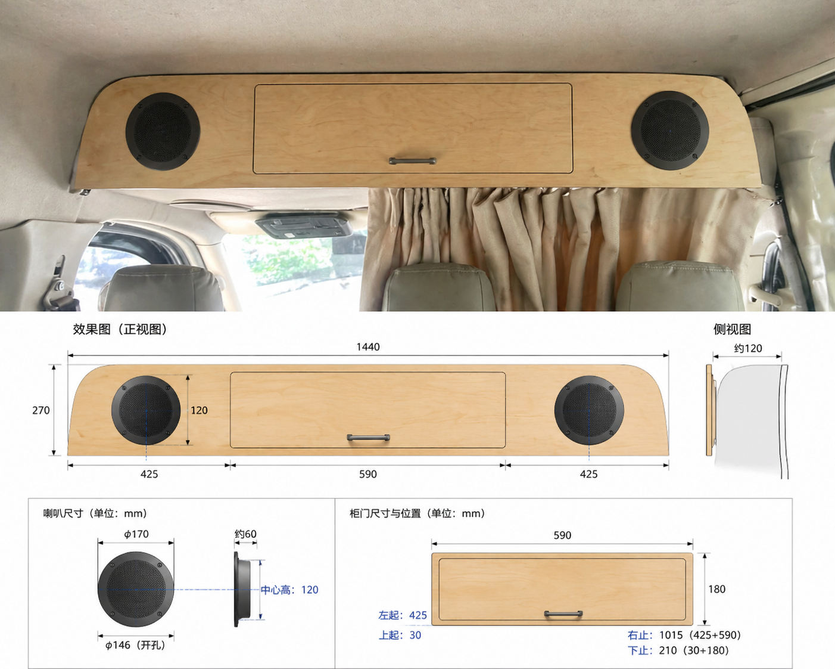
modules/07-cabinetry/assets/photos/b04899805896a2d4edf723745e1eed.png
