shakeyo/MY-VAN/modules/07-cabinetry/assets/photos/cc5f63d1fdfe637569b76ae383aa89.png

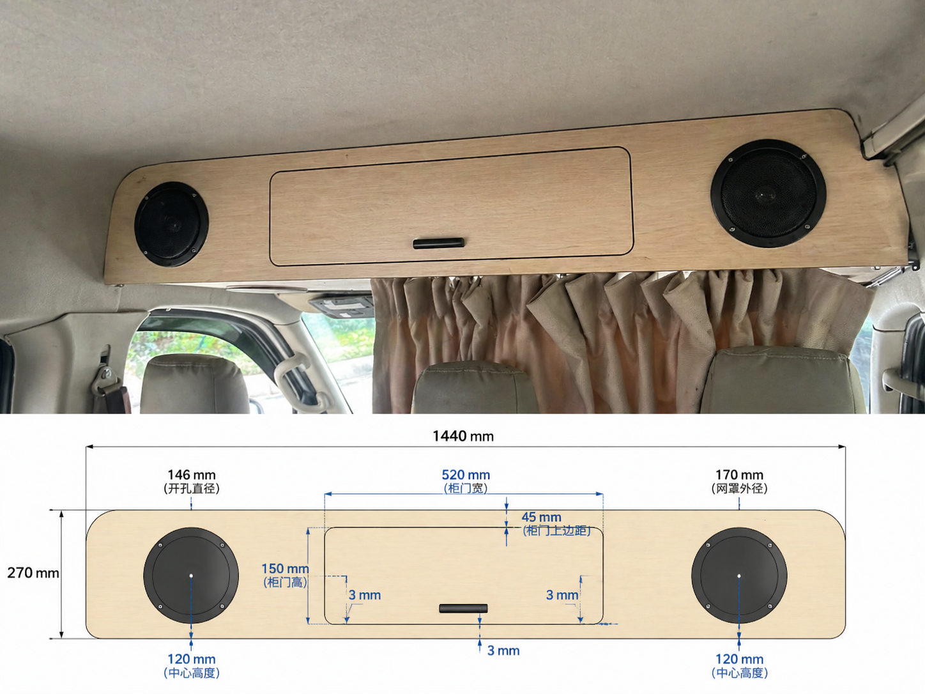
modules/07-cabinetry/assets/photos/cc5f63d1fdfe637569b76ae383aa89.png
