shakeyo/MY-VAN/modules/07-cabinetry/assets/photos/Xnip2026-07-12_14-37-34.jpg

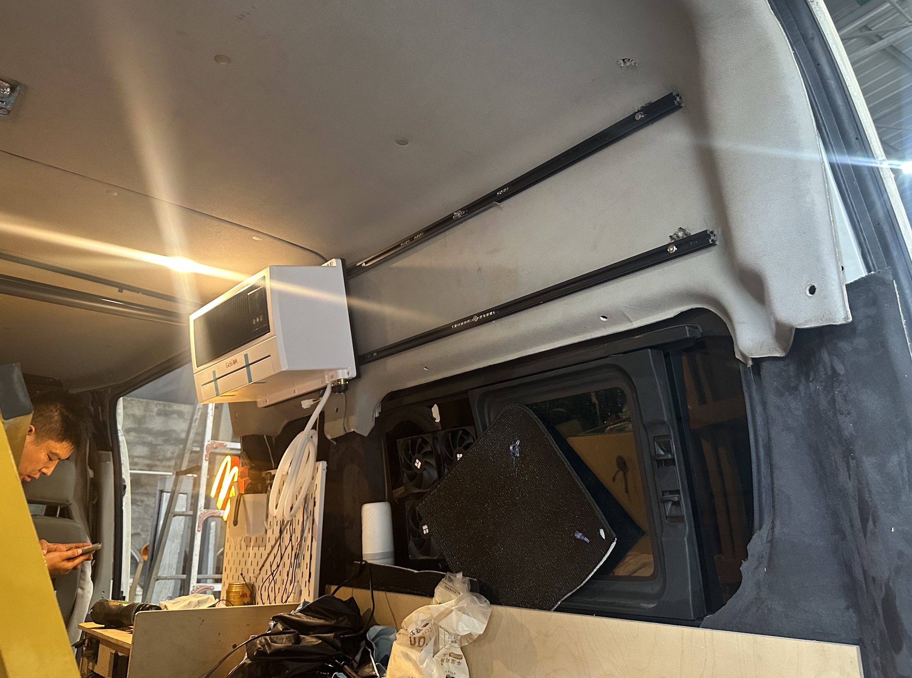
modules/07-cabinetry/assets/photos/Xnip2026-07-12_14-37-34.jpg
