shakeyo/MY-VAN/modules/07-cabinetry/assets/photos/空调位吊柜效果图制作 (2).png

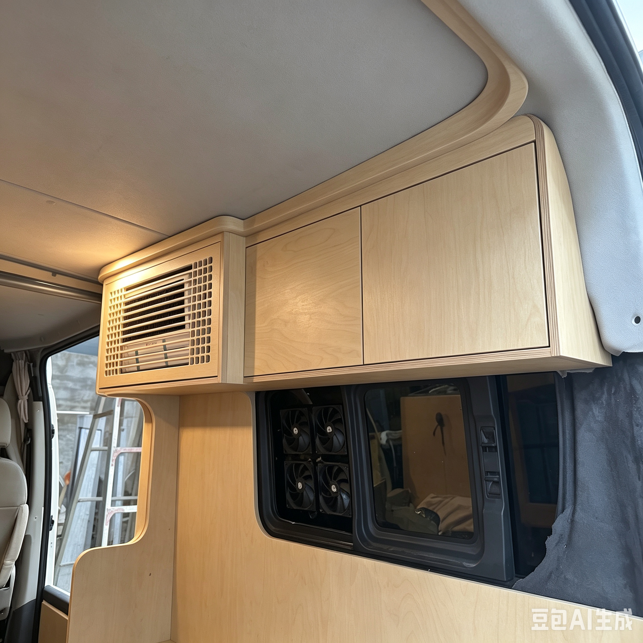
modules/07-cabinetry/assets/photos/空调位吊柜效果图制作 (2).png
