shakeyo/MY-VAN/modules/04-power-system/bom.md

# 材料清单：电力系统

## 系统级

| 名称 | 规格/型号 | 数量 | 状态 |
|---|---|---|---|
| 磷酸铁锂电池 | 48V 100Ah | 1 | 待购 |
| 主断路器 | 直流 125A | 1 | 待购 |
| 源头熔断器 | 直流 150A | 1 | 待购 |
| 汇流排 | 铜排 48V | 1 | 待购 |
| 安德森接口 | SB50/SB175 | 若干 | 待购 |
| XT90/XT60 | 航模插头 | 若干 | 待购 |
| 库仑计 | TF03K + 分流器 | 1 | 已购 |
| DC-DC 行车充电器 | 48V 40A | 1 | 待购 |
| MPPT 控制器 | 48V 太阳能 | 1 | 待购 |
| 市电充电器 | 58.4V | 1 | 待购 |
| 逆变器 | **5000W**，48V→220V 纯正弦波，**带 RJ 口远程控制面板（短接法可切）** | 1 | **已购** |
| 逆变器控制继电器 | 车规 12V 线圈 + 干接点（切 RJ 口两根线） | 1 | 待购（待实测 RJ 口电气特性后选型） |
| 逆变器直流动力线 | **≥25mm²（建议 35mm²）** 铜线 + 保险 150~200A | 1 套 | 待购 |
| 交流接触器 | 两极 25-40A | 1 | 待购 |
| 急停按钮 | 红色蘑菇头 | 1 | 待购 |

## 中门配电箱

详见 [design-distribution-box.md](design-distribution-box.md)。

| 物料 | 规格 | 数量 |
|---|---|---|
| 配电箱 | 400×300×150mm，IP54+ | 1 |
| 直流隔离开关 | 48V DC，80A | 1 |
| 直流保险座/断路器 | 60A | 1 |
| 48V 保险盒 | 6 路或 12 路汽车片式 | 1-2 |
| 48V 负极汇流排 | 紫铜镀镍 M6，6-8 位 | 1 |
| 正极母排 | M6，4-6 位 | 1 |
| DCDC 降压模块 | 48V→12V，40A | 1 |
| 12V 保险盒 | 12 路汽车片式 | 1 |
| 12V 负极汇流排 | 紫铜镀镍 M5，8-10 位 | 1 |
| 10 路继电器模块 | 12V 供电，RS485，干接点 | 1 |
| 开关面板 | 6 路带灯，12V 背光 | 1 |
| 直流接触器 | 线圈 48V DC，主触点 ≥ 水泵电流×2 | 2 |
| 续流二极管 | 1N5408 | 4 |
| UK2.5N 接线端子 | 0.2-2.5mm² | 40 |
| UK3N 接线端子 | 0.2-4mm² | 6 |
| C45 DIN 铝导轨 | 50cm | 1 |
| 硅胶线 8AWG | 红/黑 | 按需 |
| 硅胶线 6mm² | 红/黑 各 3m | 6m |
| 硅胶线 2.5mm² | 红/黑 各 5m | 10m |
| 硅胶线 1.5mm² | 红/黑 各 3m | 6m |
| 硅胶线 0.75mm² | 各色 各 10m | 50m |
| 硅胶线 0.5mm² | 各色 各 10m | 50m |
| 双绞屏蔽线 | — | 10m |
| **14P 信号线**（0.5mm²×14 芯） | 蓝皮 1 根（**入口复合线，决10 终版**；主控复合线已随决2 取消、DI 主干已缩为 3 芯），仍统一 14P 备线 | 按长度 |
| **14P 插头/插座**（JST SM 或 XH，含端子） | 14pin，面板侧插座 + 线缆侧插头 | 1 对 + 备件 |
| Deutsch DT04-12P | 12pin | 1 套 |
| Deutsch DT04-2P | 2pin | 12 套 |
| Anderson SB50 | 蓝色 | 2 套 |
| GX12-3 航空插头 | 3pin | 2 套 |
| OT 铜鼻子 | OT8-8 ~ OT0.5-3 | 各若干 |
| 液压压线钳 | — | 1 |
| 万用表 | — | 1 |

## 通用辅材

| 名称 | 规格/型号 | 数量 | 状态 |
|---|---|---|---|
| PP 波纹管 | 线束保护 | 若干 | 待购 |
| 热缩管 | Φ3~Φ12mm assorted | 若干 | 待购 |
| 线束标签 | 防水标签 | 若干 | 待购 |
| 号码管 | 0.75~2.5mm² | 1 包 | 待购 |
| 扎带 | 3×150mm | 1 包 | 待购 |
| 保险片 | 3A~60A 各规格 | 各 5 片 | 待购 |
