shakeyo/MY-VAN/modules/05-water-system/bom.md

# 材料清单：用水系统

全车统一 **DM 管体系（韩国 DM 快速接头）· 4 分 = 管外径 6.35 mm**。设计说明见 [design.md](design.md)，施工步骤见 [build-guide.md](build-guide.md)。

> ⚠️ **买件认准口径**：DM 4 分管外径 = **6.35 mm**。**不要买 1/2" 水暖件**，两者不通用。
>
> **DM 管体系件齐备**：三通、弯头（90°）、直通、穿板、外牙/内牙转换全系列都有（[DM 食品级附件](https://dailytek.cn/spjfj/20.html)），本方案每个分支与转角都用对应管件，无需自制过渡件。

## 一、水箱与水源

| 名称 | 规格/型号 | 数量 | 状态 |
|---|---|---|---|
| 车底清水箱 | 食品级 PE，60~100L，**带防浪板**，带液位口 | 1 | **已装** ✅ |
| 灰水箱 | 食品级 PE，可拆卸清倒 | 1 | 待购 |
| **车尾可移副箱** | 食品级 PE，**20~25 L**，带轮 + 提手，顶部给水盖 | 1 | 待购，见 §十 |
| ~~车内取水桶~~ | 原方案备用水源，**本期不做** | 0 | **不买** |
| 外置注水口 | 车身左侧，带锁盖 | 1 | **已装** ✅（主箱原生加水口，保留） |

> **本节不变**：车底主箱已装、左侧外置注水口保留。**新增的是 §十 的"车尾可移副箱 + 中门/尾门双加水口"**，两者是叠加关系，不是替换。

## 二、取水桶改造件（本方案新增）

| 名称 | 规格/型号 | 数量 | 状态 |
|---|---|---|---|
| **DM 4 分穿板直通** | DM 4 分快接 bulkhead，含**内外硅胶垫圈 ×2 + 锁紧螺母** | 1 | 待购 |
| **食品级硅胶软管** | 内径 6~8 mm，**壁厚 ≥2 mm**，长 30~50 cm | 1 | 待购 |
| **304 不锈钢配重沉头** | 适配硅胶管外径，含卡箍 | 1 | 待购 |
| 软管转 4 分快接 | 硅胶软管 → DM 4 分快接公头 | 1 | 待购 |
| 卡箍 | 不锈钢，适配硅胶管外径 | 2 | 待购 |
| 防尘通气滤芯 | 接口 φ3~5 mm，装桶盖通气孔 | 1 | 待购 |

> 替代方案：直接购买**成品"纯净水桶 4 分快接桶盖"**，可省去穿板直通与开孔，但需先确认桶口螺纹规格匹配。

## 三、切换阀组（本方案新增）

| 名称 | 规格/型号 | 数量 | 状态 |
|---|---|---|---|
| **DM 4 分球阀** | DM 4 分快接，手动 | 2 | 待购 |
| ~~DM 4 分三通~~ | **已计入 §4.2**（汇流三通），此处不重复计数 | — | 见 §4.2 |
| 快接母头（自封型） | DM 4 分，固定在柜壁供插拔 | 1 | 待购 |
| 标签 | A=车底箱 / B=车内桶 | 2 | 待购 |

> **必须选手动球阀，不用电磁阀**——吸水侧自动切换一旦逻辑出错即干转烧泵，见 [design.md](design.md#双水源切换-本方案核心)。

## 四、管路与 DM 管件

### 4.1 管材

| 名称 | 规格/型号 | 数量 | 状态 |
|---|---|---|---|
| **DM 管** | 4 分（**外径 6.35 mm**），食品级 PE，不透明或避光 | 若干 | 已用 DM 体系 |
| 管卡 / 固定座 | 适配 4 分管，每 30~40 cm 一个 | 若干 | 待购 |
| **专用切管器** | DM 4 分管用（**不可用剪刀替代**） | 1 | 待购 |

### 4.2 DM 管件（按图配齐）

| 名称 | 规格 | 数量 | 用途 | 状态 |
|---|---|---|---|---|
| **DM 4 分三通**（T 型快插） | 4 分 | **9** | 见下方明细表 | 待购 |
| **DM 4 分弯头**（90°） | 4 分 | 8 | 柜内转角、贴壁走线（**替代硬弯管**，避免 PE 管憋折） | 待购 |
| **DM 4 分封堵头** | 4 分 | 1 | **车尾热水预留**末端封堵 | 待购 |
| **DM 4 分直通** | 4 分 | 4 | 断点续接、穿板前后接续 | 待购 |
| **DM 4 分穿板直通** | 4 分 bulkhead，含内外硅胶垫圈 ×2 + 锁母 | 1 | 取水桶盖穿孔 | 待购 |
| DM 4 分内牙/外牙转换 | 4 分 → 螺纹 | 2 | 接小厨宝进出水口、混水阀螺纹口 | 待选 |
| **空 DM 管（预埋）** | 4 分，两端封堵 | 1 根 | 车尾预留拉管通道（将来装车外淋浴用） | 待购 |

**9 个三通的明细（防漏买／防重复买）**：

| # | 位置 | 作用 | 所在图 |
|---|---|---|---|
| 1 | 切换阀组出口 | **双水源汇流**（球A + 球B → 粗滤） | 总图 |
| 2 | 冷水主干 | **分出热水支路**（→ 球H） | 总图 |
| 3 | 冷水主干 | 分支 → 水槽冷水口 | 总图 |
| 4 | 冷水主干 | 分支 → 外置取水 | 总图 |
| 5 | 冷水主干 | 分支 → 车尾冷水 | 总图 |
| 6 | 热水主干 | 分支 → 水槽热水口 | 总图 |
| 7 | 热水主干 | 分支 → **车尾热水预留**（封堵） | 总图 |
| 8 | 冷水主干（末端） | 分支 → **恒温阀冷入口① + 球D**（两路） | 总图 |
| 9 | 热水主干（球O 之后） | **球D 汇入点** | 总图 |

> **恒温阀两个入口本身不需三通**：热入口在热水主干上分支（三通7的位置）接入、冷入口在冷水主干分支末端接入。**但冷入口处「三通⑧」同时分出球 D**，故该处需一个三通；**球 D 汇入热水主干处「三通⑨」**也是一个。
>
> **为什么分支这么多**：本方案**每个用水点从主干独立取一路，互不串接**，故三通用量多于"串联式"。这是有意设计——串联会让某点受他点开关干扰（水压、水温都会变）。
>
> **注意不要重复计数**：§三 切换阀组里的汇流三通 = 上表 #1；§6.1 车尾预留的三通 = 上表 #7。两处已计入 **9** 个之内。
>
> **弯头必须用 DM 90° 弯头，不要把 PE 管硬弯**——DM 4 分 PE 管弯曲半径大，硬弯会憋折导致水流衰减甚至管壁疲劳开裂。柜内每个转角都应装弯头。
>
> **车尾预留的三通 + 封堵头成本仅几块钱**，但将来加装车外淋浴时省一次拆柜返工，强烈建议现在做。

## 五、水泵与保护

| 名称 | 规格/型号 | 数量 | 状态 |
|---|---|---|---|
| 水泵 | **48V 隔膜泵**，自带压力开关 | 1 | 待确定型号 |
| 前置粗滤 | 不锈钢网，DM 4 分快接，**可拆洗** | 2 | 待购 |
| 单向阀（止回阀） | DM 4 分快接 | 1 | 待购 |
| 蓄能罐 | 小容量，稳定出水减少启停 | 1 | 待选 |
| 续流二极管 | **1N5408**（阴极朝正，并联泵两端） | 1 | 见 [04 BOM](../04-power-system/bom.md) |
| 减震垫 | 泵体安装用 | 4 | 待购 |
| 水泵电源插头 | Anderson SB50 蓝色 | 1 | 见 [04 BOM](../04-power-system/bom.md) |

> 泵的电气部分（中8.Y4 直切、续流二极管、15A 保险 F48-2）见 [04-power-system](../04-power-system/design-distribution-box.md#63-48v-水泵控制详图几十瓦--直接-y-切--续流二极管)。

## 六、热水子系统（小厨宝）

> 设计原理见 [design.md §热水子系统](design.md#热水子系统-米家小厨宝-s1)。**小厨宝不接混水阀**，靠自身温控；调温分层：水槽用自带龙头，淋浴用独立恒温阀。

| 名称 | 规格/型号 | 数量 | 状态 |
|---|---|---|---|
| **热水器** | **米家智能小厨宝 S1**（储水式 7L / 2000W） | 1 | 已有 |
| **阀 H 热水进水** | DM 4 分球阀 | 1 | 待购 |
| **阀 O 热水出水** | DM 4 分球阀 | 1 | 待购 |
| **阀 D 夏季旁路** | DM 4 分球阀，**冷水主干 → 热水主干（球O 之后）** | **1** | **必装 · 与热水支路同期购**（不装：夏季关H/O后**水槽热水口断水**、恒温阀热入口不出水） |
| **淋浴恒温混水阀（车内）** | **蜡感温包式**，4 分接口，自带流量补偿 | 1 | **已采购** |
| **泄压阀（安全阀）** | 储水式必备，**排水口接软管引至车外/灰水箱** | 1 | 待购 |
| ~~止回阀（热水侧/厨宝出水）~~ | **已删除** —— 冷热同压无倒灌驱动，厨宝进水口已内置 | 0 | **不买** |
| 泄压排水软管 | 引至车外或灰水箱 | 1 | 待购 |
| 热水管保温 | 橡塑保温管，减少管路热损 | 若干 | 待购 |
| 电源插头/接线 | 2000W 回路，由 220V 逆变器供电 | 1 | 待确认逆变器余量 |

### 6.1 车尾热水预留（本期铺管，不装阀）

> **决策**：车外洗澡帐篷未接，**本期不装车尾恒温阀**，但**热水管必须先铺到车尾**，趁柜体未做满一次做完。见 [design.md §未来增项预留](design.md#未来增项预留-车尾车外淋浴)。

| 名称 | 规格/型号 | 数量 | 状态 |
|---|---|---|---|
| ~~DM 4 分三通~~ | **已计入 §4.2**（第 7 个：车尾热水预留分支） | — | 见 §4.2 |
| **DM 4 分管** | 4 分，铺至车尾柜 | 按实测长度 | 待购 |
| **DM 4 分弯头** | 4 分 90°，转角用 | 按转角数 | 待购 |
| **DM 4 分封堵头** | 车尾端封死，**手拧不打胶**（便于将来拆） | 1 | 待购 |
| 热水管保温 | 车尾预留段同冷水管做保温 | 若干 | 待购 |
| 标签 | 「热水预留·勿拆」 | 1 | 待购 |
| ~~车尾恒温阀~~ | **待车内恒温阀验证通过后再买** | 0~1 | **暂不买** |
| ~~车尾手动混水阀~~ | 验证不通过时的替代方案（40~90 元） | 0~1 | 备选 |

> **冷水侧无需新增**：现有车尾冷水管将来直接进恒温阀冷水口；现有冷水快拆头装阀时**挪到阀出口**，车尾仍是单一花洒口。

> ⚠️ **夏季三阀操作**：关球H/球O（隔离厨宝）→ 开球D（冷水灌入热水主干）→ 全车热水点都能出冷水，**无需淋浴旁路**。
>
> ⚠️ **已删除的件勿再加回**：阀 C 旁通（重复路径）、阀 C 配套三通 ×2、厨宝出水侧止回阀（理由不成立）。详见 [design.md](design.md#曾经设计过、现已删除的件-留档-避免重复入坑)。
>
> ⚠️ **泄压阀排水绝不可堵死** —— 储水式加热时罐内膨胀，堵死会导致内胆超压。
>
> ⚠️ **2000W 用电需核算**：小厨宝额定 2000W，启用时占用逆变器较大余量，建议与 04 模块确认逆变器容量及是否需错峰使用（见 [04-power-system](../04-power-system/)）。

## 七、用水点与排水

| 名称 | 规格/型号 | 数量 | 状态 |
|---|---|---|---|
| 水槽龙头 | **自带冷热调温**（内部即混水阀） | 1 | 见 [07-cabinetry](../07-cabinetry/design-countertop.md) |
| 抽拉花洒 + 软管 | 2.5~3.5 m | 1 | 见 [09 BOM](../09-shower-module/bom.md) |
| U 型存水弯 | 下水防臭 | 1 | 待购 |
| 排水快接 | 水槽/地漏 → 灰水箱 | 2 | 待购 |
| 排水阀 | 车底水箱低位排空 | 1 | 待购 |

### 7.1 车外取水口（中门 · 洗车）

> 决策见 [design.md §车外取水口](design.md#车外取水口-中门-·-洗车用)：**走泵单模式 + 单向阀**，不做双模式。只做中门一个口。

| 名称 | 规格/型号 | 数量 | 状态 |
|---|---|---|---|
| **带自锁快接头** | 房车外接水口型 | 1 | **已装**（内部尚未接管） |
| **球阀** | DM 4 分，平时关闭 | 1 | 待购 |
| **单向阀（车外口）** | DM 4 分，**阻外部水倒灌** | 1 | 待购 |
| DM 4 分三通 | 冷水主干取路 | 1 | 见 §4.2 第 4 项 |
| 洗车软管（车外用） | 内径 8~10mm，2~3m | 1 | 洗车机自带 |

> ⚠️ **用车上口供水时必须同时开泵** —— 否则洗车机自吸会把管路抽成负压，可能吸开泵止回阀、吸扁取水桶。
>
> ⚠️ **绝不在车上管路里抽浑水** —— 泥沙会卡死隔膜泵阀片。
>
> **退路**：洗车机吸水管可直接插桶，不依赖车上口。

## 八、传感器

| 名称 | 规格/型号 | 数量 | 状态 |
|---|---|---|---|
| 清水箱水位传感器 | 超声波 / 压力式，485 输出 | 1 | 待购 |
| 灰水箱水位传感器 | 超声波 / 压力式，485 输出 | 1 | 待购 |
| 水表（流量脉冲） | 直接进 485 模块，兼作干转保护输入 | 1 | 待购 |

> 485 传感器选型必须 **9600 8N1**，与全车总线同速，见 [10-smart-control](../10-smart-control/)。

## 九、冬季与保温

| 名称 | 规格/型号 | 数量 | 状态 |
|---|---|---|---|
| 保温棉 / 橡塑管 | 包裹车底水箱及外露管段 | 若干 | 待购 |
| 减震胶条 | 水箱与挂架之间 | 若干 | 待购 |

> 详细规格与购买链接请补充到「备注」列。

## 十、车尾可移副箱与双加水口（本方案新增）

> 设计见 [design-tank-portability.md](design-tank-portability.md)，切换细节图见 [diagrams/water-portability.svg](diagrams/water-portability.svg)，**全局总图见 [diagrams/water-overview-2.svg](diagrams/water-overview-2.svg)**。
> **口径不变：仍走 DM 4 分（1/4" 管外径 6.35 mm）。车底主箱与泵组不动，两箱之间不输水。**

### 10.1 已有件（照片盘点，正好够用）

| 名称 | 照片位置 | 数量 | 用在本方案 |
|---|---|---|---|
| DM 4 分快接球阀（白底灰柄） | 左中 | 4（首批 2 + 补 2） | **W1 灌主箱 / W2 灌副箱**（加水侧）+ **A 抽主箱 / B 抽副箱**（用水侧） |
| DM 4 分快接三通 | 正中 | 2 | 加水汇流 **J** + 吸水汇流 **Y** |
| DM 4 分快接公头 | 中部靠右 | 1 | **K1 快拆公头**（装在可移副箱上） |
| DM 4 分穿板直通 + 锁紧螺母 | 下部（带白管） | 1 | **K2 快拆母头**（穿板固定在柜板） |
| 黑色螺旋花洒 + 手柄花洒头 | 右上 | 1 | 尾门花洒 |

> **A、B、Y 三件 design.md 本来就已计入**（切换阀组 + 汇流三通①）。本方案**实际新增的只有 W1、W2、J**。

### 10.2 必补件（本方案缺口）

| 名称 | 规格/型号 | 数量 | 状态 |
|---|---|---|---|
| **可移动副水箱** | 食品级 PE，**20~25 L**，带轮 + 提手，**顶部 φ35~45 给水盖**，箱底出水口 | 1 | 待购（★核心件） |
| **快拆自封连接器**（dry-break / 止水） | **4 分，bulkhead 穿板型**，公头 + 母头各带自封；**必须实物验证"拔开不滴"** | 1 套 | 待购（★核心件） |
| **RV 自动回吸切断阀注水口** | 3/4" 或 1-1/4" 螺纹，后接 3/4" 外牙或 4 分快接，带防尘盖 | **2** | 待购（★中门 + 尾门各一个） |
| **螺纹底阀** | 3/4" 外线程，开启压力 **0.8~1.2 bar**，内置于副箱内壁 | 1 | 待购 |
| **DM 4 分球阀（补 2 个）** | 4 分快接，凑齐 W1/W2（A/B 用首批两个） | 2 | 待购 |
| **DM 4 分三通（补 1 个）** | 加水汇流 J | 1 | 待购 |
| **柔性波纹软管** | 食品级，内径 6~8 mm，壁厚 ≥2 mm，长 30~50 cm | 1 | 待购 |
| **箱内粗滤** | 不锈钢网，可拧入副箱出水口，可拆洗 | 1 | 待购 |
| **通气孔防尘滤芯** | φ3~5，装给水盖透气孔 | 1~2 | 待购 |
| **溢流管 + 透气帽** | φ6 软管 + 防水透气帽，引至接水盘 | 1 套 | 待购 |
| **铝型材格位 + EPDM 胶垫** | 2020/3030 型材 + 3 mm EPDM，导槽/限位 | 1 套 | 待购 |
| **浅接水盘** | 柜下箱位下方 | 1 | 待购 |

> ⚠️ **快拆自封件必须到手实测**。净水器线上的"4 分快接"**多数不带自封**——插拔时靠上游球阀断水，买错则"快拆不漏"不成立。
>
> ⚠️ **两个注水口必须各装一个回吸切断阀**，不能一个装、另一个用普通单向阀凑——否则两注口互串溢水（见 design-tank-portability.md §7）。
>
> ✅ **不需要买**：箱间补给泵、补给单向阀、额外的吸水单向阀（吸水侧是负压，A/B 都在泵前）。
