shakeyo/MY-VAN/modules/02-external/bom.md

# 材料清单：车顶平台与太阳能系统

| 名称 | 规格/型号 | 数量 | 状态 |
|---|---|---|---|
| 铝型材 3060 | 欧标，黑色氧化，2500mm | 2 | 待购 |
| 铝型材 3060 | 欧标，黑色氧化，1600mm | 2 | 待购 |
| 铝型材 3030 | 欧标，黑色氧化，1540mm | 4-6 | 待购 |
| L 型平连接板 | 角部连接，上下双层 | 若干 | 待购 |
| 强力角码 + T 型螺母 | 内梁固定 | 若干 | 待购 |
| L 型固定角码 | 车身锚固 | 若干 | 待购 |
| 黑色槽盖条 | 欧标 30 系列，约 20 米 | 1 | 待购 |
| 西卡结构胶 | 252 或 221，黑色 | 若干 | 待购 |
| 太阳能板 | 适配尺寸 | 若干 | 待购 |
| 太阳能板压块 | 配套 | 若干 | 待购 |
| MPPT 控制器 | 接入 48V 系统 | 1 | 待购 |
| 蓝色螺纹胶 | 乐泰 243 | 1 | 待购 |

> 详细规格与购买链接请补充到"备注"列。
>
> 车尾淋浴帐的材料清单单独列在 [design-shower-tent.md](design-shower-tent.md) §7（不重复计入本表）。
