shakeyo/MY-VAN/modules/06-hvac/bom.md

# 材料清单：HVAC 系统

| 名称 | 规格/型号 | 数量 | 状态 |
|---|---|---|---|
| 驻车空调 | 待选型 | 1 | 待购 |
| 柴油暖风 | 待选型 | 1 | 待购 |
| 换气扇 | 双向换气 | 1 | 待购 |
| 温控风扇 | 12V，PWM 调速 | 若干 | 待购 |

> 详细规格与购买链接请补充到"备注"列。
