shakeyo/MY-VAN/modules/07-cabinetry/bom.md

# 材料清单：额头柜

| 名称 | 规格/型号 | 数量 | 状态 |
|---|---|---|---|
| 海洋板/饰面板 | 1440 × 270 mm | 1 | 待购 |
| 6.5寸喇叭 | 开孔 φ146 | 2 | 待购 |
| 喇叭网罩 | φ170，黑色亚光 | 2 | 待购 |
| 上翻铰链 | 柜门用 | 2 | 待购 |
| 磁吸/按压锁 | 柜门锁止 | 1 | 待购 |

> 详细规格与购买链接请补充到"备注"列。
