shakeyo/MY-VAN/modules/08-bed-and-seat/bom.md

# 材料清单：多功能折叠卡座

| 名称 | 规格/型号 | 数量 | 状态 |
|---|---|---|---|
| 铝型材 2020 | 欧标，黑色氧化 | 若干 | 待购 |
| 铝型材 2040 | 欧标，黑色氧化 | 若干 | 待购 |
| 强力角码 | 配套连接件 | 若干 | 待购 |
| 钢琴合页 | 翻板连接 | 2 | 待购 |
| 胶头手拧螺栓 | 快拆固定 | 若干 | 待购 |
| 重载可调铰链 | 靠背调节 | 2 | 待购 |
| 53 宽重型滑轨 | 带锁止，冰箱用 | 1 对 | 待购 |
| 海洋板 | 9mm/12mm | 若干 | 待购 |
| 拼接床垫 | 适配靠背/坐垫 | 1 | 待购 |
| USB 充电口 | 嵌入式 | 2 | 待购 |
| 220V 插座 | 嵌入式 | 1 | 待购 |

> 详细规格与购买链接请补充到"备注"列。
