shakeyo/MY-VAN/modules/10-smart-control/sensors/bom.md

# 材料清单：传感器

| 名称 | 规格/型号 | 数量 | 用途 | 状态 |
|---|---|---|---|---|
| **BLE 温湿度传感器** | 纽扣电池，**广播间隔可调、无需绑定密钥**（选 HA 集成支持型号） | 2 | 车内/储物仓环境监测 | 待购 |
| **ESP32 BLE 代理** | 任意 ESP32（S3/C3），独立供电，见 [ble-sensors.md](ble-sensors.md) | 1 | 收 BLE 广播转 HA | 待购 |
| 485 水位传感器 | 液位/压力型，**9600 8N1** | 2 | 清水箱、灰水箱 | 待购 |
| 门磁传感器 | 无源开关量 | 2 | 中门/尾门状态 | 待购 |
| 漏水传感器 | 开关量 | 2 | 底盘/窗边漏水监测 | 待购 |
| ELM327 OBD-II | 蓝牙版 | 1 | 车辆数据读取 | 待购 |

> **温湿度已改为 BLE 方案**（原为 485），决策依据见 [design.md](design.md)；
> 选型要点（无需密钥、广播间隔可调）见 [ble-sensors.md §八](ble-sensors.md)。
> **ESP32 代理建议独立一台**：主网关同跑 485+MPPT+BLE 时 Flash 会涨到 75%，偏紧。
>
> 库仑计 TF03K + 分流器已归入 [energy/](../energy/)（采购项在 [04-power-system/bom.md](../../04-power-system/bom.md) 系统级清单）。
> 485 传感器地址从 0x20 起分配（避开 1-5 继电器模块与 0x10/0x11 能源设备）。
