shakeyo/MY-VAN/modules/10-smart-control/gateway/bom.md

# 材料清单：ESP32-S3 485 网关

> 方案：S3 插**扩展底板**（自带 12V→5V/3.3V 降压 + 排母），485 部分由一块**小副板**（MAX3485 + 3P 端子）承担。

| 名称 | 规格/型号 | 数量 | 用途 | 状态 |
|---|---|---|---|---|
| ESP32-S3 开发板 | DevKitC-1，WiFi+蓝牙 | 1 | 485 网关，运行 ESPHome | 已购 |
| S3 扩展底板 | 带 6~24V→5V/3.3V buck + 板载母排，DC 端子输入 | 1 | S3 插装 + 车载供电 | 待购 |
| MAX3485 TTL→485 模块 | 3.3V，带 DE/RE 引脚，全插针输出（无 A/B 端子） | 1 | 信号转换 | 已购 |
| 小洞洞板 | 剪约 8×6 孔 | 1 | 485 小副板载体（MAX3485 + 3P 端子） | 待购 |
| 螺丝端子 | 5.08mm 3P（A/B/GND） | 1 | 485 总线输出 | 待购 |
| 短导线 / 漆包线 | 5 根，约 8cm | 1 套 | 小副板 ↔ 扩展板母排（3V3/GND/GPIO15/16/5） | 待购 |
| 屏蔽双绞线 | RVSP 2×0.5mm² | 按走线长度 | 485 总线 | 待购 |
| 485 终端电阻 | 120Ω 0.5W | 2 | 总线首尾匹配 | 待购 |
| 电解电容 | 1000μF 25V | 1 | 12V 进线侧滤波（防车载电压尖峰，可选） | 待购 |
| 热熔胶 | | | 副板 / 导线固定 | 已有 |
| 面包板 + 杜邦线 | | 1 套 | 原型验证 | 已有 |
| 设备防水外壳 | ABS 防水盒 | 1 | 封装扩展板 + 小副板 | 待购 |
| USB-to-485 转换器 | CH340/FT232 | 1 | 联调用（配模块 PC 软件） | 已购 |
