shakeyo/MY-VAN/modules/10-smart-control/robot/bom.md

# 中控台机器人材料清单（待选型）

| 项 | 规格 | 数量 | 状态 |
|----|---|---|---|
| 表情屏 | 圆/方小屏 + HDMI/USB-C 驱动板 | 1 | 待选 |
| 麦克风阵列 | USB，支持阵列定位与否待定 | 1 | 待选 |
| 喇叭 | USB 或 3.5mm | 1 | 待选 |
| ESP32 桥接板 | C3/S3，I/O 桥用 | 1 | 待选 |
| 舵机 | 转头/手臂，数量按结构定 | 4-6 | 待选 |
| 触摸传感器 | 电容触摸片 | 1 | 待选 |
| 外壳 | 3D 打印件 + 螺丝 | 1 套 | 待设计 |
| 线材 | USB 延长、舵机线、电源 | 若干 | 待定 |
