shakeyo/MY-VAN/modules/09-shower-module/bom.md

# 材料清单：淋浴模块

| 名称 | 规格/型号 | 数量 | 状态 |
|---|---|---|---|
| 不锈钢接水盆 | 定制，带冲压下沉式下水口 | 1 | 待购 |
| 铝型材 2020 | 欧标，黑色氧化 | 若干 | 待购 |
| 铝型材 3030 | 欧标，黑色氧化 | 若干 | 待购 |
| 手拧螺栓 | 胶头螺母，快拆 | 若干 | 待购 |
| 拉铆螺母 | 预埋固定 | 若干 | 待购 |
| 防腐木/柚木垫板 | 2-3cm 厚 | 若干 | 待购 |
| 淋浴帐篷/浴帘 | 防水 | 1 | 待购 |
| 钢琴合页 | 外翻操作台 | 2 | 待购 |
| 折叠支撑架 | 户外操作台支撑 | 2 | 待购 |
| 淋浴软管 | 2.5-3.5 米 | 1 | 待购 |
| U 型存水弯 | 下水防臭 | 1 | 待购 |
| 聚氨酯密封胶 | 防水 | 1 | 待购 |

> 详细规格与购买链接请补充到"备注"列。
