shakeyo/MY-VAN/modules/10-smart-control/media/bom.md

# 材料清单：监控与音响

| 名称 | 规格/型号 | 数量 | 用途 | 状态 |
|---|---|---|---|---|
| DVR 编码器 | AHD → RTSP | 1 | 摄像头数字化 | 待购 |
| AHD 摄像头 | 1080P | 4 | 四路监控 | 待购 |
| Alpine R600 DSP | 8路功放 | 1 | 音响核心 | 待购 |
| Alpine DM65C | 两分频套装 | 1 | 前声场 | 待购 |
| Alpine DM65 | 同轴 | 1 | 后声场 | 待购 |
| Alpine PWE-S800 | 8寸超薄有源低音炮 | 1 | 低音 | 待购 |
