shakeyo/MY-VAN/modules/10-smart-control/n100-ha/bom.md

# 材料清单：N100 中枢与网络

| 名称 | 规格/型号 | 数量 | 用途 | 状态 |
|---|---|---|---|---|
| N100 迷你主机 | 16G RAM / 512G SSD | 1 | HA Core + Frigate + Dashboard | 待购 |
| GL.iNet/Cudy 路由器 | MT3000 / WR3000，4G/5G CPE | 1 | 车内局域网 + 上网 | 待购 |
| 安卓大屏 | 10-13寸，方易通 7862 方案 | 1 | 生活区中控屏 | 待购 |
