shakeyo/MY-VAN/docs/budget.xlsx

分类 | 物品名 | 单价 | 数量 | 购买渠道 | 重要性 | 已采购 | 备注
工具 | 大有电圆锯 | 500 | 1 |  | 1
 | 东成曲线锯 | 190 | 1 |  | 1 |  | 二手
 | 大有砂光机 | 500 | 1 |  | 1
 | 美工刀、批头加长
基础材料 | 木方龙骨
 | 挤塑板
 | 止震板
 | 胶合板（副地板）
 | 隔音棉
 | 9mm海洋板 | 300/张 | 7
 | 木蜡油
 | 木头封闭底漆
 | 羊毛
 | spc地板 | 50/平
 | 防锈底漆
 | 强力清洁剂、除油剂
 | 金属漆
 | 3M喷胶（保温棉固定）
 | 铝型材
 | 阳光板（柜体间隔）
 | 防爆漆（轮胎、翼子板、保险杠）
 | 地板结构胶+胶枪
 | 铝箔胶带（密封副地板）
车体 | 二排奔驰威霆或GL8双人椅（要带isofix） | 500~700
 | 副驾改子母椅旋转套件
 | 主驾GL8
 | 后排单人折叠收纳椅
 | 房车推拉侧窗
 | 通风设备
 | 行车记录仪，360度影像
 | 车顶行李架+爬梯
 | 自行车挂架
 | 吊包
 | 旋转桌
 | 隐私膜
 | 音响系统
 | 投影幕布
 | 金属洞洞板
电力系统 | 太能阳板600w
 | MPPT控制器
 | 行车发电器
 | 磷酸铁锂电池
 | 逆变器3000w起
 | 交流断路器
 | 空气开关
 | 电线
 | 剥线钳
 | 空调
 | 冰箱
水路系统 | 净水箱
 | 灰水箱
 | 水泵
 | PEX水管
 | 水槽，水龙头，花洒
 | 便携马桶
