shakeyo/MY-VAN/relay-box/step/relay_box_assembly.step

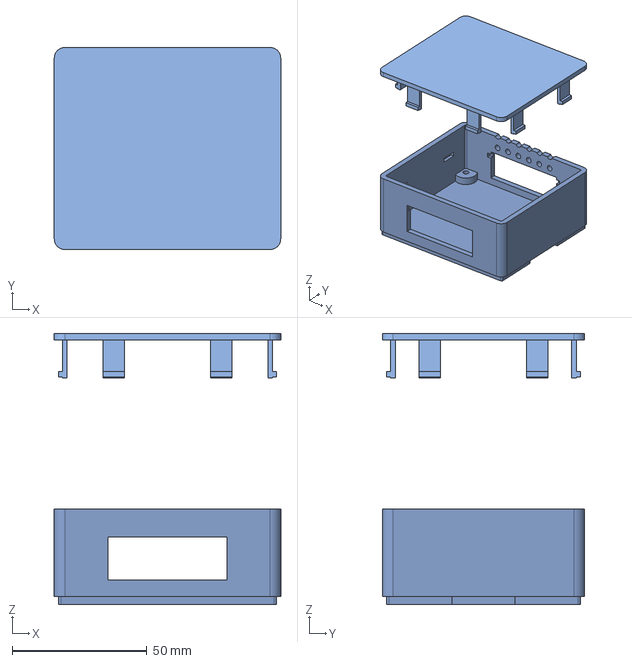
[picture p105: CAD file, 2026-10-28]
relay-box/step/relay_box_assembly.step
84.0 x 75.0 x 100.5 mm
box_body
lid
