shakeyo/MY-VAN/modules/04-power-system/3dmodels/relay-box/relay_box.3mf

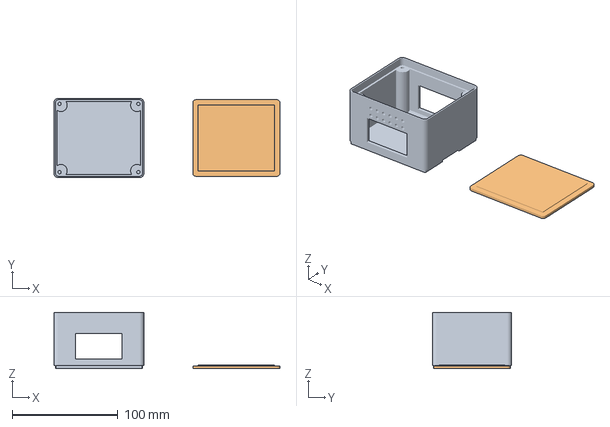
[picture p106: CAD file, 2026-11-05]
modules/04-power-system/3dmodels/relay-box/relay_box.3mf
213.8 x 75.0 x 53.0 mm
lid
