shakeyo/MY-VAN/modules/04-power-system/3dmodels/relay-box/step/relay_box_lid.step

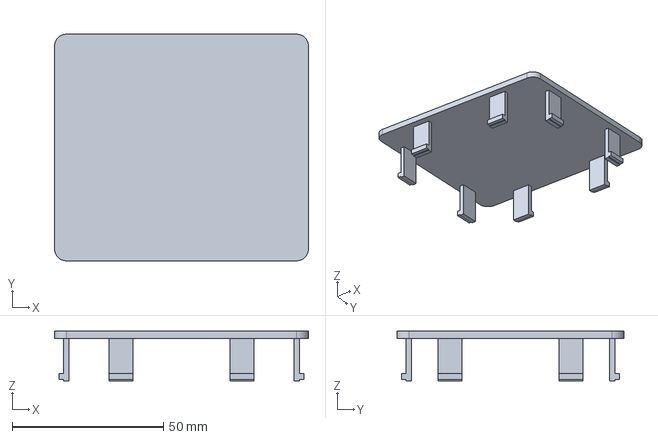
[picture p107: CAD file, 2026-11-05]
modules/04-power-system/3dmodels/relay-box/step/relay_box_lid.step
84.0 x 75.0 x 16.5 mm
