shakeyo/MY-VAN/modules/10-smart-control/n100-ha/step/tray-tablet-8in-hook.step

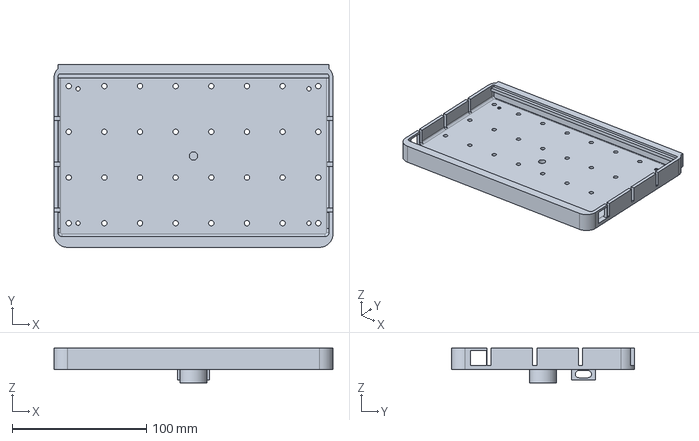
[picture p108: CAD file, 2026-10-13]
modules/10-smart-control/n100-ha/step/tray-tablet-8in-hook.step
208.2 x 136.3 x 25.9 mm
