shakeyo/MY-VAN/modules/10-smart-control/n100-ha/stl/dummy-gauge-thickness.stl

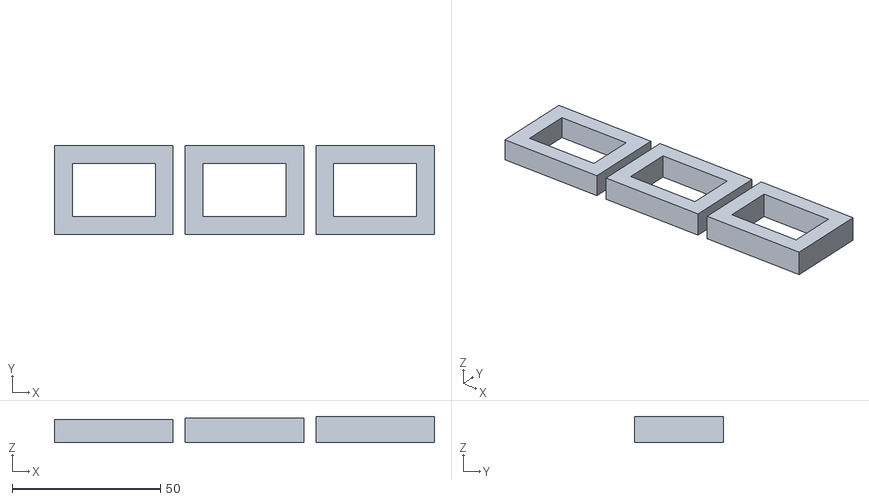
[picture p109: CAD file, 2026-10-13]
modules/10-smart-control/n100-ha/stl/dummy-gauge-thickness.stl
128.0 x 30.0 x 8.90
