shakeyo/MY-VAN/relay-box/stl_from_step/relay_box_body.stl

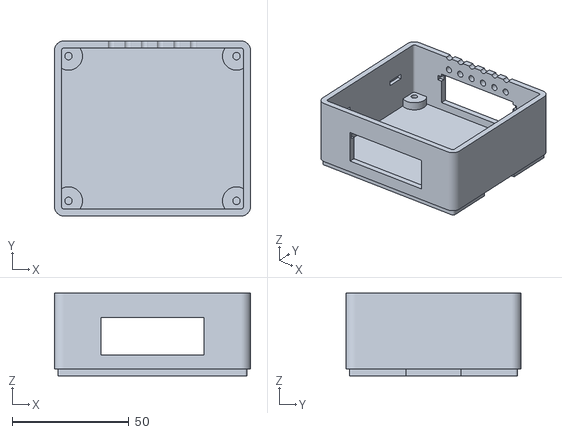
[picture p110: CAD file, 2026-10-28]
relay-box/stl_from_step/relay_box_body.stl
84.0 x 75.0 x 35.5
