shakeyo/MY-VAN/modules/10-smart-control/n100-ha/step/base-wedge-22deg.step

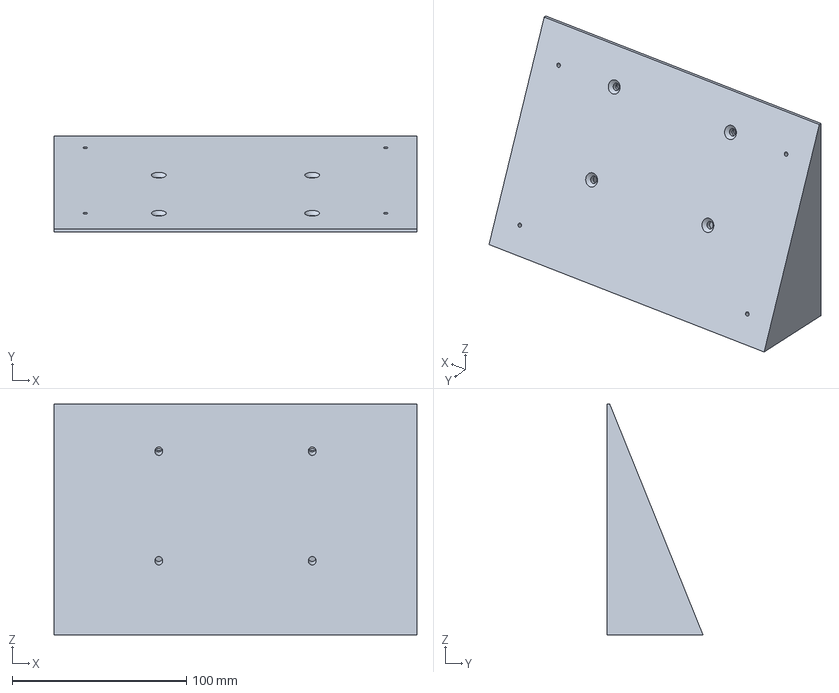
[picture p111: CAD file, 2026-10-13]
modules/10-smart-control/n100-ha/step/base-wedge-22deg.step
208.2 x 55.1 x 132.3 mm
