shakeyo/MY-VAN/modules/10-smart-control/n100-ha/step/dummy-tablet-hollow.step

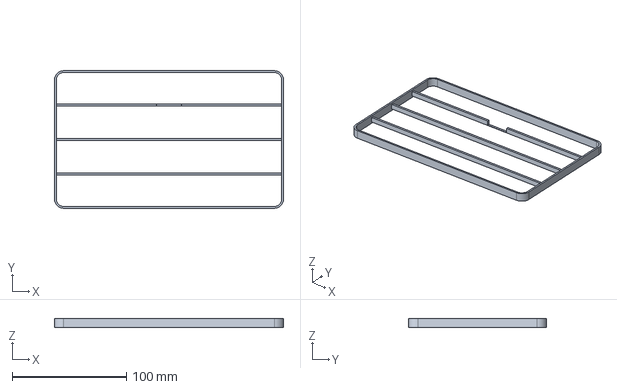
[picture p112: CAD file, 2026-10-13]
modules/10-smart-control/n100-ha/step/dummy-tablet-hollow.step
200.2 x 120.3 x 7.90 mm
