shakeyo/MY-VAN/modules/10-smart-control/n100-ha/step/tray-tablet-8in.step

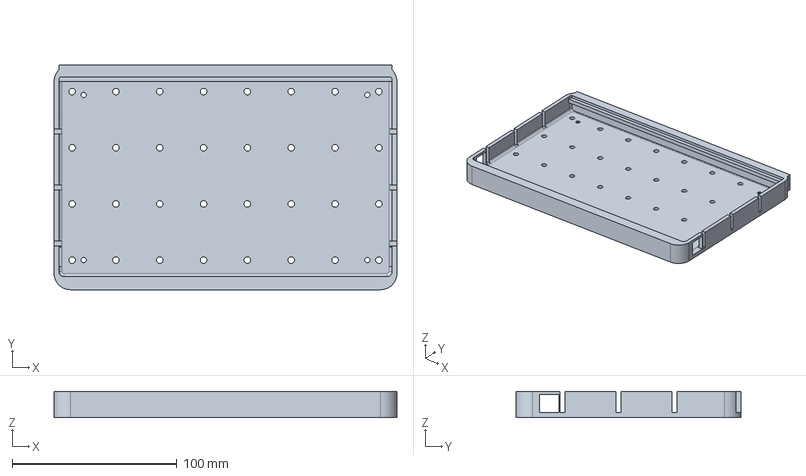
[picture p113: CAD file, 2026-10-13]
modules/10-smart-control/n100-ha/step/tray-tablet-8in.step
208.2 x 136.3 x 15.9 mm
