shakeyo/MY-VAN/modules/10-smart-control/n100-ha/step/base-ball-quarter.step

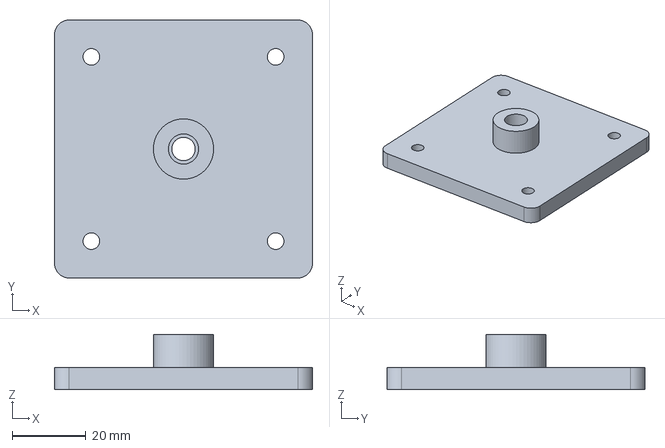
[picture p114: CAD file, 2026-10-13]
modules/10-smart-control/n100-ha/step/base-ball-quarter.step
70.0 x 70.0 x 15.0 mm
