shakeyo/MY-VAN/modules/10-smart-control/n100-ha/step/base-wedge-20deg.step

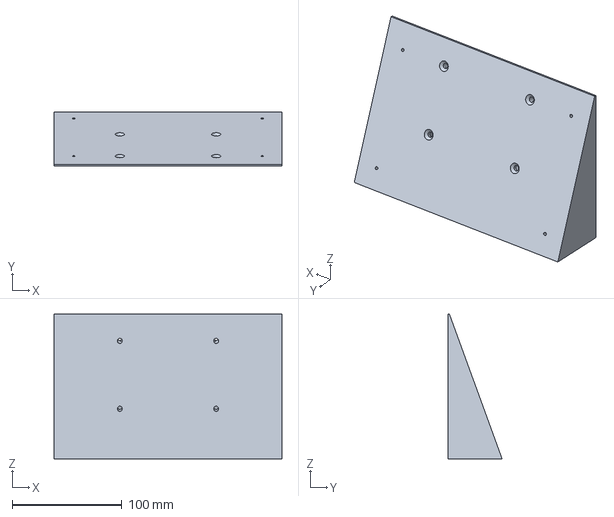
[picture p116: CAD file, 2026-10-13]
modules/10-smart-control/n100-ha/step/base-wedge-20deg.step
208.2 x 49.6 x 132.3 mm
