shakeyo/MY-VAN/(list of files, cad)

Other CAD files:
modules/04-power-system/3dmodels/relay-box/stl_from_step/relay_box_lid.stl
relay-box/step/relay_box_body.step
modules/04-power-system/3dmodels/relay-box/stl/relay_box_lid.stl
modules/10-smart-control/n100-ha/stl/base-ball-quarter.stl
modules/10-smart-control/n100-ha/stl/base-wedge-20deg.stl
modules/10-smart-control/n100-ha/stl/base-wedge-22deg.stl
modules/10-smart-control/n100-ha/stl/dummy-tablet-hollow.stl
modules/10-smart-control/n100-ha/stl/dummy-tablet-solid.stl
modules/10-smart-control/n100-ha/stl/tray-tablet-8in-hook.stl
modules/10-smart-control/n100-ha/stl/tray-tablet-8in.stl
relay-box/stl/relay_box_body.stl
