shakeyo/MY-VAN/modules/01-vehicle-layout/build-flooring.md

# 地板与保温隔热

## 地板施工

- [x] 防锈基础：喷铁锈转化剂、环氧底漆、水性金属漆
- [x] 龙骨设计：主龙骨固定原车孔，副龙骨找平 (1cm 木方 + 止震板)
- [x] 保温铺设：条贴止震板、2cm XPS 挤塑板、填缝发泡胶
- [x] 面层安装：9mm 海洋板副地板、SPC 石塑地板

## 两侧与吊顶

- [x] 三明治结构：止震板 + XPS 保温 (双面铝箔) + 聚酯棉 + 温莎吸音棉 + 饰面板
- [x] 吊顶方案：原车吊顶清洗、[ ] 翻毛皮包覆、[ ] 吊包导轨安装
