shakeyo/MY-VAN/modules/01-vehicle-layout/build-windows.md

# 车窗遮阳帘

## 方案

磁吸铝箔气泡膜方案：

- **外层**: 铝箔气泡膜
- **中层**: 钕铁硼强磁
- **内层**: 毛毡板
- **工艺**: 裁剪比窗框大 1–2cm，磁吸固定于车窗金属框
