shakeyo/MY-VAN/modules/00-chassis/build-chassis.md

# 底盘与车外施工

## 底盘整备

- [x] 全车防锈、钣金修复
- [x] 车底喷涂装甲漆

## 车外施工

- [x] 车顶锈穿处理：打磨、铁锈转化、环氧底漆、钣金胶补洞
- 全车喷漆：方案推荐白色 (70%) + 其他对比色 (30%)

## 车顶

- 太阳能/行李架详见 [02-external](../02-external/)
