shakeyo/MY-VAN/modules/04-power-system/3dmodels/relay-box/renders/6_step_assembly.png

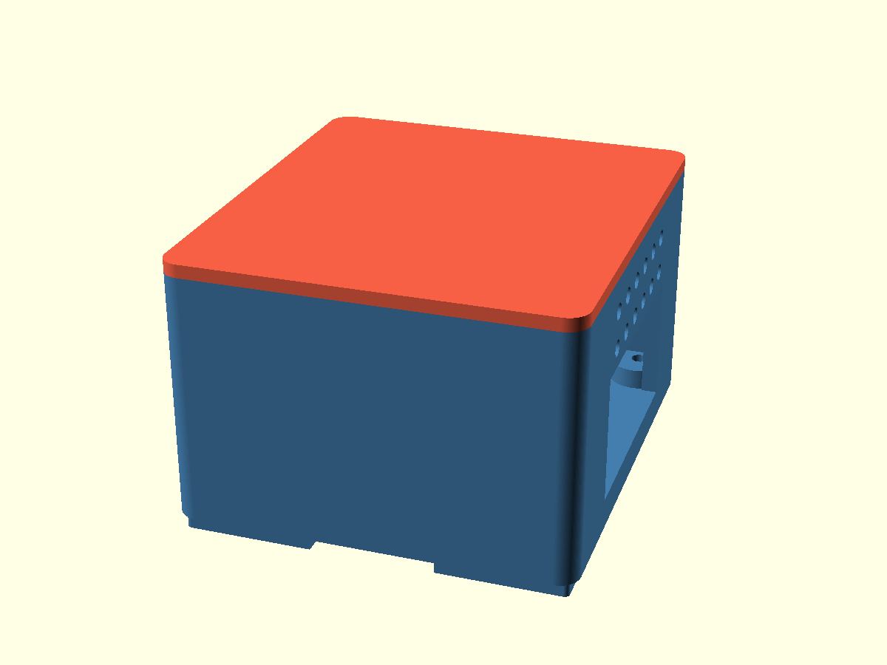
modules/04-power-system/3dmodels/relay-box/renders/6_step_assembly.png
