shakeyo/MY-VAN/modules/04-power-system/3dmodels/relay-box/renders/6_step_exploded.png

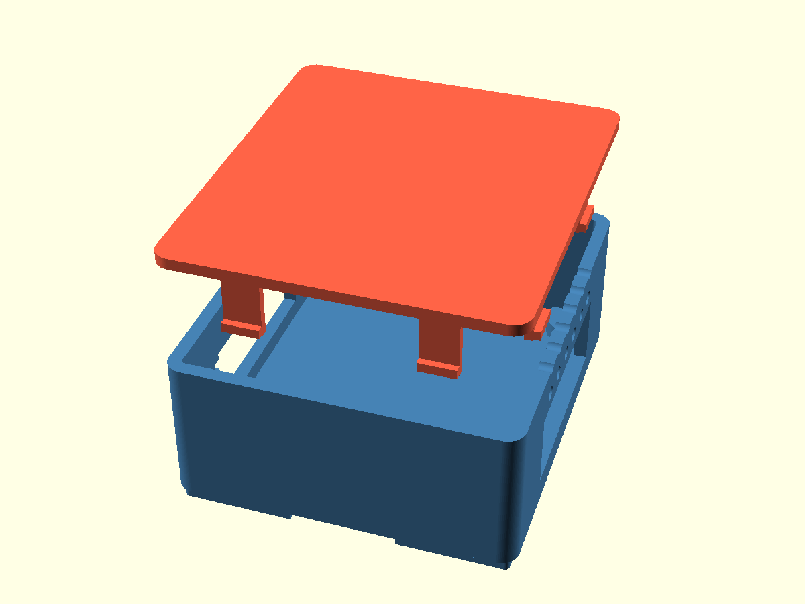
modules/04-power-system/3dmodels/relay-box/renders/6_step_exploded.png
