shakeyo/MY-VAN/relay-box/renders/1_assembly.png

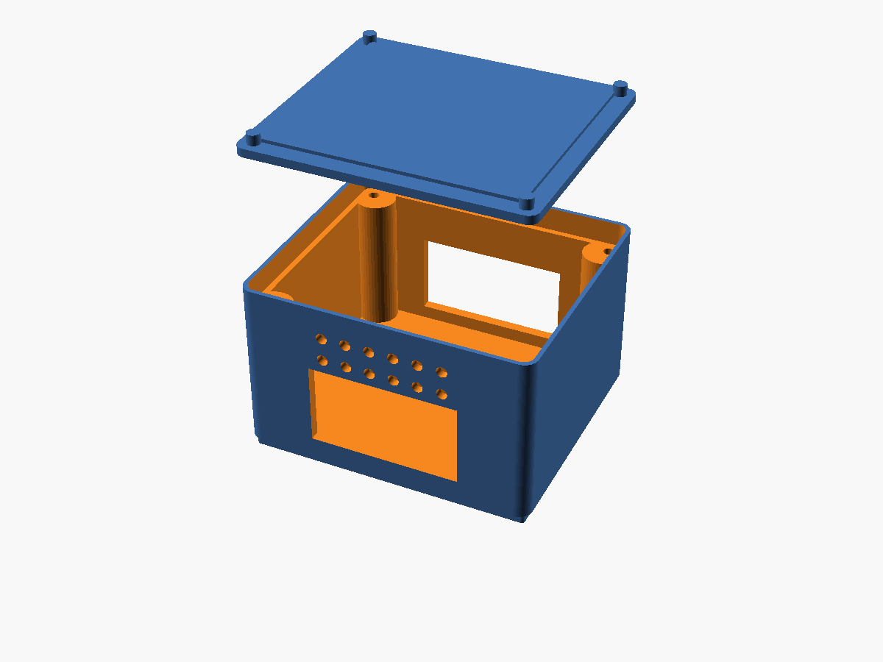
relay-box/renders/1_assembly.png
