shakeyo/MY-VAN/relay-box/renders/5_step_assembly.png

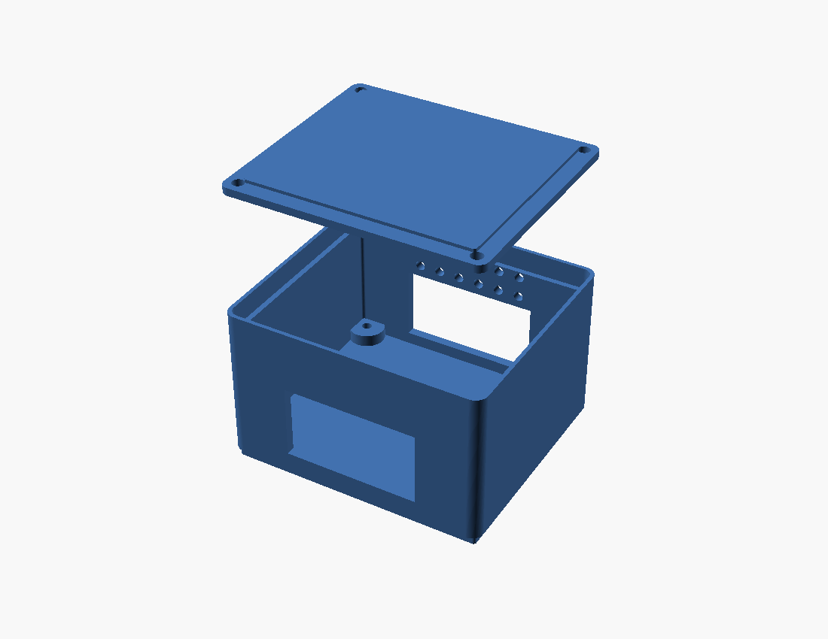
relay-box/renders/5_step_assembly.png
