shakeyo/MY-VAN/relay-box/renders/6_step_body.png

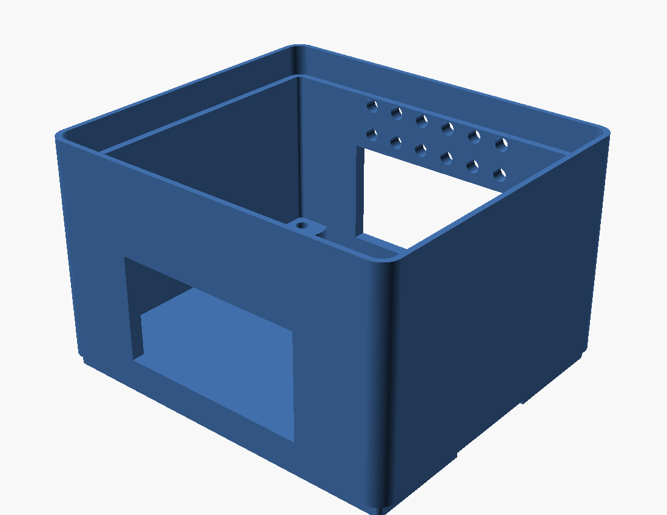
relay-box/renders/6_step_body.png
