shakeyo/MY-VAN/modules/04-power-system/attachments/库仑计-TF03k通信协议.pdf

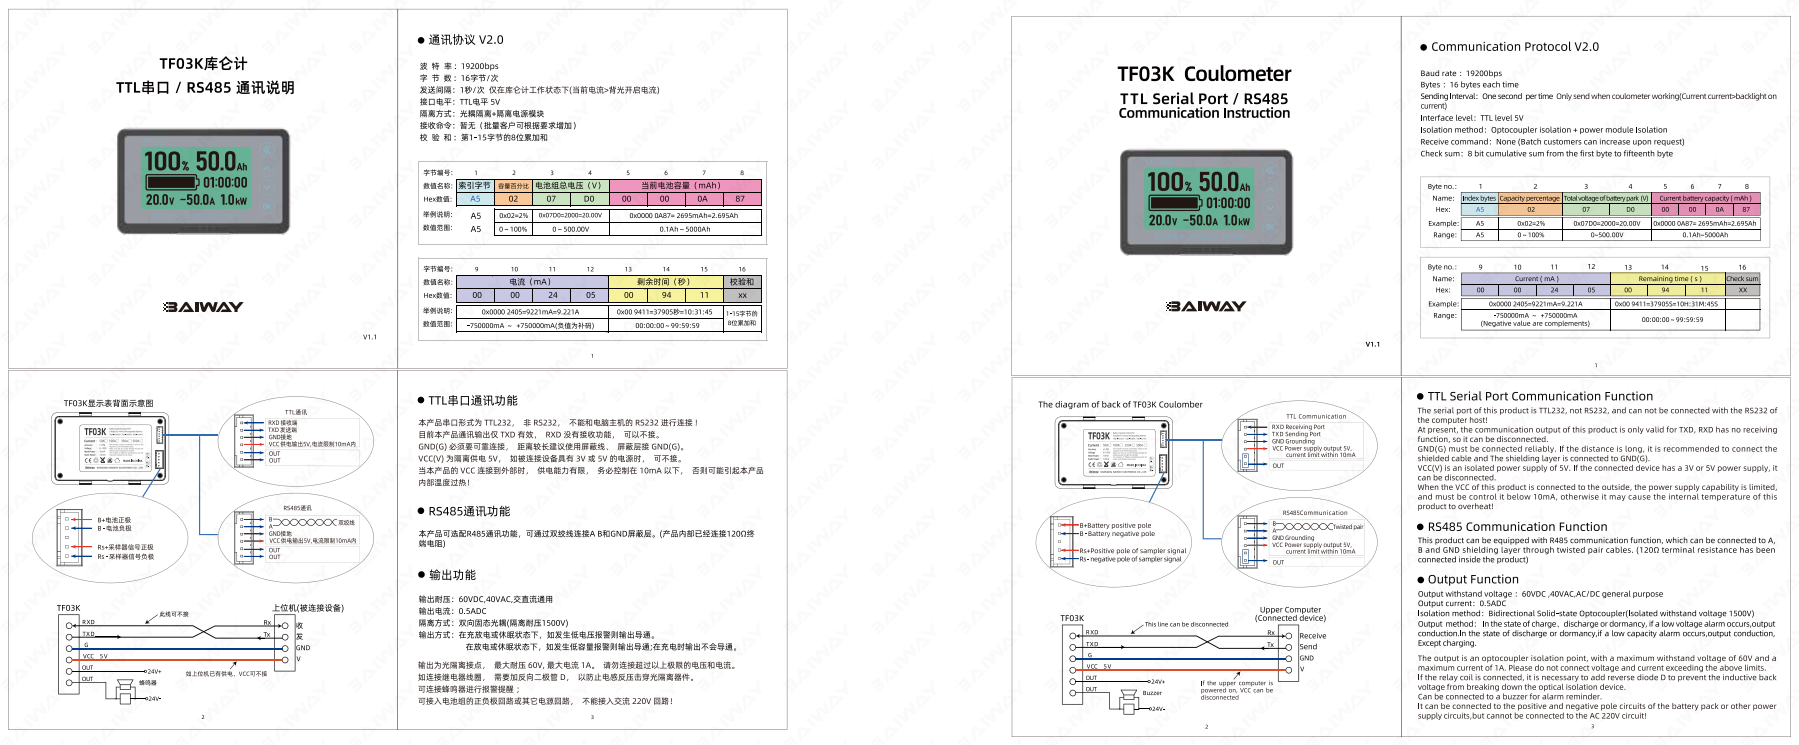
[picture p122: page 1]
