shakeyo/MY-VAN/(commit log)

2026-07-31 MY-VAN：AI 驱动的全栈开源房车
    模块化 · 智能化 · 轻量化 · AI 驱动 — 一套可拆检、可恢复、可迭代的开源房车改装方案。
    12 个功能模块，覆盖底盘到影音，按施工顺序组织。
2026-07-31 修复 Vite 构建：添加 assetsInclude 支持大写图片后缀
2026-08-06 重构中门配电箱设计：合并走线方案，新增面板开关分配文档
    - 将中门配电线走线整合到 design-distribution-box.md（物理布局、端子排分组、施工步骤、安全检查清单）
    - 新增 switch-assignment.md：三块面板（驾驶室/入口/主控）的按键、LED、继电器通道完整分配
    - 拓扑简化：中门从 继电器+IO 双模块 合并为单个 16 路 485 模块
    - 新增 485 IO 模块参考手册
2026-08-08 重构面板开关分配：8+4 模块拓扑，倒车灯/户外灯归属调整，12 芯线色定义
    - 16 路模块改为 8 路(箱内) + 4 路(柜内) 分开放置，解决配电箱空间问题
    - 8 路扛所有功率回路 + 入口面板 DI + 主控面板键 1-4
    - 4 路仅跑信号：场景 LED + 主控面板键 5-6 + 跨模块 LED
    - 倒车灯从额头移到中门（走线靠近中门柜），户外侧灯移到额头
    - 睡眠灯与氛围灯合并到同一继电器 R2，端子排出线后 WAGO 分接
    - 排气扇改为场景模式（循环切各窗风扇组合），R3 空载驱动 LED
    - 新增 12 芯线色定义（12芯A/12芯B/细线束C）和跨接线汇总
    - 端子排更新：点烟器直连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
2026-08-08 简化控制方案：砍掉 LED 同步和 4 路模块，预留扩展口
    - 当前只上 8 路模块，不上 4 路、不接 LED、不上 HA
    - ESPhome 本地跑自动化（场景循环、双控、离车模式）
    - 12 芯线 LED 芯全部预留到端子排，后期插端子即用
    - 4 路模块 485/电源在控制区预留端子，后期零拆改
    - R3 空闲（原 LED DO），7/8 路使用
    - 电控水阀确认为常闭型 12V 球阀（通电开/断电关）
    - 端子排更新：2 路点烟器、氛围灯 5-8 位并联出线
2026-08-08 新增车尾模块，保险合并，倒车灯纯手动控制
    - 新购车尾 4 路模块 + 4 路 blade 保险盒（倒车灯/户外灯/点烟器）
    - 倒车灯从倒挡联动改为纯手动按钮，迁到车尾.R1
    - 中门 8 路释放 R5（倒车灯迁出），6/8 路使用，R3/R5 空闲
    - 12V 保险合并为 6 路：灯全合 F12-2，电控水阀进控制级 F12-1
    - 后窗排气扇确认为 4 小风扇低功率，独立 F12-3
    - 控制区端子改橙色，三区（蓝正/灰负/橙控）加隔板
2026-08-13 14芯线缆 + 主控LED + 中门4路预接线 + 箱内走线整理
    - 12芯改14芯，入口面板6P+5P分体、主控14P
    - 主控面板4键LED接入：硬件同步OUTx，场景键R3做DO
    - 中门4路模块升级为已接线未通电状态
    - 修正负载接线：继电器切正极，NPN仅驱动LED
    - 新增箱内走线整理章节
2026-08-15 面板接线定稿：8P短跳线、14芯实际线色、预留芯插中间、模块供电并线
2026-08-16 485 网关按键改主动上传驱动，esp32-485 重构为 gateway
    - 按键零轮询：模块 0031H=1 主动上传 + 100ms 缓冲解析（CRC 校验），消除轮询漏检与总线竞争；test-mid8-logic 阶段3 全逻辑实测通过
    - 中8/中4 帧地址修正为 2/3 并重算 CRC（原误用 0x01，上车会误打到额头模块）
    - prod / test-channel-mapping 统一新架构；build-guide 更新 DI 双向光耦触发、FC04 输入寄存器、上传帧格式
    - 面板键6 三色改双色（红/绿/橙 3 场景），中4.R4 预留；新增模块手册 PDF 存档
2026-08-17 智能控制重构：energy 模块、MPPT 485 协议规划、HA 角色边界
    - 新增 energy/：MPPT 485 协议速查与功能规划（监控/充电控制/限流/待机断电/低温禁充）+ PZEM-017 占位
    - 新增 media/：监控与音响（原 site 未跟踪内容移入源码，避免同步丢失）
    - HA 角色定稿：安全关键自动化留 ESPHome，HA 做 Dashboard/远程/通知/历史
    - 额头通道表：R5 LED DO、R6 MPPT 接触器；sensors 电量计移入 energy
    - 归档厂家协议手册 MPTT.pdf；site 同步脚本改 rsync 排除 .esphome
    - wifi 多网络配置 + AP 改名；删除旧 gateway/esphome.yaml（由 esphome/ 目录取代）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
2026-08-17 修复 site 同步：嵌套子模块 README 未改名 index 导致 404
    prebuild 只处理顶层模块目录，energy/、media/ 的 README.md 构建成
    README.html，目录 URL 404。改用 find 递归改名。
2026-08-17 补 gateway/sensors/n100-ha 子模块 README 作为目录首页
    三个子模块无 README，构建无 index.html，目录链接 404。
2026-08-17 新增 robot/ 子模块与小米平板4 移动中控板方案
    - robot/：中控台 DIY 表情机器人，N100 大脑 + ESP32 身体桥，
    HA Assist 语音管线，表情/动作反馈全车状态（架构定稿，选型待办）
    - n100-ha/tablet.md：小米平板4 拆电池直供电 + 快拆支架，
    副驾驶监控中控、后床旁移动使用
    - 交互入口改为四端（手机/平板/车机/机器人）；语音控制待定项定稿
2026-08-17 网关硬件焊接方案改扩展底板+485小副板
    S3 插扩展底板（自带 12V→5V/3.3V 降压+排母），MAX3485+3P 端子
    焊在小副板上，5 根短导线硬连；稳压模块/S3 排母从 BOM 划掉。
    新增 gateway-wiring.svg 接线图，旧 perfboard-layout.svg 标废弃。
2026-08-18 switch-assignment:补模块丝印对照、双控LED汇接说明与端子排预制施工顺序
    新增 3 处说明：X/Y↔DI/R 模块丝印对照（COM 进电/NO 出线）、
    双控泵 LED（芯11粉+芯12橙）在端子排汇接后进 OUT6、
    「在家预制、车里只接端子排」施工流程。
2026-08-19 n100-ha 补必装软件清单；修复 esphome 目录 404
    - 软件清单：HAOS/Tailscale/Mosquitto/ESPHome/System Monitor/Companion/Fully Kiosk
    - 远程访问定稿 Tailscale、通知定稿 Companion 推送
    - 核心服务更新为 HAOS（虚拟机）+ add-on
    - gateway/esphome 补 README 目录页，修 README 死链
2026-08-25 电路以及智能化细节完善
2026-09-07 docs: Notion↔git 镜像与 TODO 回写同步手册
2026-09-07 docs: notion 回写流程如实标注 read_page 不含 checked,改用户指示驱动
2026-09-07 docs: Notion 模块镜像铺开清单(源→子页映射与标准模板)
2026-09-07 docs: 记录 10-smart-control 模块已镜像(顶层 build-guide)
2026-09-07 docs: 记录 01-vehicle-layout 已镜像(布局/地板/框架/窗)
2026-09-07 docs: 全 12 模块镜像铺开完成(00-11 均建 Notion 子页)，同步清单与映射
2026-09-07 docs: 04 Notion 页按架构定稿重建并归档旧页,更新页id映射
2026-09-09 refactor(power-system): 接线改中门柜汇总方案（DI主干+面板复合线，替代4线方案）
2026-10-30 docs(energy): 库仑计由 PZEM-017 更正为 TF03K
    实测到货为 TF03K（非 PZEM-017），两者协议完全不同，故全仓统一更正：
    - 文档重命名 energy/pzem-017.md → energy/coulomb-tf03k.md
    - 全仓引用同步（README / build-guide / design / sensors / n100-ha / modbus.yaml）
    - 修正地址占用表：删除 "PZEM=0x11"，注明 TF03K 走独立 19200 UART、不在 485 总线
    - HA modbus.yaml 补注：TF03K 非 Modbus 从站（私有主动上报），无法用 modbus 平台读取
    无功能改动，纯命名与事实修正。
2026-10-30 feat(panel): 面板重构 + 充电趋势 + 能源系统占位；固件 X4 恢复 act_camp
    ## 固件
    - relay-mid-8ch: 中8.DI4 回退临时测试版（X4 直切主灯）→ 恢复
    `script.execute: act_camp`（离车/驻车场景键）。已 OTA 刷入并重启验证。
    - mppt.yaml: 新增充电趋势环形缓冲（MPPT 本身无历史数据）
    · 每 5 分钟采样功率，std::array<uint16_t,288> = 24h / 576B
    · 编码 "v1:count:idx:base64" 经 text_sensor 推送，SSE 负载约 0.75KB
    · 按时间正序输出（环形回绕已处理），面板可直接绘制
    · ⚠ 用 std::array 而非 std::vector：后者的 initial_value 会让
    GlobalsComponent 构造函数产生重载歧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
2026-11-02 fix(panel): 中文字体改用苹方中黑，修正字重与抗锯齿
    像素字体（Pixelify/Silkscreen）没有中文字形，中文一直回落到系统默认
    的苹方 400，且全局开了 -webkit-font-smoothing:antialiased，
    导致中文笔画发虚偏细，与旁边锐利的点阵数字反差过大。
    - 新增 --cjk 字体栈：苹方 → HarmonyOS Sans → MiSans → Noto/Source Han
    → 冬青黑 → 微软雅黑 → 黑体，覆盖 macOS/iOS/Windows/HarmonyOS
    - 字重生效：此前 --font-body 只声明 400，中文拿不到中黑
    - 抗锯齿改回 auto：antialiased 会削细中日韩字形
    - 开关格标签 500 + 字距 .3px，区块标题 600
    验证：5 页切换正常、22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
2026-11-03 fix(panel): 去掉卡片默认渐变，制热态渐变改为专用 token
    把设计稿 .mode.heating.on 的"制热态专属"微渐变误当成了所有卡片的
    默认底色，后果有三：
    1. 语义错误——那层 rgba(43,43,43,.05) 是配在白色卡片 + 深色边框
    的制热状态上的特殊处理，普通卡片不该有
    2. 浅底上过重——页面背景是 #EDEDEB 灰底，白卡上再压 5% 灰，
    顶部直接掉一个色阶，看着像蒙了脏东西
    3. 深色皮肤反向——用 color-mix(--c-text 5%) 派生，而深色皮肤
    --c-text 是浅色，渐变会变成发亮白蒙层，方向完全反了
    改为：
    - 常态 background-image: none
    - 新增 --veil-heat / -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
2026-11-03 feat(panel): 重做 sand 皮肤，新增 neon 未来感主题
    sand 整体"看着难受"的根因是层次没拉开：
    旧版 page #EAE0D2 与 card #FBF6EC 都是米黄，明度差仅约 8%，
    大块同色平铺导致画面发闷；且强调色 #B4562A 偏赭红土气，
    与用户车漆那种"淡淡的黄"完全不是一回事。
    sand 重做：
    - 页面淡黄 #F4EEDF + 卡片纯白 #FFFFFF，拉开层次
    - 文字改暖中性灰 #2B2820/#6E6656，去掉深褐的土气
    - 强调色压深到 #B07C1A，保证白底可读
    - 圆角 22px → 20px，视觉更整
    新增 neon：
    - 深空底 #070B11 + 卡片 #111823，HUD 而非普通深色主题
    - 电光青 #22D3EE 做 accent，激活态青色发光
    -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
2026-11-03 feat(panel): 每套皮肤独立底纹与数值字体
    两个问题：
    1. 所有皮肤都是单色平涂大背景，看着单调
    2. 像素数字不适合所有风格——此前只有 terminal 换了字体，
    其余 5 套都用同一套像素数字
    新增 token：
    - --bg-texture / --bg-texture-size：页面底纹，默认 none
    - --font-num-weight / --font-num-spacing：数值字重与字距
    各皮肤分配：
    - paper 极淡网点纸（14px）+ 像素字，点阵是这个主题的本体
    - night 顶部冷光 + 22px 细网格 + 系统等宽 500
    （深底上像素字会发光晕开，可读性差）
    - terminal CRT 扫描线 + 系统等宽
    - contrast 无底纹（对比度优先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
2026-11-03 fix(panel): 重建字号阶梯，图标不再压过文字
    问题：格子图标 26px 对标签文字 12px（2.2 倍），文字沦为陪衬；
    且全站 18 处文字挤在 9~15px 的窄区间，层级几乎无差别，整体死板。
    字号阶梯重建为四级，刻意拉开：
    L1 显示 --fs-num 24px 环形仪表数字
    L2 标题 --fs-sec 15px 区块标题
    --fs-val 15px 数值
    --fs-clock 16px 时钟
    L3 正文 --fs-body 13px 格子标签/正文（原 12px）
    L4 辅助 --fs-label 10.5px / --fs-nav 11px
    图标与文字比例：
    - --icon-size 26px → 22px，对 13px 文字约 1.7 倍，主次清楚
    零碎小字一并上提：
    - hint-txt / cell 编号 9px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
2026-11-03 feat(panel): 平板/横屏响应式版式，格子改横向排版
    问题：面板一直没有响应式规则，只有 430px 单一版式。iPad 横屏(1024x768)
    下格子被拉成 327x60 的窄条，图标/文字/圆点仍竖着堆在正中，
    左右大片空白浪费——横屏时左右空间远大于上下空间，竖排结构不合理。
    三档断点：
    - <600px 手机竖屏：3 列竖排（不变）
    - >=600px 平板竖放/大手机横放：4 列，格子接近正方形
    - >=820px 平板横放：
    · 开关格改横向「图标 → 文字 → 状态点」，min-height 64px
    · 情景卡横排，图标左文字中状态右
    · 能源卡：仪表 120px 在左，指标 3 列在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
2026-11-03 feat(panel): 调试并入设置页，日志改为可折叠
    「调试」独立占一个底部 tab 太浪费——它是排障用的低频功能。
    - 移除 debug 页与导航 tab（5 → 4：首页/开关/电池/设置）
    - 实时日志并入设置页末尾，默认**折叠**，标题行即开关
    （aria-expanded + 旋转箭头），展开状态存 localStorage
    - 「打开时自动滚动到底」从"面板偏好"移进日志面板内部：
    日志收起时这个开关毫无意义，放在外面是位置错误
    实现细节：
    - setLogOpen(open,persist) 区分「用户点击」与「初始化恢复」，
    只有前者写 localStorage，避免把默认值固化成用户选择
    - 日志区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
2026-11-05 polish(panel): 对比度达标 + 尺度收敛 + 三处布局溢出修复
    用户反馈"还是不够好看"。改做可量化审计而非凭感觉调样式，
    审计结果指向四个具体缺陷：
    1) 次要文字严重不可读（最影响观感）
    --c-text-3 管着全部辅助小字，6 套皮肤里 5 套不过 WCAG AA：
    paper 2.35:1 / sand 2.47:1 / neon 2.84:1 / terminal 3.45:1 / night 3.62:1
    —— 这就是"发闷、像蒙了层灰"的量化原因。
    修正时踩到陷阱：只提 text-3 会比 text-2 还深、层级反转，
    必须整条灰阶一起上移（text-2 ≥6.5:1，text-3 落在 ≥4.6:1 地板）。
    另修 --c-warn 当文字用不达标（paper 4.10 / sand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
2026-11-05 feat(panel): 点阵中文 + 精简到 4 套皮肤 + 背景动效
    四个反馈：中文不是点阵 / 绿主题刺眼 / 黄主题与 paper 重复 /
    深色与未来感雷同 / 整体缺动感。
    1) 点阵中文（paper）
    之前只有数字和字母是像素字，中文是苹方，"点阵"只成立一半。
    嵌入 Fusion Pixel Font 12px（OFL-1.1），按页面实际用到的 471 个字符
    子集化：全量 602KB → 17.6KB。页面 gzip 44.2 → 62.7KB。
    - paper 把 --fs-body/--fs-sm 覆盖成 12px（点阵字形按 12px 网格设计，
    13px 处会发虚）
    - 不设 unicode-range：子集里没有 ASCII，靠字体栈顺序分流即可，
    硬写范围反而会把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
2026-11-05 feat(panel): 背景真正动起来（大面积漂移光斑 + 三档强度）
    上一版"动效"实测只有 0.25px/s（网点 56s 内漂 14px），等于没动。
    根因不是速度不够，是**位移尺度太小**：图案自身漂移只有十几像素，
    再怎么加快也看不出来。可见动感必须来自**几百像素级的大面积光斑横移**。
    1) .bg-fx 内部改成三层
    - 第 1 层 .bg-fx 底纹（网点/网格，自己的慢速漂移）
    - 第 2 层 ::before 两团大面积径向渐变光斑 ← 可见动感的主要来源
    - 第 3 层 ::after 扫描线等局部特效
    光斑单程 ±18%（390 屏约 260px），交替缓动，两端速度归零 →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
2026-11-05 feat(panel): 3D 视差背景 + 半透明卡片，深色皮肤同样有感
    上一版光斑在缝隙里动，但卡片一盖就看不见了。这版让光"透过"卡片流动，
    并用视差做出纵深。
    1) 三层视差（速度差 = 纵深）
    .bg-fx 远景纹理 26s/12s/13s
    ::before 中景大团柔光 ±18% 14s/16s/12s
    .l-near 近景更聚一团 ±26% 9s/11s/8s ← 比中景快 1.5 倍
    全部只动 transform，不触发布局。
    2) 半透明表面：光才能透上来
    新增 --surf-alpha（卡片/格子/情景卡）与 --surf-alpha-2（.stat 等凹槽）。
    paper 62%/48%，night·neon 55%/45%，contrast 保持 100% 不透。
    成立的前提是**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
2026-11-05 feat(panel): 背景改成"云层"，并撤掉规则网点
    三件事：动感还是弱、没有 3D 感、网点太粗。
    一、网点：规则点阵这条路走不通，撤掉
    用户的两次反馈互相矛盾，但合起来指向同一个结论：
    - 点小（0.9px/14px/7%）：远看只是灰雾 → 「太细了」
    - 点大（1.6px/22px/13%）：满屏密集小孔 → 「密集恐惧症」
    触发不适的是"规则 + 密集"这个组合本身，调参数解决不了。
    改成不规则低对比纸浆斑（4 团不同位置的 4.5–7% 径向渐变，300px 平铺）。
    "点阵"这一视觉语言只保留在**字体**上，背景点阵确认是负资产。
    验收判据可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
2026-11-05 fix(panel): 底纹改成无缝噪声颗粒，修掉"瓷砖铺贴"感
    用户说的"一块块瓷砖贴上去"，不是云层的问题，是纸纹在平铺：
    .bg-fx 只设了 background-size:300px，**没设 background-repeat**，
    默认 repeat → 同一组斑纹每 300px 原样重复一遍。
    顺带两个连带缺陷：
    - dotDrift 位移写 42px，不是 300px 整数倍，每 44s 循环时整体跳一下
    - 那组斑纹本身落差就有 13 级，等于背景上印着一张重复图案
    这类缺陷用"对比度"指标完全测不出来（斑纹只有 5–7%，看着很淡），
    必须测**空间频率**：
    原图 20×20 落差 颗粒 8–15 级 / 图案 也高（区分不了）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
2026-11-05 feat(panel): 背景改半调网点（不再闪）+ 首页能源卡删除、常驻状态条上线
    两个用户问题：背景"太闪"、第一行"有点空"。一并处理，并把上一轮讨论的
    布局结论落地（P1 背景 + P2 布局一起）。
    一、太闪：细网点不能平移
    上一版让两层网点整体平移（±20% 层宽、10–20s）。4px/6px 细网点以不同角度
    （15°/75°）滑动会产生摩尔纹爬行，看起来就是屏幕在闪。
    这条和"大幅平移才有动感"直接矛盾：网点越细可动幅度越小，细网点最多 ±3%。
    改成只动覆盖率：网点位置固定，整层 opacity 在 .42↔1 之间呼吸
    （远 20s / 近 12s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
2026-11-05 fix(panel): 删掉背景横向动效（"从左到右"的来源）+ 能源摘要并入顶栏
    二轮反馈：背景有"从左到右的效果、手机/Safari 上尤其明显"，以及"电池那栏能不能
    直接放到顶栏"。两个都做了。
    一、"从左到右"的真因：背景层在水平方向漂移
    上一版已经没有大幅位移，但背景里每个层都还在水平方向动：
    纸纹 dotDrift +180px、霓虹网格 gridDrift +60px、网点层 halDrift ±3%。
    这些是比视口大 12–75% 的固定层，Safari 按条带合成，横向位移被读成
    一道从左往右推进的亮/暗带。
    规则：背景层只允许 opacity 与 translateY 动画，永不改 X。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
2026-11-05 feat(panel): 补回背景动效 —— 纵向软光带（唯一同时满足四条禁令的做法）
    上一版把背景做成全静止，反馈是"是停止了，我还是需要背景动起来"。
    四代背景动效各自踩的坑：
    1 彩色光斑平移 → 色块
    2 云层 → 瓷砖/边界
    3 细网点平移 → 摩尔纹"太闪"
    4 静止 → 不动的
    这次用一条纵向软光带，逐条对上禁令：
    - 只有 4.5–5.5% 单色墨量（纸色用深墨、深色用浅墨）→ 是明暗不是颜色，不构成色块
    - 上下渐隐、左右贯通整屏，没有闭合轮廓 → 不会被读成"一块东西在移动"
    - 纯渐变层 + 合成位移，没有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
2026-11-05 fix(panel): 光带加强到看得见 + 顶栏在真机不再相压
    两个反馈：背景"看不出来、非常不明显"，手机上顶栏文字互相覆盖。
    一、光带加强（可见阈值约 10 级区域均值摆动）
    上一版墨量 4.5%、38s alternate，实测摆动只有 6 级，肉眼几乎看不出。
    这一版：
    - 墨量 4.5% → 10%（neon 9%）
    - 周期 38s → 24s，ease-in-out alternate → linear infinite
    - 高度 46vh → 40vh，行程 -40vh → 104vh（两端都在屏外，跳回起点不可见）
    - 新增 .bg-veil::after 第二条带，相位差半周期（负 delay）
    → 屏幕上永远至少有一条在走，不会出现"带子出屏、画面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
2026-11-05 fix(panel): 顶栏恢复两栏 + 背景改成看得见的纵向扫描带
    两个反馈：顶栏要恢复两栏；背景"还是没效果"。
    一、顶栏恢复分栏（顶栏 63 + 状态条 28）
    合并成一行虽然在桌面量得下，但真机上文字相压，用户选择「还是分 2 栏」。
    恢复 082f035 的两栏结构与样式（状态条：电量 / 净电流 / 剩余 / 时钟）。
    保留两处真机修复：iOS text-size-adjust 归一、≥700px 才显示发电与电池电压。
    窄屏（≤359）状态条去掉"剩余"二字并收窄进度条，保证仍是一行 28px。
    二、背景：软光带换成纵向扫描带（13% 墨、14vh、9s）
    诊断出错的地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
2026-11-05 feat(panel): 背景恢复"点阵云"（静态点阵 + 双层柔光纵向漂移）
    用户反馈：扫描带"有效果，但我不喜欢，还不如最前面的点阵云"。结论是
    动效首先得是用户认得的那个意象，其次才是强度——扫描带是"扫描仪"，
    点阵云才是这套设计的语言。
    一、恢复点阵云
    静态点阵底纹（14px 网屏、7% 墨、0.9px 点）+ 底下两层柔光缓慢漂移：
    远层 inset:-25% 慢/位移小，近层 inset:-45% 快/位移大 → 视差纵深。
    neon 保持静止网格 + 扫描线（网格带非周期性顶部渐隐，整体漂移会跳）。
    contrast 整层 display:none。
    二、所有位移改成纵向（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
2026-11-05 fix(panel): 深色皮肤去掉扫描线，改成网格线上移
    用户对深色的要求：「先改深色的背景吧，不要这个扫描的效果」。
    一、删除 neon 的扫描线
    `scanSweep`（6s 扫过全屏的亮线）整条移除，keyframes 一并删掉。
    二、深色动感改成"网格线整体上移"
    网格线单独成层（--bg-fx2 + --bg-fx2-size），上移一个完整周期
    （30px / 14s）后无缝回到起点：线条在动，但没有亮线扫过全屏。
    必须单独成层：底色里的顶部渐隐不是周期性的，跟网格一起漂移会在
    循环处跳一下。neon 底色改为纯静态顶部电光。
    三、柔光降为单层 6%
    深色的层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
2026-11-05 fix(panel): neon 线条调到看得见（13% 墨、5px/s、卡片 50% 透）
    用户选择：深色用"网格线整体缓慢上移"，且只改 neon（night 不动）。
    一、线条看得见的三处调整
    - 墨量 7% → 13%：深色底上 7% 的青线几乎不可见
    - 周期 14s → 6s（30px/6s = 5px/s）：慢但能看出在走
    - 卡片透明度 55% → 50%（--surf-alpha-2 45% → 42%）：
    卡片盖住约 85% 面积，线条只在缝隙里露一点是看不出来的，
    必须让它能透过卡片
    实测缝隙内帧差 1.53、>8 级像素 8.2%（早期定的"看得见"标准）。
    二、night 完全不动
    night 保持"安静夜色 + 双层柔光"（16%/13%/12%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
2026-11-05 feat(panel): neon 按钮不再透明 + 字体/图标适配科技主题
    用户反馈：按钮透明度太高；字体和图标是不是也要适配科技主题。
    一、交互面单独一档不透明度 --surf-alpha-btn
    卡片可以透（让背景动效透上来），按钮不能：按钮承载文字，透上来会把字糊掉。
    :root 默认 var(--surf-alpha)，neon 覆盖为 92%（原来跟随 50%）。
    应用到 .tile / .scene-btn / .skin-btn。
    neon 实测：按钮底 rgb(35,46,59) 上 t2 5.64、t3 4.71（均 ≥4.5）。
    踩坑记录：只加用法没在 :root 给默认值 → color-mix 整条声明失效 →
    格子背景全透明。这是第二次踩"新 token 没默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
2026-11-05 fix(panel): neon 按钮不透明度定在 74%（92% 太实、50% 糊字）
    反馈：92% 看着完全不透明、太死板。
    三档实测对比：
    50%（与卡片同）rgb(22,29,38) t2 6.95 / t3 5.80 网格线从按键透出来糊字
    92% rgb(35,46,59) t2 5.64 / t3 4.71 字清楚但像实心块
    74%（采用） rgb(30,39,51) t2 6.18 / t3 5.15 字清楚，背后仍有东西
    规律：交互面不透明度的下限由文字对比度决定（t3 ≥ 4.5），
    上限由"看起来有没有材料感"决定；74% 是两条约束的交点。
    验证：5 种尺寸 × 4 皮肤 × 4 页面零越界、零 JS 报错。
2026-11-05 feat(panel): neon 首页按钮去掉死板感（取景框角标 + 状态码 + 受光面）
    反馈：neon 首页按钮样式太死板。拆成三个独立原因，对应三处只加在 neon 上的改动：
    ① 形状完全均匀、没有结构线索 → 四角取景框角标
    8 个 1px 渐变画出的 L 形短线（左上 + 右下），未激活 30% 亮度、激活 100%。
    不增加任何填充，纯 HUD 语汇。
    ② 状态只靠描边颜色，余光里分不清开/关 → 右下角等宽状态码 ON / OFF
    9px、字距 1px、--font-num；激活时变主色。
    ③ 表面纯色平涂，像贴纸不像面板 → 顶部一条主色受光渐隐（9% → 46% 处结束）
    配套：
    - 状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
2026-11-05 feat(panel): neon 按钮加按下手感 + 角上读数（ON 3m / OFF）
    用户批准 A+B 两个方向，都只作用于 neon。
    A. 按下微动效（纯 CSS）
    角标瞬时全亮（transition-duration:0s，按下必须即时，渐变会被读成"卡"）
    + 图标 scale(.94) + 内描边压一层主色。
    B. 角上读数 "ON 3m" / "OFF"
    设备没有每个回路的功率，所以读数用"已开启时长"——真实可解释，
    比编一个假瓦数诚实。
    - 格子模板加真实元素 <span class="tv">（不能用 ::after，内容是动态的）
    - SINCE[k] 记录变 ON 的时间戳，updateTileReadouts() 每 10s 刷新
    - 格式 <60s → 30s、<60m → 12m、再往上 1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
2026-11-05 feat(panel): 新增第五款皮肤 ios6 —— 拟物化 / iOS 6 风格
    前四款皮肤都是平面语言（靠留白、线条、明度分层次），ios6 换的是维度：
    靠高光、阴影、渐变让每个表面"有厚度"。
    三条贯穿全皮肤的规则：
    ① 亮面在上、暗面在下（所有渐变统一 180deg，光从上方来）
    ② 每个凸起 = 1px 白色内高光 + 1px 深色下沿
    ③ 激活/开启 = 同一块蓝玻璃（#2E86DA→#0E63C4→#0A52A6），白字带向下投影
    只要所有组件遵守同一个光源和同一块蓝玻璃，零件再多也是一套系统。
    材质：页面底（顶部白光 + 1px/5px 横向拉丝，静态）、顶栏蓝灰塑料条、
    状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
2026-11-05 feat(panel): 新增 ios26 玻璃皮肤 + 修 ios6 底栏图标不可见
    一、ios6 底栏未选中图标看不清
    真因是子元素自带颜色：nav button{color} 不影响 .ic，而 .ic 有
    color:var(--c-text-3)，在 ios6 里是深灰 #4A4A4A，落在深色底栏上等于隐形。
    补 [data-skin="ios6"] nav button .ic{color:#D8E1EA}。
    教训：容器改色 ≠ 子元素改色，.ic/.mark/数值 span 这类都要一并覆盖。
    二、第六款皮肤 ios26（Liquid Glass）
    玻璃 = 折射 + 棱线 + 大圆角，缺一不可：
    - 折射 backdrop-filter:blur(18px) saturate(180%)，Safari 需 -webkit- 前缀
    - 棱线 inset 0 1px 0 rgba(255,255,255,.98) + 四周 1px 细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
2026-11-05 feat(panel): 电量改成分格电池图标 + 修玻璃顶栏/状态条接缝白框
    一、电量：不再显示数字，改成电池图标里的 5 格
    5 格 = 每格 20%，lit = ceil(pct*5/100)（不为 0 就至少亮一格）。
    未点亮格 opacity .22（试过 .16，分格语汇会消失，看着只剩一根线）。
    颜色仍走语义分级 battColor()：>50 正常 / 20~50 警告 / <20 危险，
    所以"还剩多少"余光可读。数字只留给读屏和悬停：aria-label + title，
    不显示数字 ≠ 丢掉信息。
    顺带省宽：原"数字 + % + 38px 细条"约 70px，现在 28px。
    batCells 在初始化时缓存，renderPower 只切 class 不重建 DOM。
    二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
2026-11-05 fix(panel): 电量分格改到底栏 tab 徽标，状态条恢复数字
    上一版弄反了：状态条不该用格子——顶栏下面那条要一眼读到精确值。
    正确分工：
    - 状态条：数字 + % + 4px 细条（恢复原样）
    - 底栏电池 tab 徽标：5 格小方块（每格 20%，ceil，不为 0 至少亮一格）
    徽标实现：2.5×7px 格子、间距 1px、圆角 .5px、未点亮 opacity .24，
    颜色仍走 battColor() 语义分级，数字只留给 aria-label / title。
    踩坑：徽标格子是 <i> 子元素，渲染时不能写 $('navSoc').textContent = pct+'%'——
    textContent 会清空所有子节点，格子被冲掉、徽标退回文字。必须切 on class。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
2026-11-05 fix(panel): 电量画进底栏电池图标 + 分段控件统一 + 玻璃状态条精修
    一、底栏电量：不是加徽标，直接改电池图标本身
    把 navBat 图标换成带 5 格的电池 SVG，靠 opacity 点亮（.cell/.cell.on）。
    SVG 直接写在 HTML 里而不是 data-icon 注入，避免被图标工厂覆盖；
    applySkin 统一改描边宽度时它也会跟着变。徽标彻底删掉。
    二、动效按钮文字竖排
    .seg .chip 原来是 flex:1，在 justify-content:space-between 的行里被压窄，
    中文每字都是断行点 → 变成一列字。改成 flex:1 1 auto + white-space:nowrap。
    实测 关 37px / 柔和 51px / 明显 51px，并排单行。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
2026-11-05 fix(panel): 电池外壳改跟主题色 + 修设置行被玻璃规则误加的直角白框
    一、电池图标：外壳跟主题，只有格子带语义色
    上一版整个图标都染成绿/琥珀/红，底栏里凭空多一块彩色，很突兀。
    拆两层：.shell 用 currentColor（底栏该项字色/选中强调色），
    .cell 用 var(--batt-col)（电量语义色，JS 只设这个变量）。
    实测 ios26 未选中外壳 rgb(85,98,116)、选中 rgb(10,95,192)，格子始终绿。
    二、设置行"直角加背景色"的真凶：.set-row 被玻璃选择器误伤
    玻璃皮肤那条长选择器列表里混进了 .set-row，于是每个设置行都得到
    1px 白边 + 直角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
2026-11-05 feat(panel): ios26 状态条改成分组读数（电量药丸 + 次要小字 + 时钟靠右）
    上一版是一排右对齐数字 + 三条竖线：电量/电流/剩余时间权重相同，
    眼睛没有落点；78% 和它后面的细条还是分离的两截，像两个控件的残余。
    改成 iOS 的分组读数，层级 = 药丸 > 小字：
    - 电量药丸：数字 + 百分比 + 细条装在同一个白色药丸里（rgba .72）
    - 电流药丸：第二层（rgba .46），数值不染色，只让方向箭头带语义色
    - 剩余时间/发电/电压退成 10px 标签 + 12px 数值的次要小字
    - justify-content:flex-start + 时钟 margin-left:auto，左侧是一组、右侧是一个
    - 状态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
2026-11-05 fix(panel): ios26 顶栏与状态条合成一片连续玻璃（修"分层不协调"）
    用户反馈：只在 ios26 有问题，且是"这条和顶栏的分层不协调"。
    两个原因叠在一起：
    1. 两段各自独立的渐变——顶栏 .72→.42，状态条又从 .42→.26 重新开始，
    渐变到终点就停止下行，交界处亮度会跳；
    2. 投影挂在 header 上，等于在顶栏和状态条之间画了一道分界阴影。
    修法：整片玻璃只有一个上沿和一个下沿
    - header 渐变 .80→.46，只保留顶部内高光，去掉外投影；
    - statusbar 从 .46 接着走到 .34，承担整片唯一的底沿：1px 暗发丝 + 一层投影。
    验证：取一列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
2026-11-05 feat(panel): 情景模式从"两个大按钮"改成"只读状态行"，与快捷开关区分开
    先查固件：情景档位是 base.yaml 的 globals，只由物理按键的 *_scene_next 脚本推进；
    scene-state.yaml 只暴露 3 个 template sensor 供 /sensor 读取，没有 select/number/button
    实体 → REST 写不了档位，"点击切档的分段选择器"需要先改固件，另开工单。
    为什么改：两组实测是同一个控件的样子（18px 圆角、1px 描边、白半透明底、
    accent 描边选中态），而情景是 cursor:default / onclick:null / aria-readonly——
    只读控件长得像按钮，用户会一直点然后以为坏了。旧版靠"按键"角标解释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
